riaj0224/DriverlessRoboticNurse_MrWas/Ejemplos/InputCapture/README.md

# InputCapture
Esta carpeta contiene programas para la lectura de sensores y transductores
