riaj0224/DriverlessRoboticNurse_MrWas/Ejemplos/PWM/README.md

# PWM
Esta carpeta contiene programas para el control de componentes por PWM
