riaj0224/DriverlessRoboticNurse_MrWas/Ejemplos/UART RX/README.md

# UART RX
Esta carpeta contiene programas para recibir datos por UART
