riaj0224/DriverlessRoboticNurse_MrWas/Ejemplos/UART TX/README.md

# UART TX
En esta carpeta se incluyen programas para la transmisión de datos por UART
