riaj0224/DriverlessRoboticNurse_MrWas/Ejemplos/ADC/README.md

# ADC
Esta carpeta contiene varios programas del funcionamiento de un ADC por uno y varios canales
