riaj0224/DriverlessRoboticNurse_MrWas/Ejemplos/README.md

# EJEMPLOS
Esta carpeta contiene los ejemplos de todos los programas hechos hasta el momento para diferentes funciones
