riaj0224/DriverlessRoboticNurse_MrWas/Ejemplos/LPTMR/README.md

# LPTMR
En esta carpeta se incluyen programas para el accionar de un LPTMR, así como su combinación con programas previos
