riaj0224/DriverlessRoboticNurse_MrWas/Ejemplos/GPIO/README.md

# GPIO
Esta carpeta contiene programas de ejemplo para la implementación de la función GPIO del micro
