riaj0224/DriverlessRoboticNurse_MrWas/Doc/manufacturing_drawings.pdf

# Entrega final mecánica reto

# Equipo 3: Violeta

# Laura M Zambrano Gamiño A01630766

# Renatto Tommasi Hernández A01632098

# Jesús Jair Reyes Gutiérrez A01630762

# Susana Monserrat Reyes Márquez A01636161

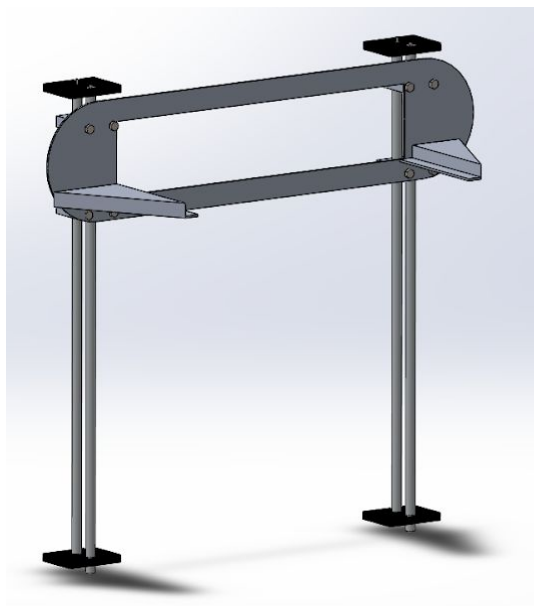
[picture p32: figure]

# Entrega final mecánica reto

# I. Material original

### Materiales Presentes

### Aluminio aleación 1060

### Acero Inoxidable

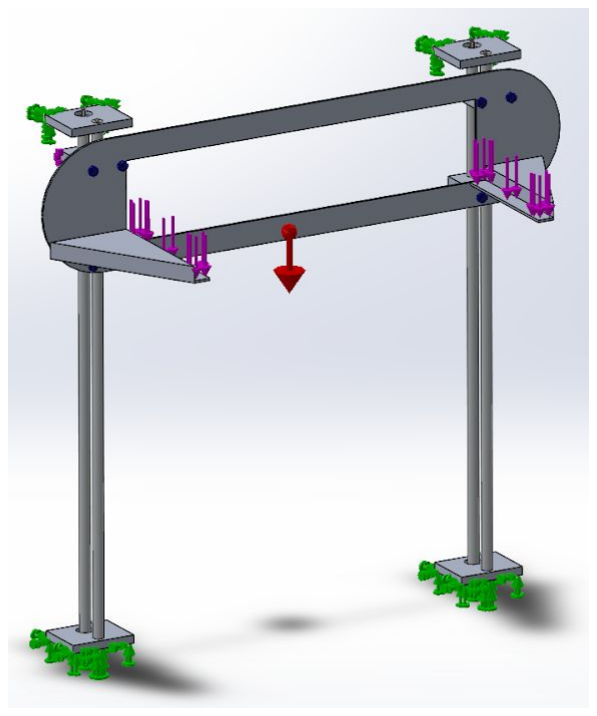
[picture p33: figure]

### Cargas

Nombre/Color | Valor | Ubicación
Gravedad / Rojo | Predeterminado | Estructura
Charola con comida / Morado | 9.81 N | Tenazas

### Resultados

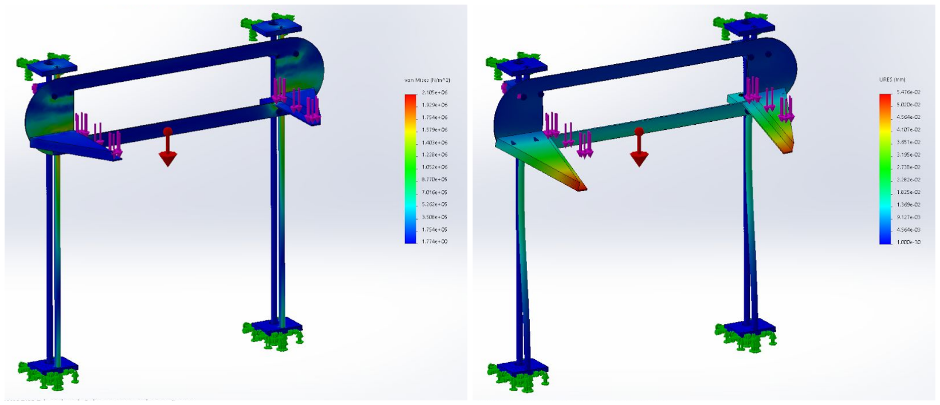
[picture p34: figure]
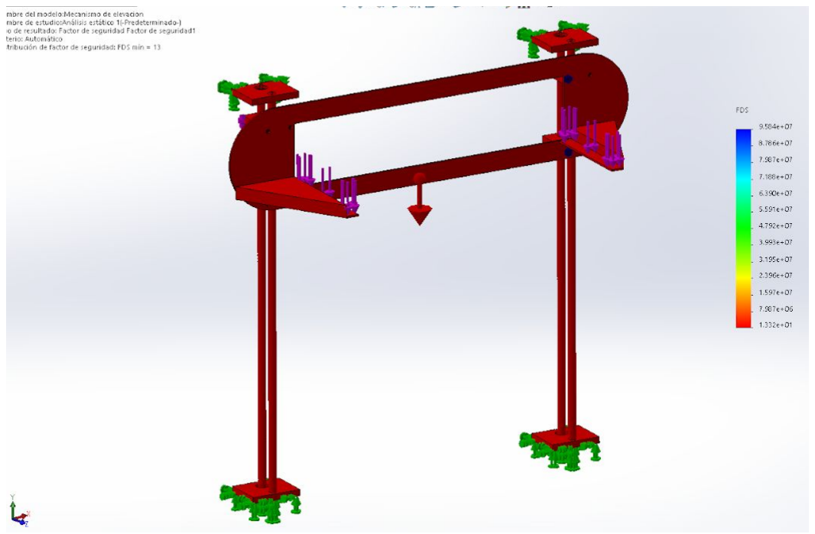
[picture p35: figure]

| Cantidad | Lugar
Esfuerzo mayor | 2.105 MPa | Frente y detrás de los ejes frontales
Esfuerzo menor | 0.001 MPa | Travesaño de la boca, ejes traseros
Desplazamiento mayor | 0.0547 mm | Punta de las tenazas
Desplazamiento menor | 0.000 mm | Ejes traseros, parte superior de boca y bases
Factor de seguridad mínimo | 13

II. | Criterios de selección:
| Para la selección del material, se utilizó el software GRANTA Edupack 2020, con el
| se realizó un extenso filtrado de todos los materiales en el nivel 3 para obtener únicamente
| los que mejor se adaptaran a las necesidades del mecanismo. El primer criterio de filtrado
| consistió en que el nuevo material tuviera tan solo una porción del módulo de Young del
| material original en proporción al factor de seguridad obtenido y al deseado. Esto con el
| propósito de reducirlo lo más posible y acercarlo a uno razonable. Sin embargo, con este
| primer filtrado todavía había varias opciones.
| Ahora bien, el segundo criterio consiste un poco más en tomar en consideración el
| resto de los mecanismos y subensamblajes, pues un cambio importante en el peso se
| traduciría en una reducción del factor de seguridad y por ende un riesgo a toda a la
| estructura. Por lo que el segundo parámetro fue la densidad y esta no podía ser mayor a la
| del material original pues directamente se traduciría en más peso, fuerzas, momentos y
| torsiones. Después de aplicar el segundo filtro, las opciones se redujeron a tan solo 8: 3
| fibras de epoxy con algún otro compuesto, 4 fibras de e - vidrio con otro compuesto y
| carbono impregnado de metal (“metal impregnated carbon”). Este último fue el elegido
| después de consultarlo con otros expertos, dado el extenso desconocimiento sobre el tema.
| Un dato importante es que también se quiso hacer un tercer filtrado de acuerdo con
| el precio, buscando que el material alternativo fuese más barato, pero esto resultó imposible,
| dado que no hubo resultados.

# III. Resultados con material nuevo

### Materiales Presentes

### Aluminio aleación 1060

### Carbón impregnado con metal (Metal Impregnated Carbon)

### Acero Inoxidable

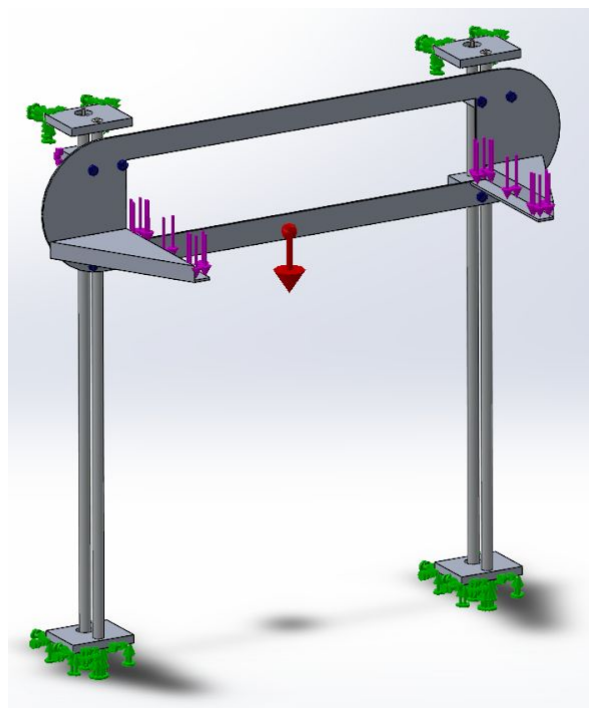
[picture p36: figure]

### Cargas

Nombre/Color | Valor | Ubicación
Gravedad / Rojo | Predeterminado | Estructura
Charola con comida / Morado | 9.81 N | Tenazas

### Resultados

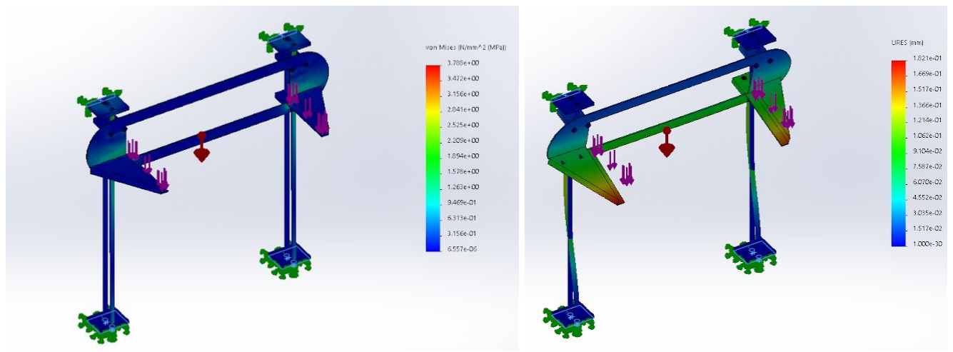
[picture p37: figure]
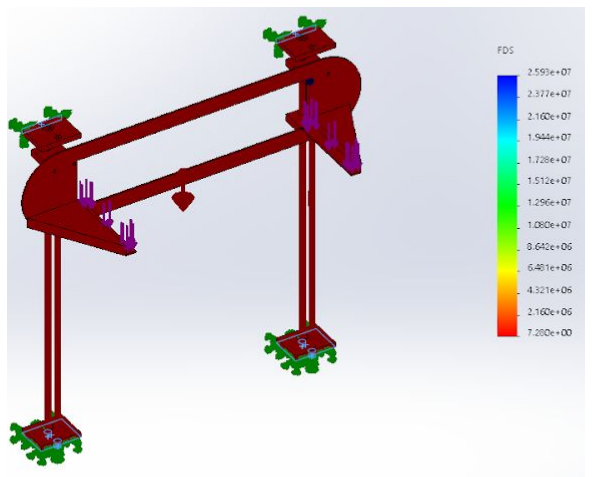
[picture p38: figure]

| Cantidad | Lugar
Esfuerzo mayor | 3.788 Mpa | Frente y detrás de los ejes frontales
Esfuerzo menor | 0.001 MPa | Travesaño de la boca, ejes traseros
Desplazamiento mayor | 0.1821 mm | Punta de las tenazas
Desplazamiento menor | 0.000 mm | Ejes traseros, parte superior de boca y bases
Factor de seguridad mínimo | 7.3

IV. | Comparación y análisis
| Tras el análisis de elemento finito realizado en el mecanismo con los dos materiales

diferentes, podemos concluir varias cosas. Lo primero que cabe resaltar es que únicamente fueron

reemplazadas 2 piezas: el material de los ejes lineales que originalmente eran de acero inoxidable.

El diseño original brindaba gran rigidez al mecanismo, evitando que se deformara por cualquier

exceso de peso. Esto creó un mecanismo muy robusto de un factor de seguridad muy alto. A causa

de esto, el peso de los ejes de acero inoxidable era bastante significante y podría llegar a presentar

mucho gasto de batería en el tren motriz del robot. Podemos observar que gracias a que el nuevo

material tiene una menor densidad y menor resistencia, el mecanismo llega a deformarse antes que

el diseño original, pero sigue estando dentro del espectro donde se consideraría que el diseño es

suficientemente robusto para un sistema de constante movimiento. Además, gracias a la menor

densidad del material, el peso del mecanismo en general se vió ampliamente reducido. Ambos

materiales le ofrecen al mecanismo gran rigidez y tenacidad, A pesar de que el acero inoxidable es

# más rígido que el carbón, el nuevo material le permite al mecanismo aprovechar mejor las

propiedades mecánicas del mismo.

# V. Conclusión

| Se redujo considerablemente el factor de seguridad, lo que se puede traducir a que el

material más sobrado e innecesario es la primera opción, el acero inoxidable. La seguridad es uno

de los puntos más importantes al diseñar cualquier cosa, pero tener un factor de seguridad tan

sobrado significa que el material elegido no está siendo aprovechado al máximo y que se debería

# buscar algún otro. La tecnología actual permite la creación de materiales con propiedades

mecánicas diferentes, que se pueden adaptar mejor a las necesidades del usuario, el carbón

impregnado con metal es uno de estos materiales. El acero inoxidable es más común en el mercado y como es demostrado en el estudio presentado es un material resistente, pero quizá demasiado

resistente para el uso que se le da en este mecanismo. El carbón impregnado con metal es un

material muy nuevo, de ahí que no tenga muchos distribuidores y el precio esté más elevado, pero

se acomoda mejor a nuestro diseño demostrando tener un factor de seguridad menor. En caso de

que el presente robot se fabricara de forma rápida, la mejor opción sería quedarse con el acero

inoxidable por su facilidad de compra.

# VI. Bibliografía

# Metal impregnated carbon. (n.d.). GRANTA EduPack

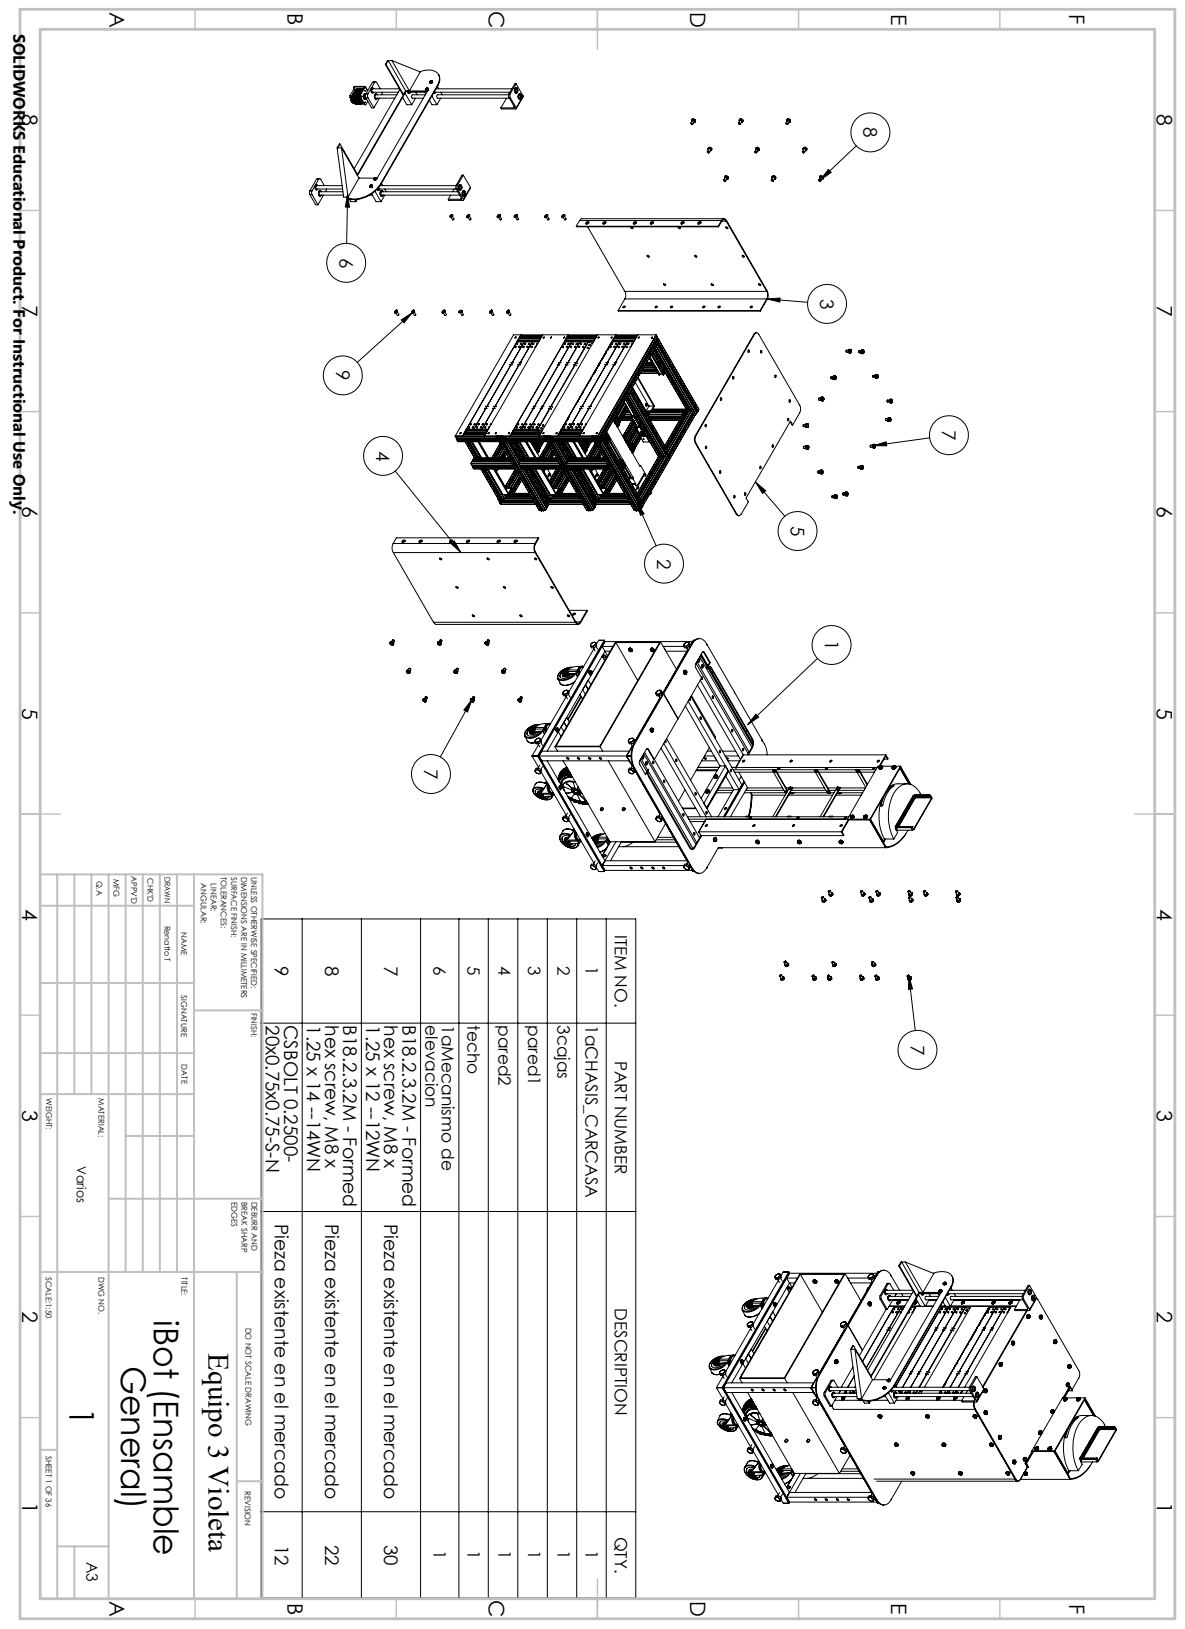
[picture p39: page 9]
1 1aCHASIS_CARCASA 1; 2 3cajas 1; 3 pared1 1; 4 pared2 1; 5 techo 1; 6 elevacion; 1aMecanismo de 1; hex screw, M8 x B18.2.3.2M - Formed; MFG; APPV'D; CHK'D; DRAWN; ANGULAR:; LINEAR:; TOLERANCES:; SURFACE FINISH:; EDGES BREAK SHARP; DEBURR AND; MATERIAL:; SCALE:1:50; DWG NO.; TITLE:; SHEET 1 OF 36; A3 Varios; WEIGHT:; Renatto T; Equipo 3 Violeta

SOLIDWORKS Educational Product. For Instructional Use Only.

DIMENSIONS ARE IN MILLIMETERS

UNLESS OTHERWISE SPECIFIED: FINISH:

NAME SIGNATURE DATE

ITEM NO. PART NUMBER DESCRIPTION QTY.

CSBOLT 0.2500- Pieza existente en el mercado 12

Pieza existente en el mercado 22

Pieza existente en el mercado 30

iBot (Ensamble General)

DO NOT SCALE DRAWING REVISION

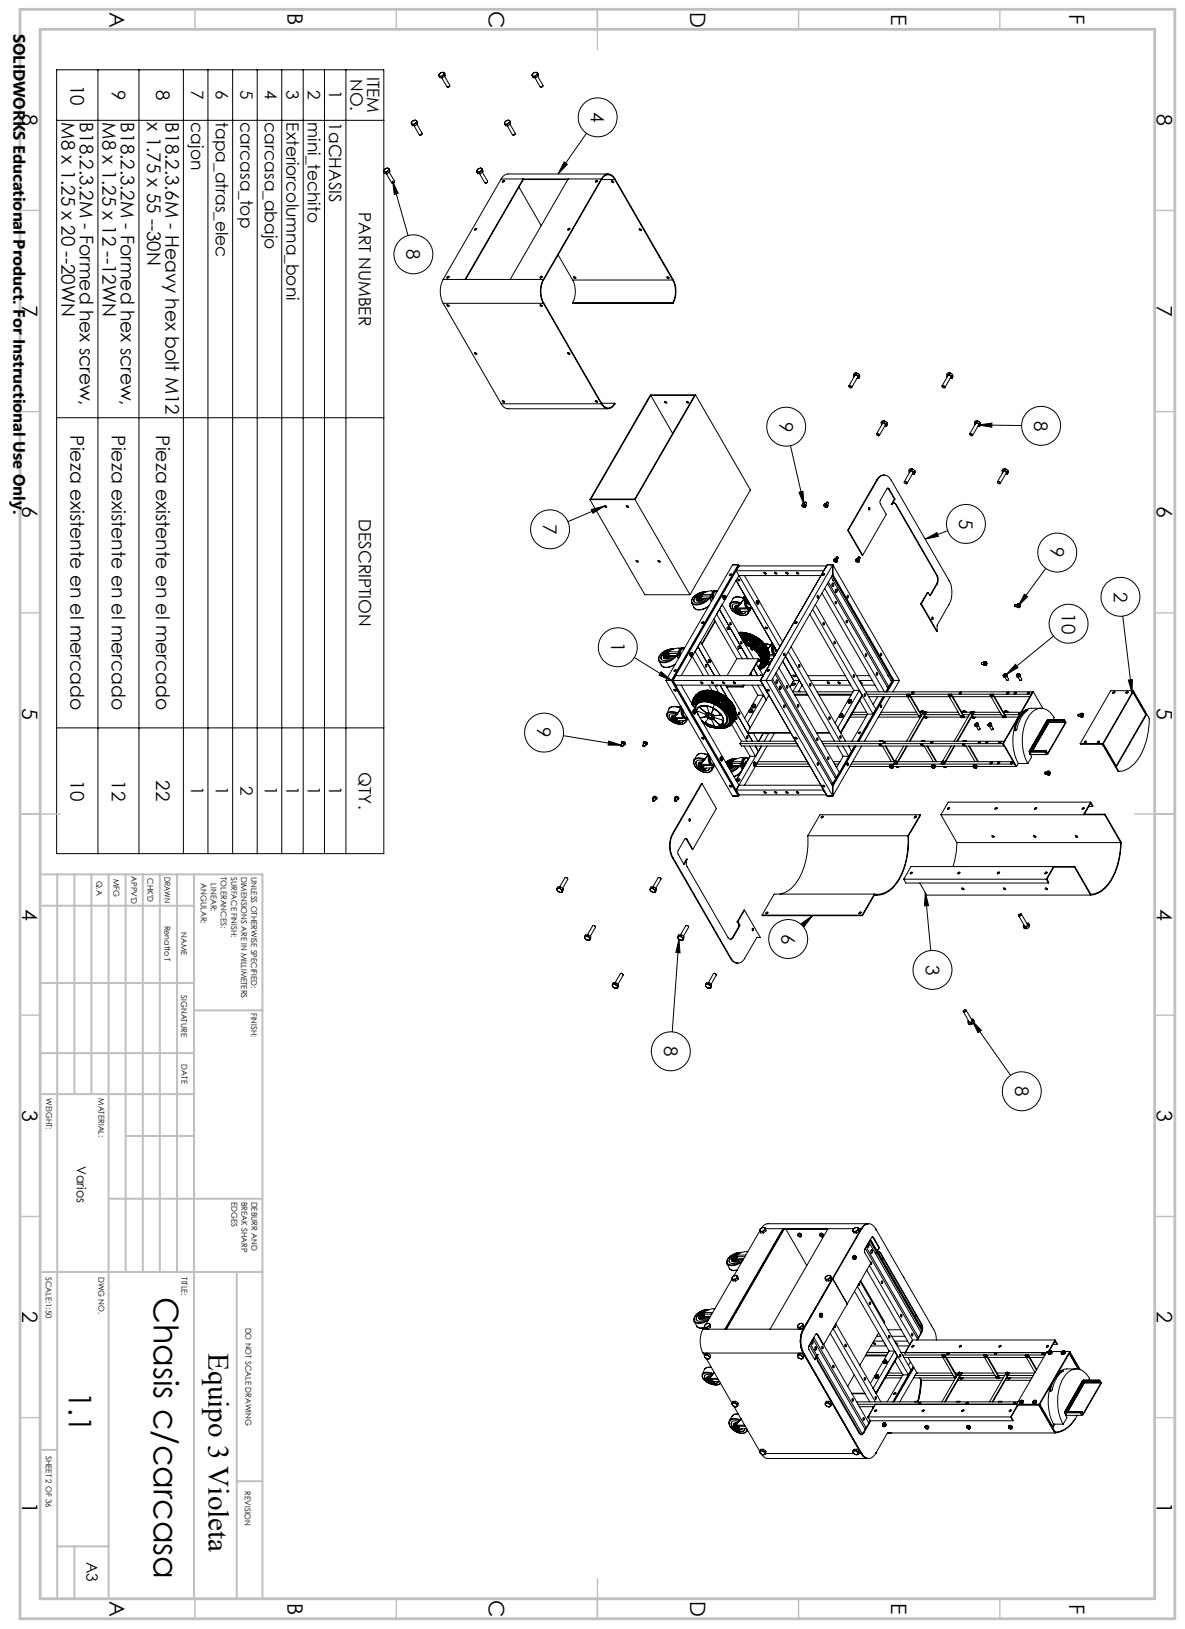
[picture p40: page 10]
NO. 1 1aCHASIS 1 2 mini_techito 1 3 Exteriorcolumna_boni 1 4 carcasa_abajo 1; 5 carcasa_top 2; 6 tapa_atras_elec 1; 7 cajon 1; MFG; APPV'D; CHK'D; DRAWN; ANGULAR:; LINEAR:; TOLERANCES:; SURFACE FINISH:; EDGES BREAK SHARP; DEBURR AND; MATERIAL:; SCALE:1:50; DWG NO.; TITLE:; SHEET 2 OF 36; A3 Varios; WEIGHT:; Renatto T; Equipo 3 Violeta; Chasis c/carcasa

SOLIDWORKS Educational Product. For Instructional Use Only.

ITEM PART NUMBER DESCRIPTION QTY.

B18.2.3.2M - Formed hex screw, Pieza existente en el mercado 10

B18.2.3.2M - Formed hex screw, Pieza existente en el mercado 12

B18.2.3.6M - Heavy hex bolt M12 Pieza existente en el mercado 22

DIMENSIONS ARE IN MILLIMETERS

UNLESS OTHERWISE SPECIFIED: FINISH:

NAME SIGNATURE DATE

DO NOT SCALE DRAWING REVISION

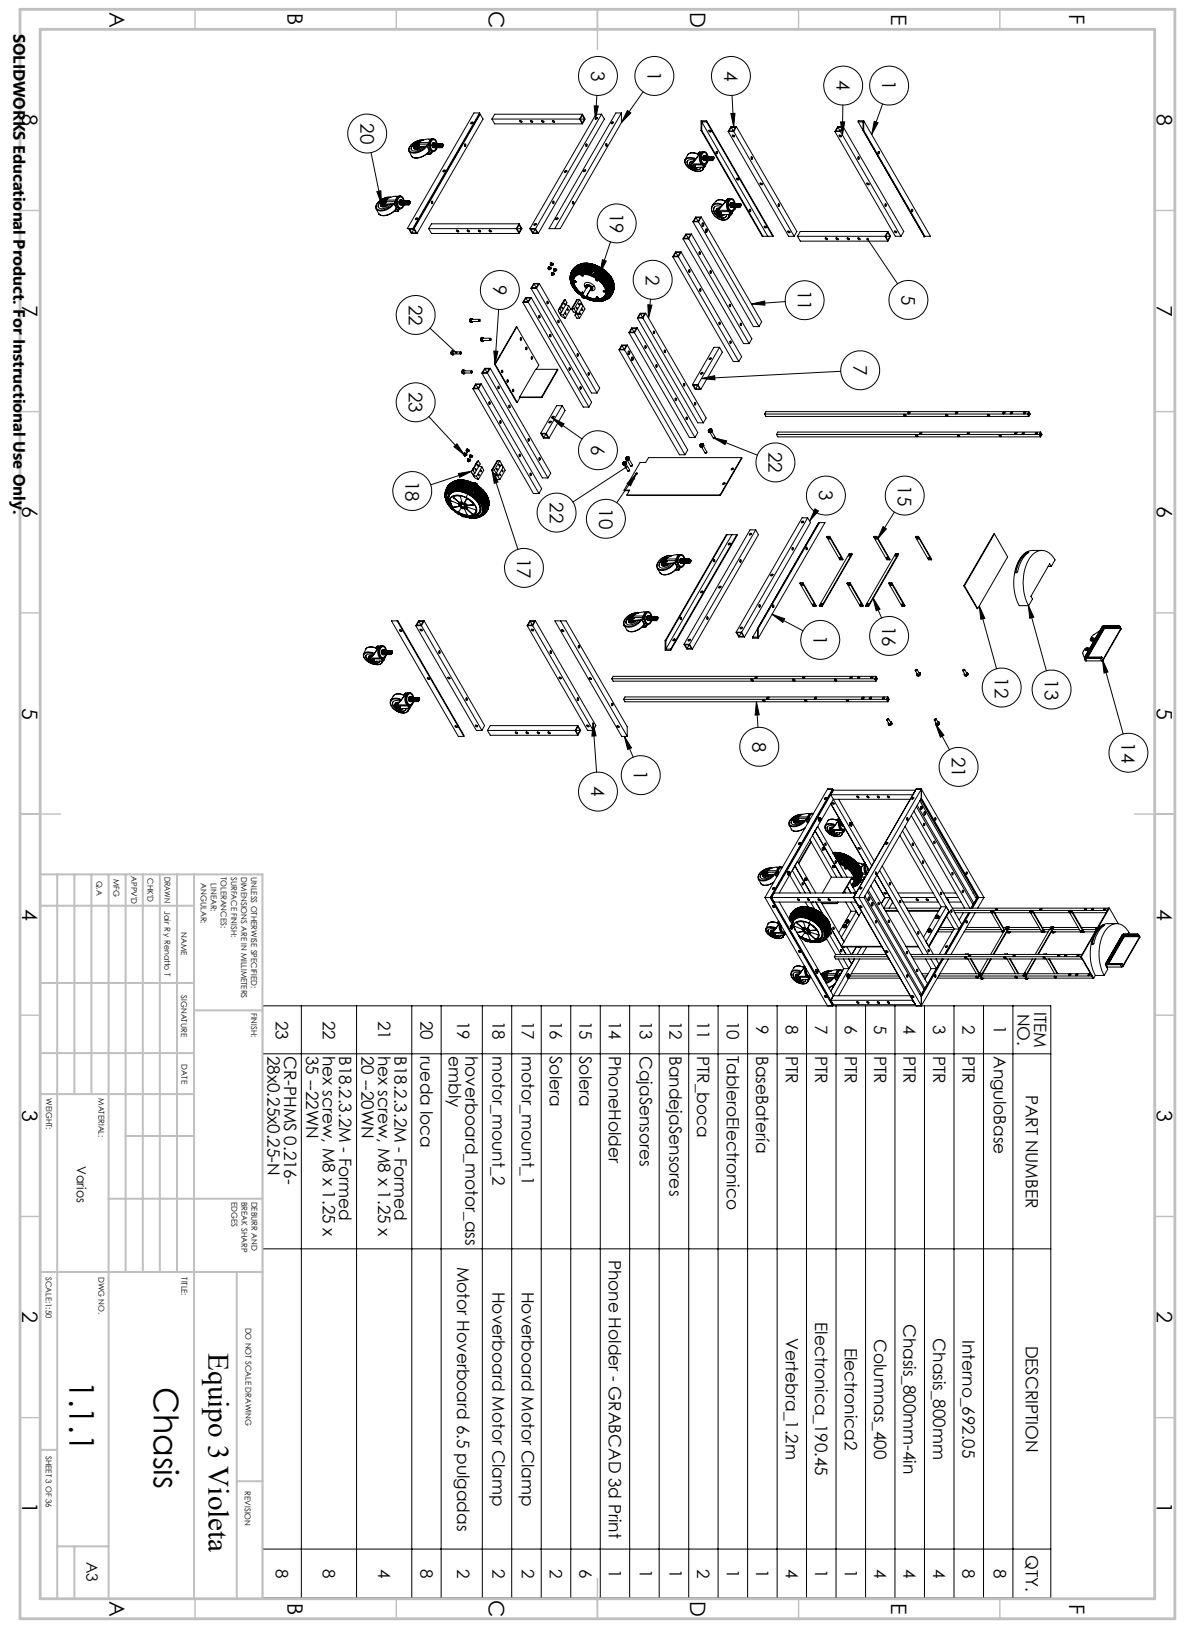
[picture p41: page 11]
1 AnguloBase 8; 2 PTR Interno_692.05 8; 3 PTR Chasis_800mm 4; 4 PTR Chasis_800mm-4in 4; 5 PTR Columnas_400 4; 6 PTR Electronica2 1; 7 PTR Electronica_190.45 1; 8 PTR Vertebra_1.2m 4; 9 BaseBatería 1; 10 TableroElectronico 1; 11 PTR_boca 2; 12 BandejaSensores 1; 13 CajaSensores 1; 15 Solera 6; 16 Solera 2; 19 embly; 20 rueda loca 8; 20 --20WN hex screw, M8 x 1.25 x; B18.2.3.2M - Formed; 35 --22WN hex screw, M8 x 1.25 x; 23 28x0.25x0.25-N CR-PHMS 0.216- 8; MFG; APPV'D; CHK'D; DRAWN; ANGULAR: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

SOLIDWORKS Educational Product. For Instructional Use Only.

DIMENSIONS ARE IN MILLIMETERS

UNLESS OTHERWISE SPECIFIED: FINISH:

NAME SIGNATURE DATE

18 motor_mount_2 Hoverboard Motor Clamp 2

17 motor_mount_1 Hoverboard Motor Clamp 2

14 PhoneHolder Phone Holder - GRABCAD 3d Print 1

ITEM PART NUMBER DESCRIPTION QTY.

hoverboard_motor_ass Motor Hoverboard 6.5 pulgadas 2

DO NOT SCALE DRAWING REVISION

22.23
22.23

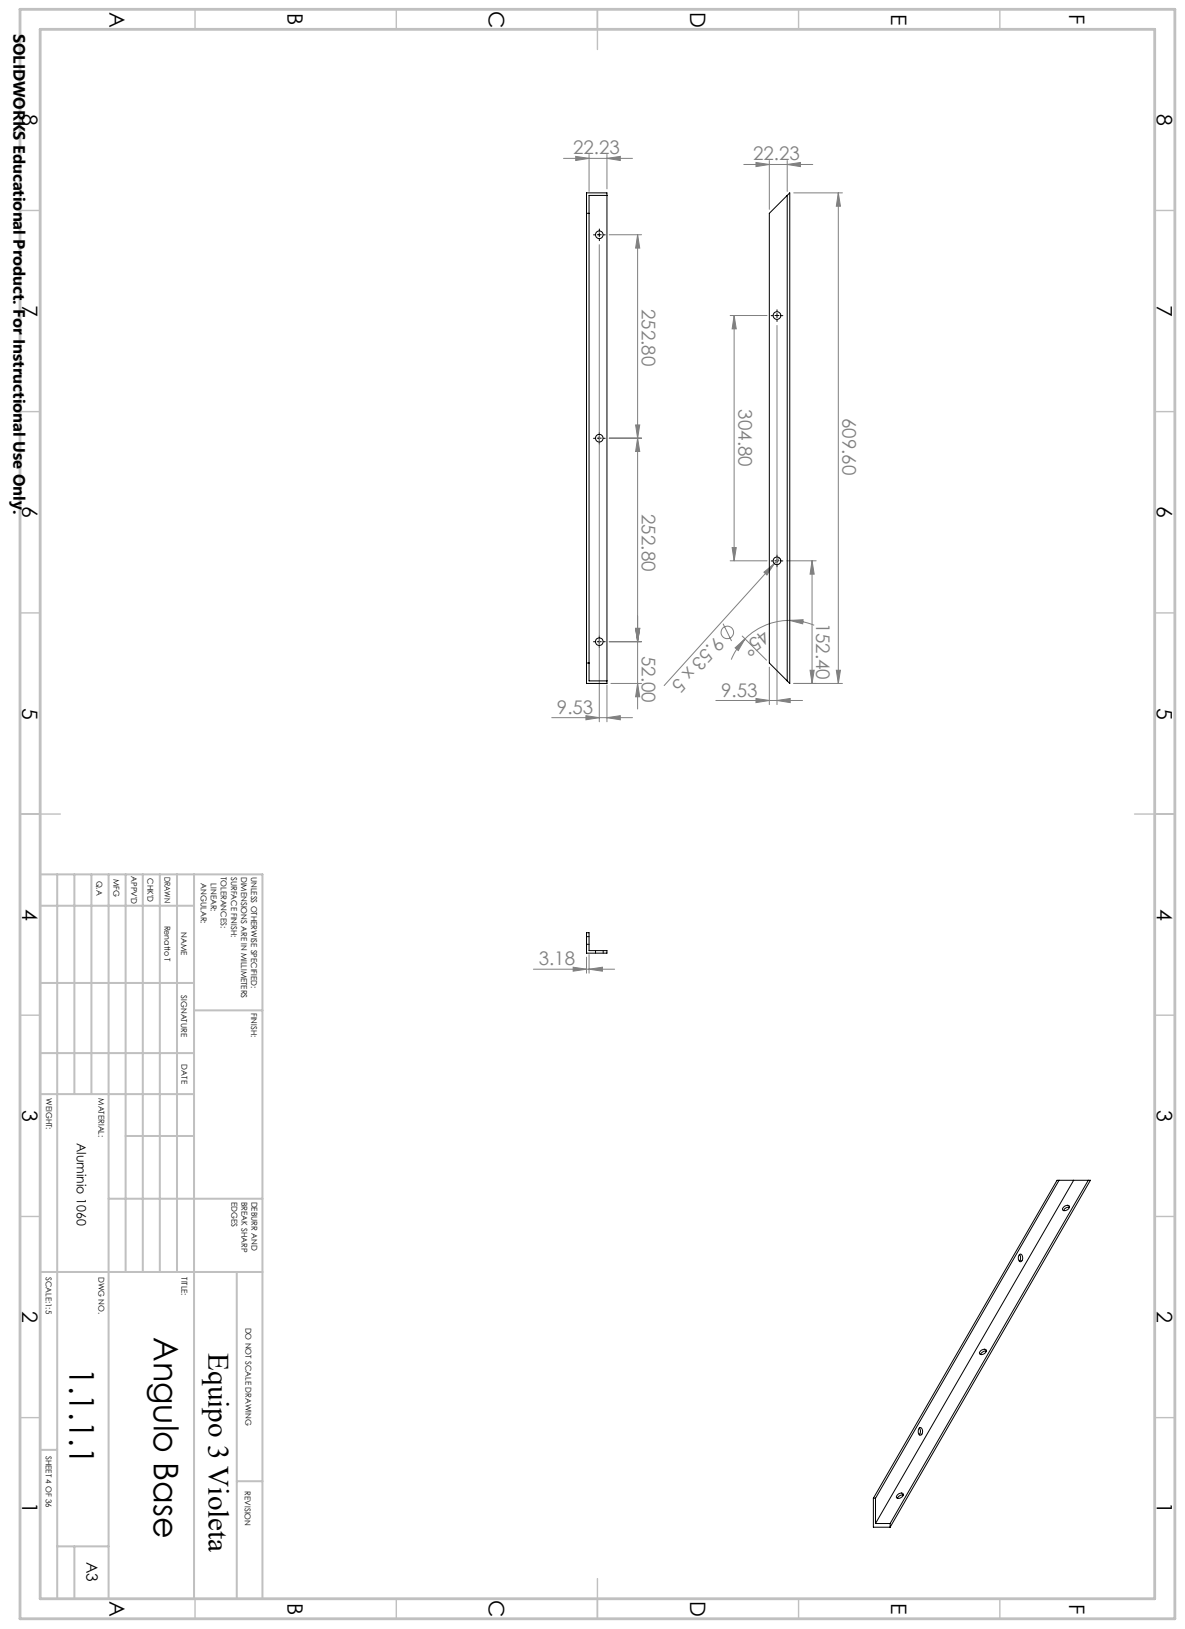
[picture p42: page 12]
MFG; APPV'D; CHK'D; DRAWN; ANGULAR:; LINEAR:; TOLERANCES:; SURFACE FINISH:; EDGES BREAK SHARP; DEBURR AND; MATERIAL:; SCALE:1:5; DWG NO.; TITLE:; SHEET 4 OF 36; A3 Aluminio 1060; WEIGHT:; Renatto T; Equipo 3 Violeta; Angulo Base

SOLIDWORKS Educational Product. For Instructional Use Only.

DIMENSIONS ARE IN MILLIMETERS

UNLESS OTHERWISE SPECIFIED: FINISH:

NAME SIGNATURE DATE

DO NOT SCALE DRAWING REVISION

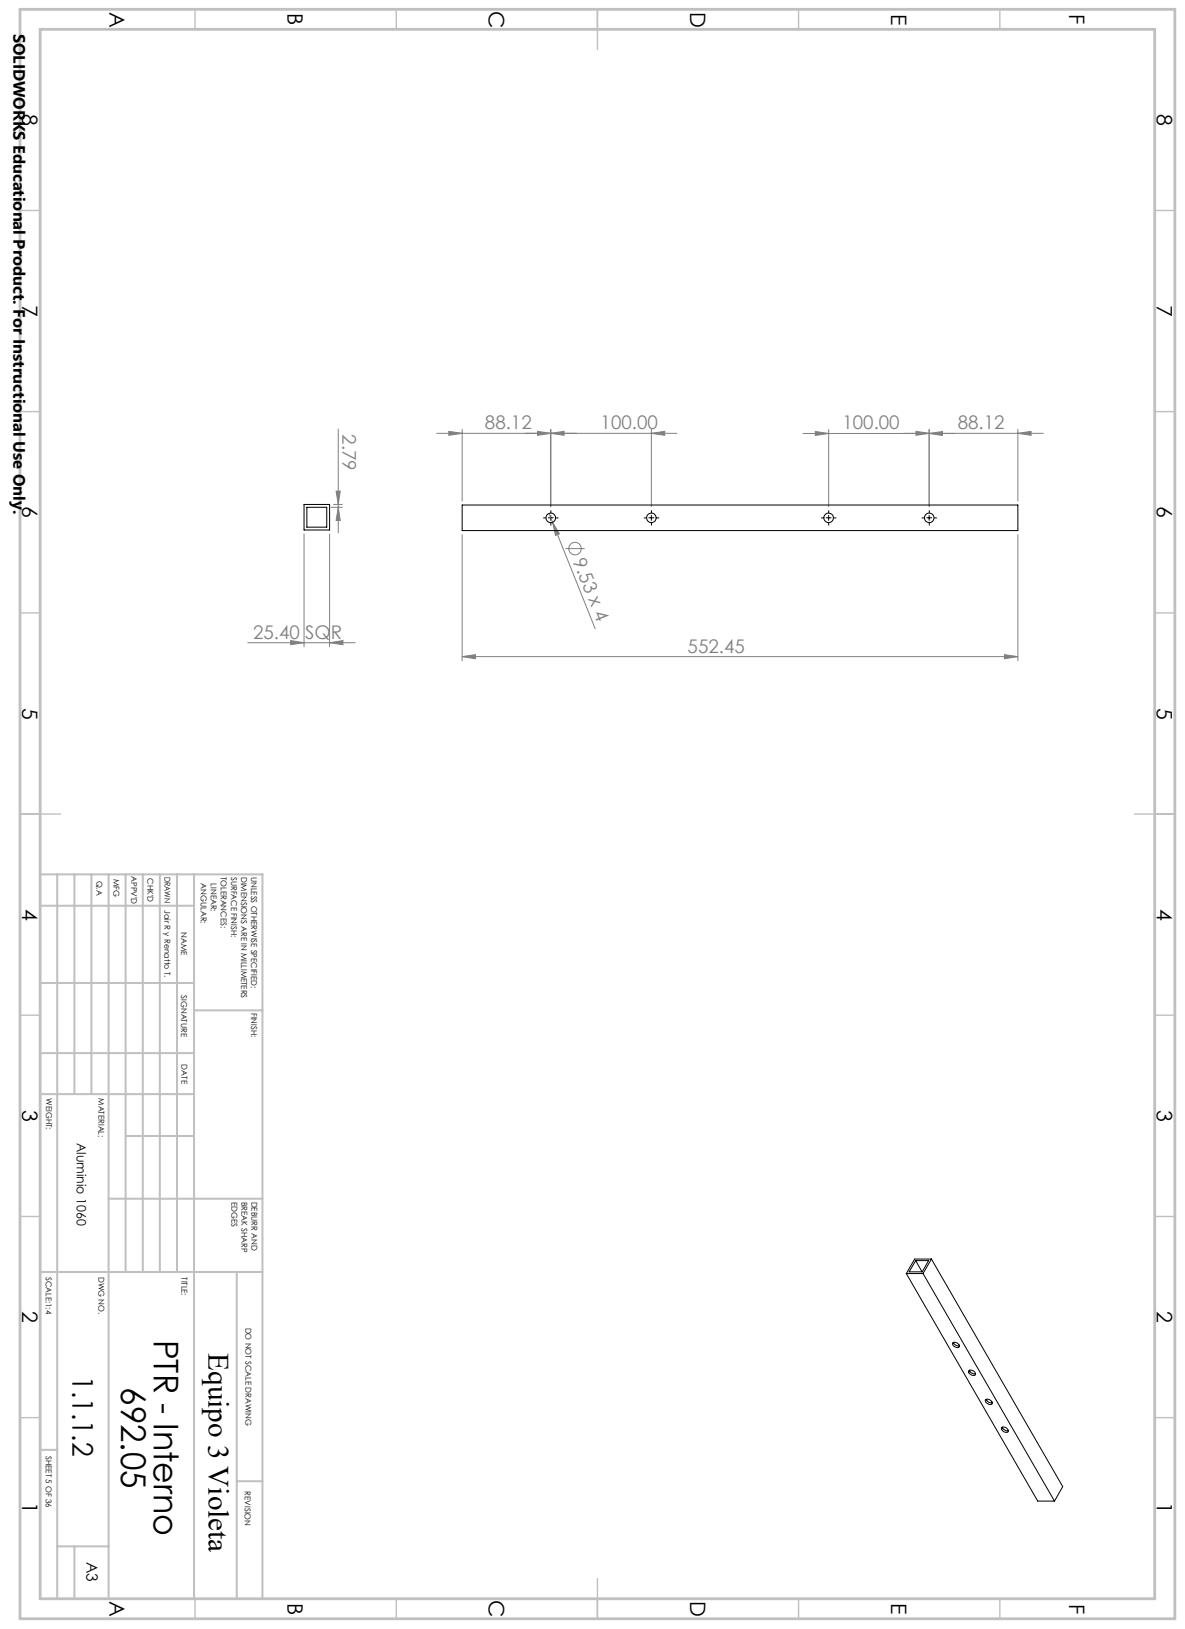
[picture p43: page 13]
25.40 SQR; MFG; APPV'D; CHK'D; DRAWN; ANGULAR:; LINEAR:; TOLERANCES:; SURFACE FINISH:; EDGES BREAK SHARP; DEBURR AND; MATERIAL:; SCALE:1:4; DWG NO.; TITLE:; SHEET 5 OF 36; A3 Aluminio 1060; WEIGHT:; Jair R y Renatto T.; Equipo 3 Violeta; PTR - Interno 692.05

SOLIDWORKS Educational Product. For Instructional Use Only.

DIMENSIONS ARE IN MILLIMETERS

UNLESS OTHERWISE SPECIFIED: FINISH:

NAME SIGNATURE DATE

DO NOT SCALE DRAWING REVISION

150.81 | 150.81

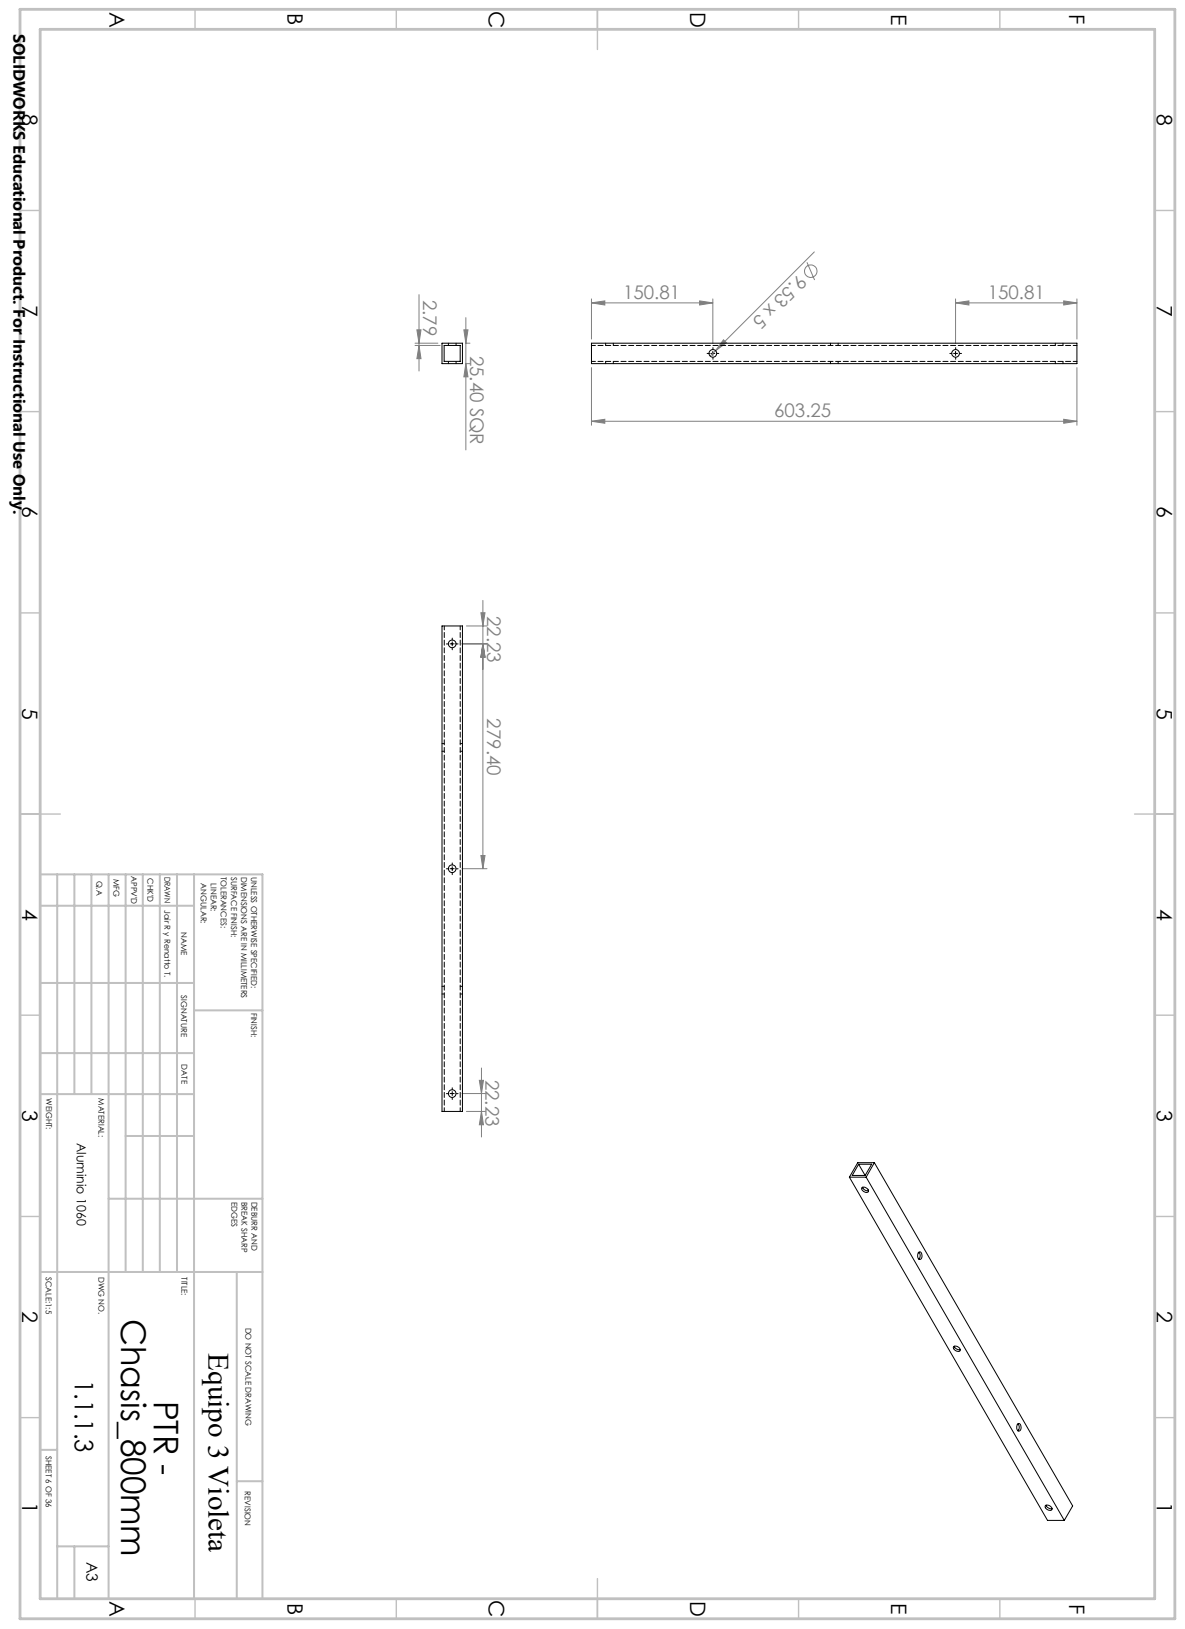
[picture p44: page 14]
25.40 SQR; MFG; APPV'D; CHK'D; DRAWN; ANGULAR:; LINEAR:; TOLERANCES:; SURFACE FINISH:; EDGES BREAK SHARP; DEBURR AND; MATERIAL:; SCALE:1:5; DWG NO.; TITLE:; SHEET 6 OF 36; A3 Aluminio 1060; WEIGHT:; Jair R y Renatto T.; Equipo 3 Violeta; PTR -; Chasis_800mm

SOLIDWORKS Educational Product. For Instructional Use Only.

DIMENSIONS ARE IN MILLIMETERS

UNLESS OTHERWISE SPECIFIED: FINISH:

NAME SIGNATURE DATE

DO NOT SCALE DRAWING REVISION

152.40 | 152.40

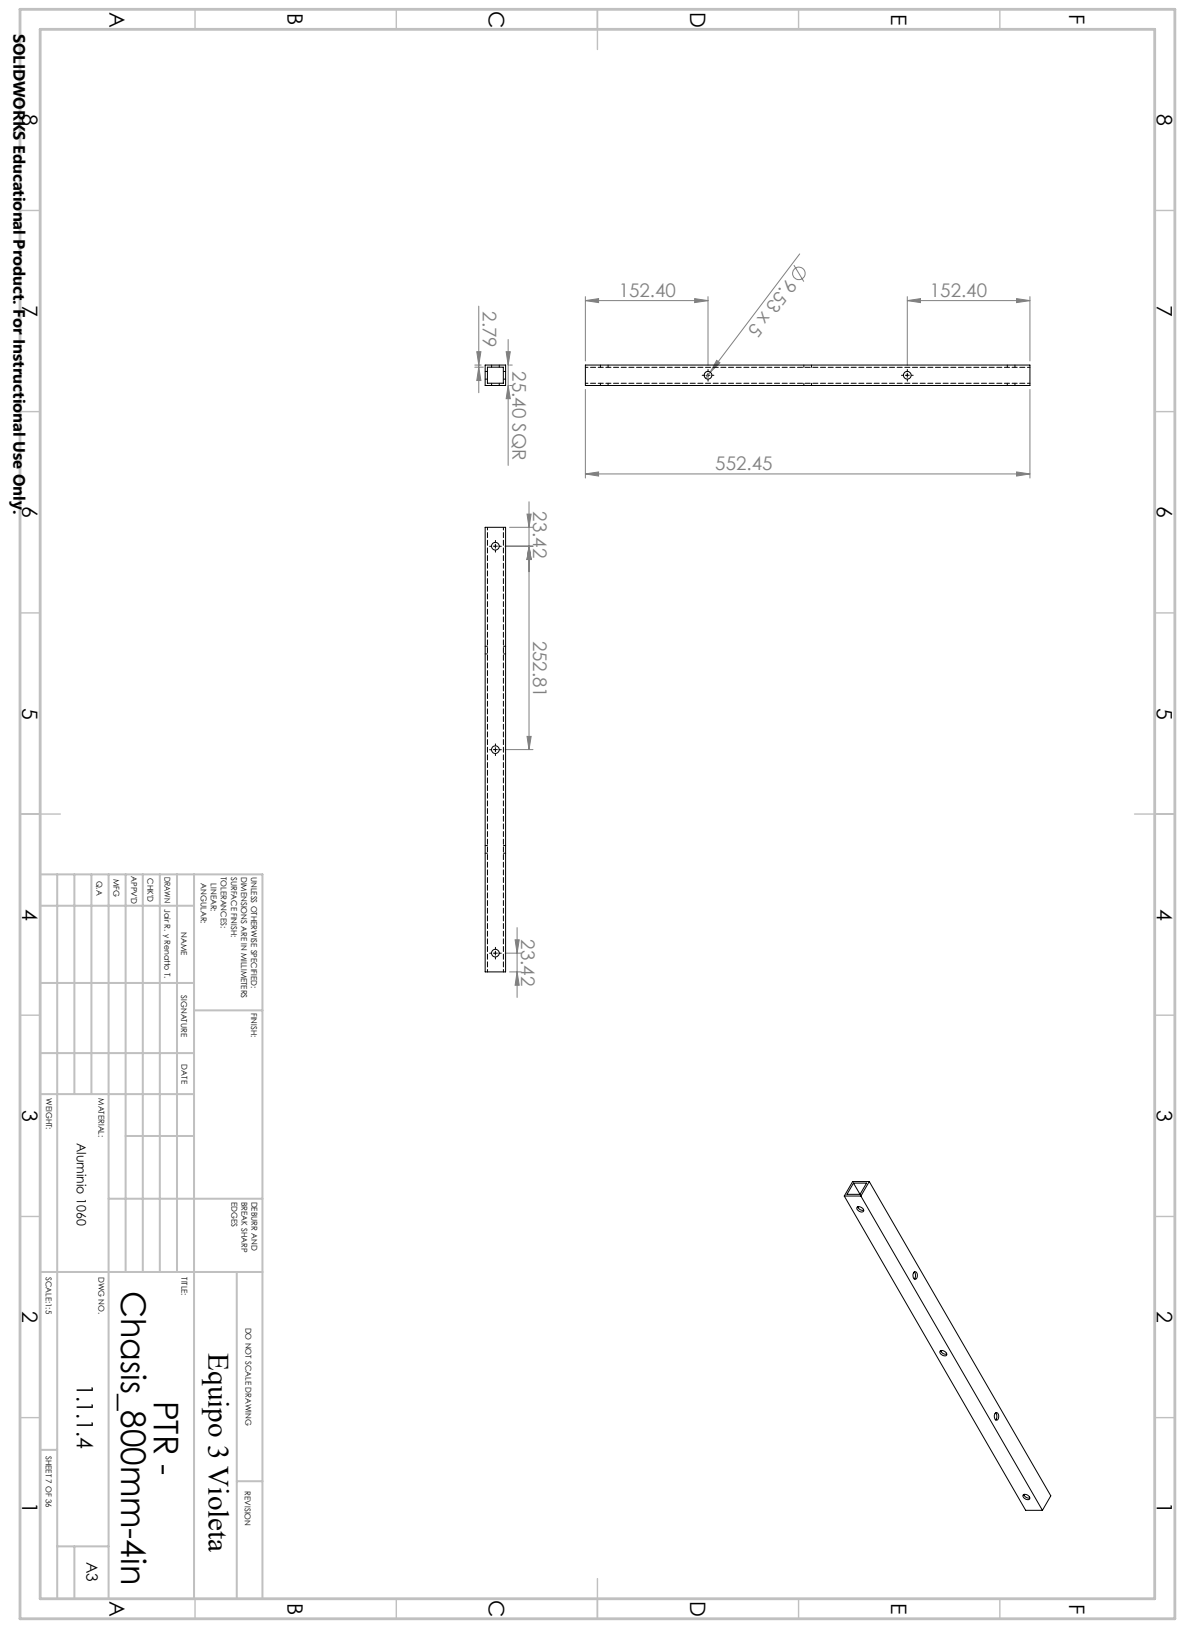
[picture p45: page 15]
25.40 SQR 552.45; MFG; APPV'D; CHK'D; DRAWN; ANGULAR:; LINEAR:; TOLERANCES:; SURFACE FINISH:; EDGES BREAK SHARP; DEBURR AND; MATERIAL:; SCALE:1:5; DWG NO.; TITLE:; SHEET 7 OF 36; A3 Aluminio 1060; WEIGHT:; Jair R. y Renatto T.; Equipo 3 Violeta; PTR -; Chasis_800mm-4in

SOLIDWORKS Educational Product. For Instructional Use Only.

DIMENSIONS ARE IN MILLIMETERS

UNLESS OTHERWISE SPECIFIED: FINISH:

NAME SIGNATURE DATE

DO NOT SCALE DRAWING REVISION

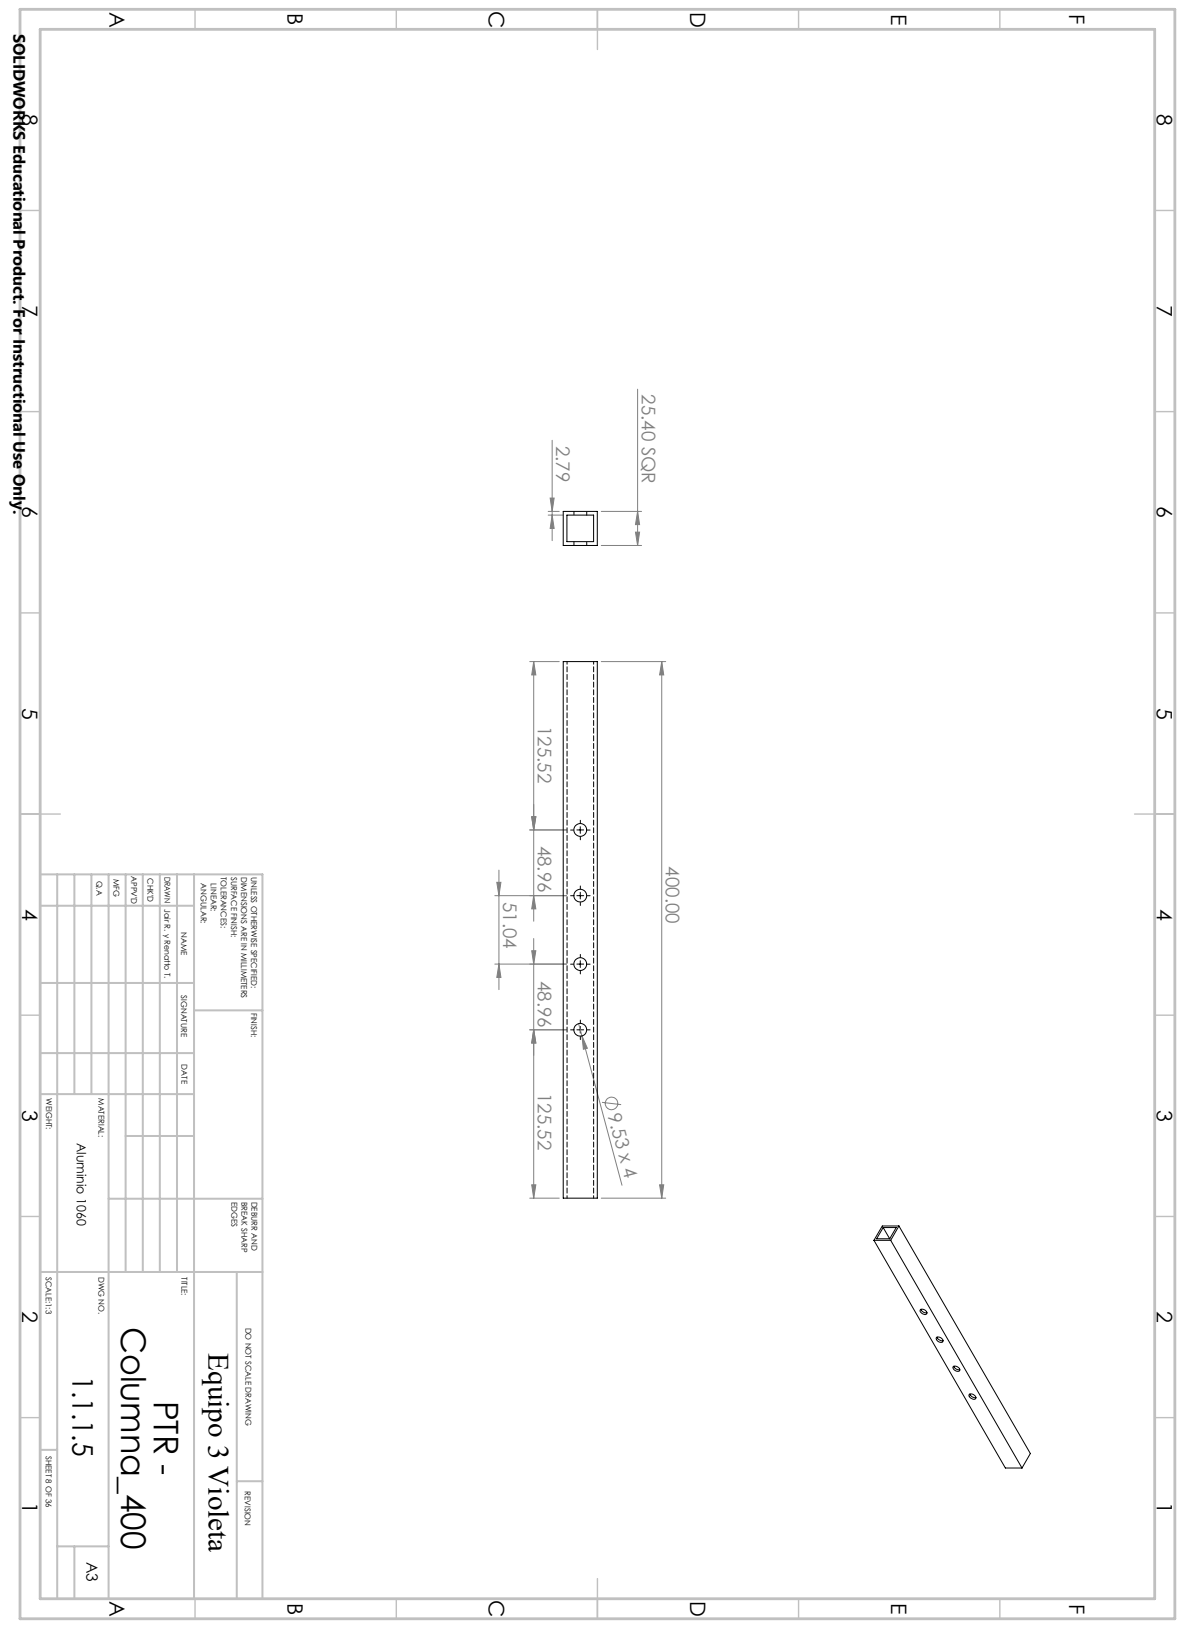
[picture p46: page 16]
25.40 SQR; MFG; APPV'D; CHK'D; DRAWN; ANGULAR:; LINEAR:; TOLERANCES:; SURFACE FINISH:; EDGES BREAK SHARP; DEBURR AND; MATERIAL:; SCALE:1:3; DWG NO.; TITLE:; SHEET 8 OF 36; A3 Aluminio 1060; WEIGHT:; Jair R. y Renatto T.; Equipo 3 Violeta; PTR -; Columna_400

SOLIDWORKS Educational Product. For Instructional Use Only.

DIMENSIONS ARE IN MILLIMETERS

UNLESS OTHERWISE SPECIFIED: FINISH:

NAME SIGNATURE DATE

DO NOT SCALE DRAWING REVISION

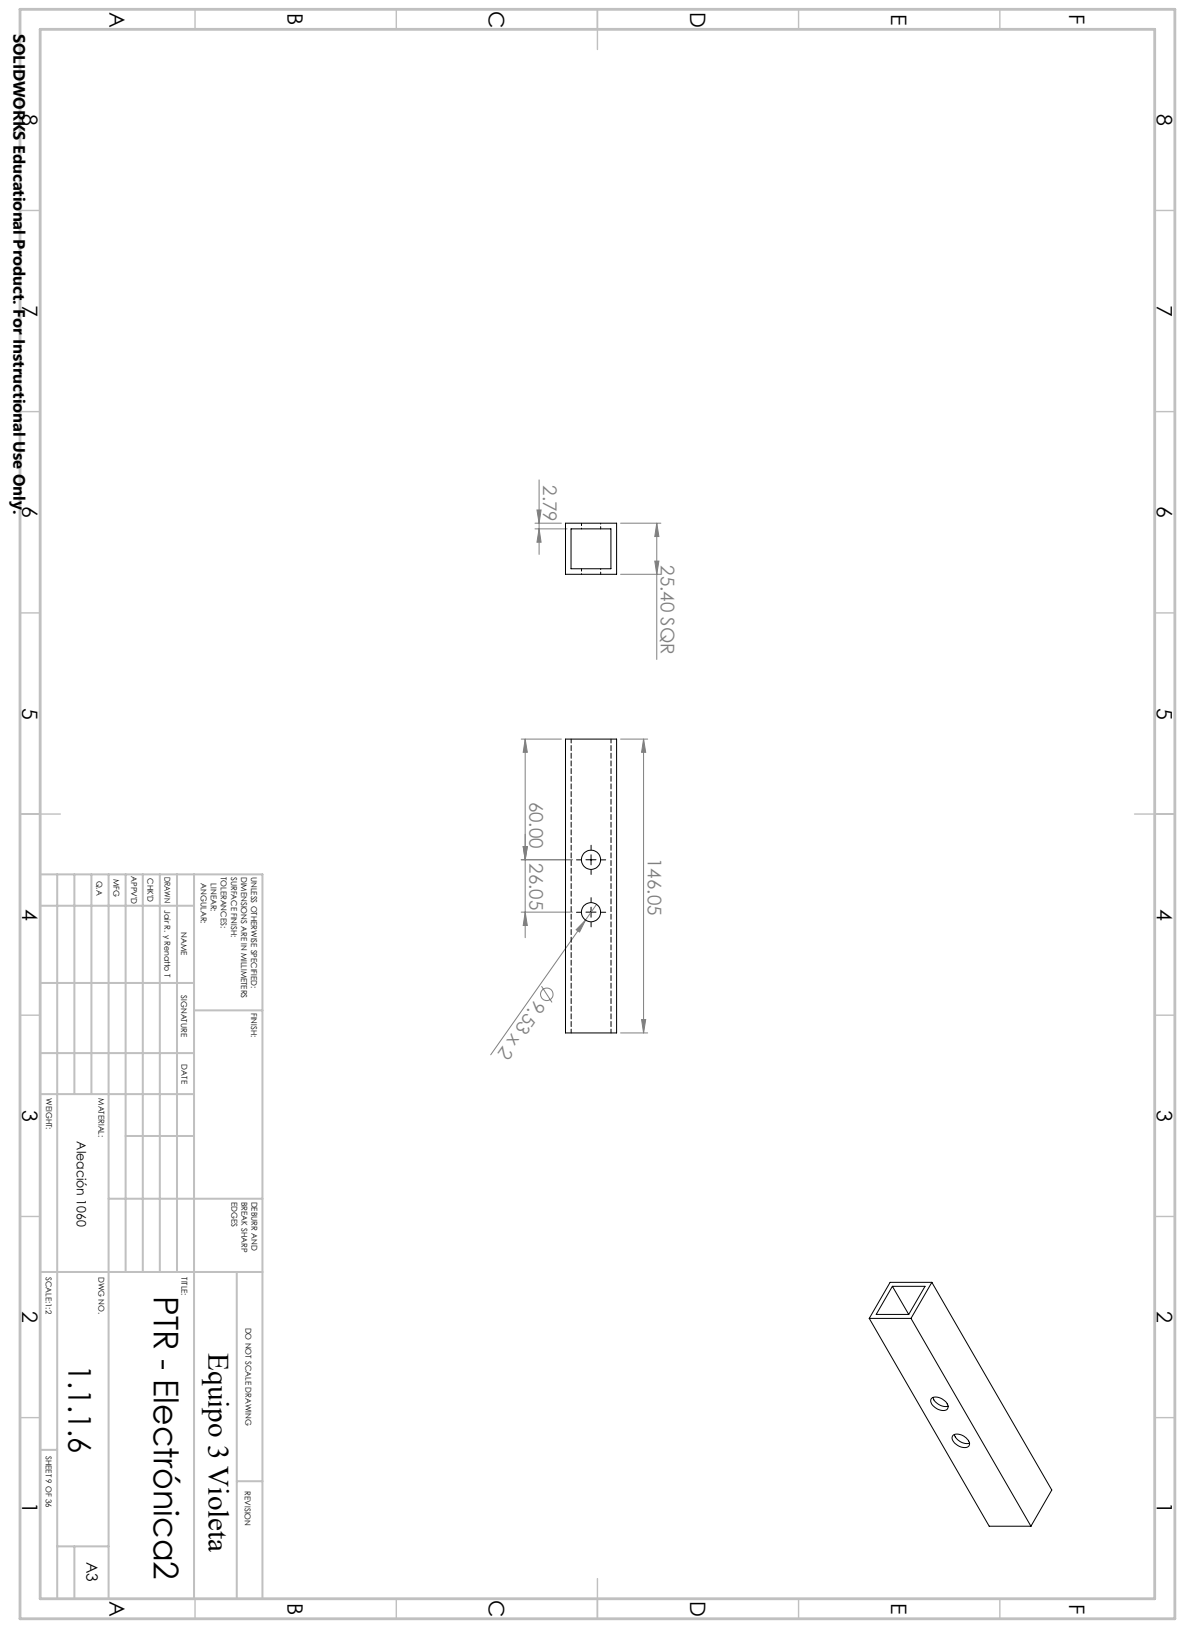
[picture p47: page 17]
25.40 SQR 146.05; MFG; APPV'D; CHK'D; DRAWN; ANGULAR:; LINEAR:; TOLERANCES:; SURFACE FINISH:; EDGES BREAK SHARP; DEBURR AND; MATERIAL:; SCALE:1:2; DWG NO.; TITLE:; SHEET 9 OF 36; A3 Aleación 1060; WEIGHT:; Jair R. y Renatto T; Equipo 3 Violeta; PTR - Electrónica2

SOLIDWORKS Educational Product. For Instructional Use Only.

DIMENSIONS ARE IN MILLIMETERS

UNLESS OTHERWISE SPECIFIED: FINISH:

NAME SIGNATURE DATE

DO NOT SCALE DRAWING REVISION

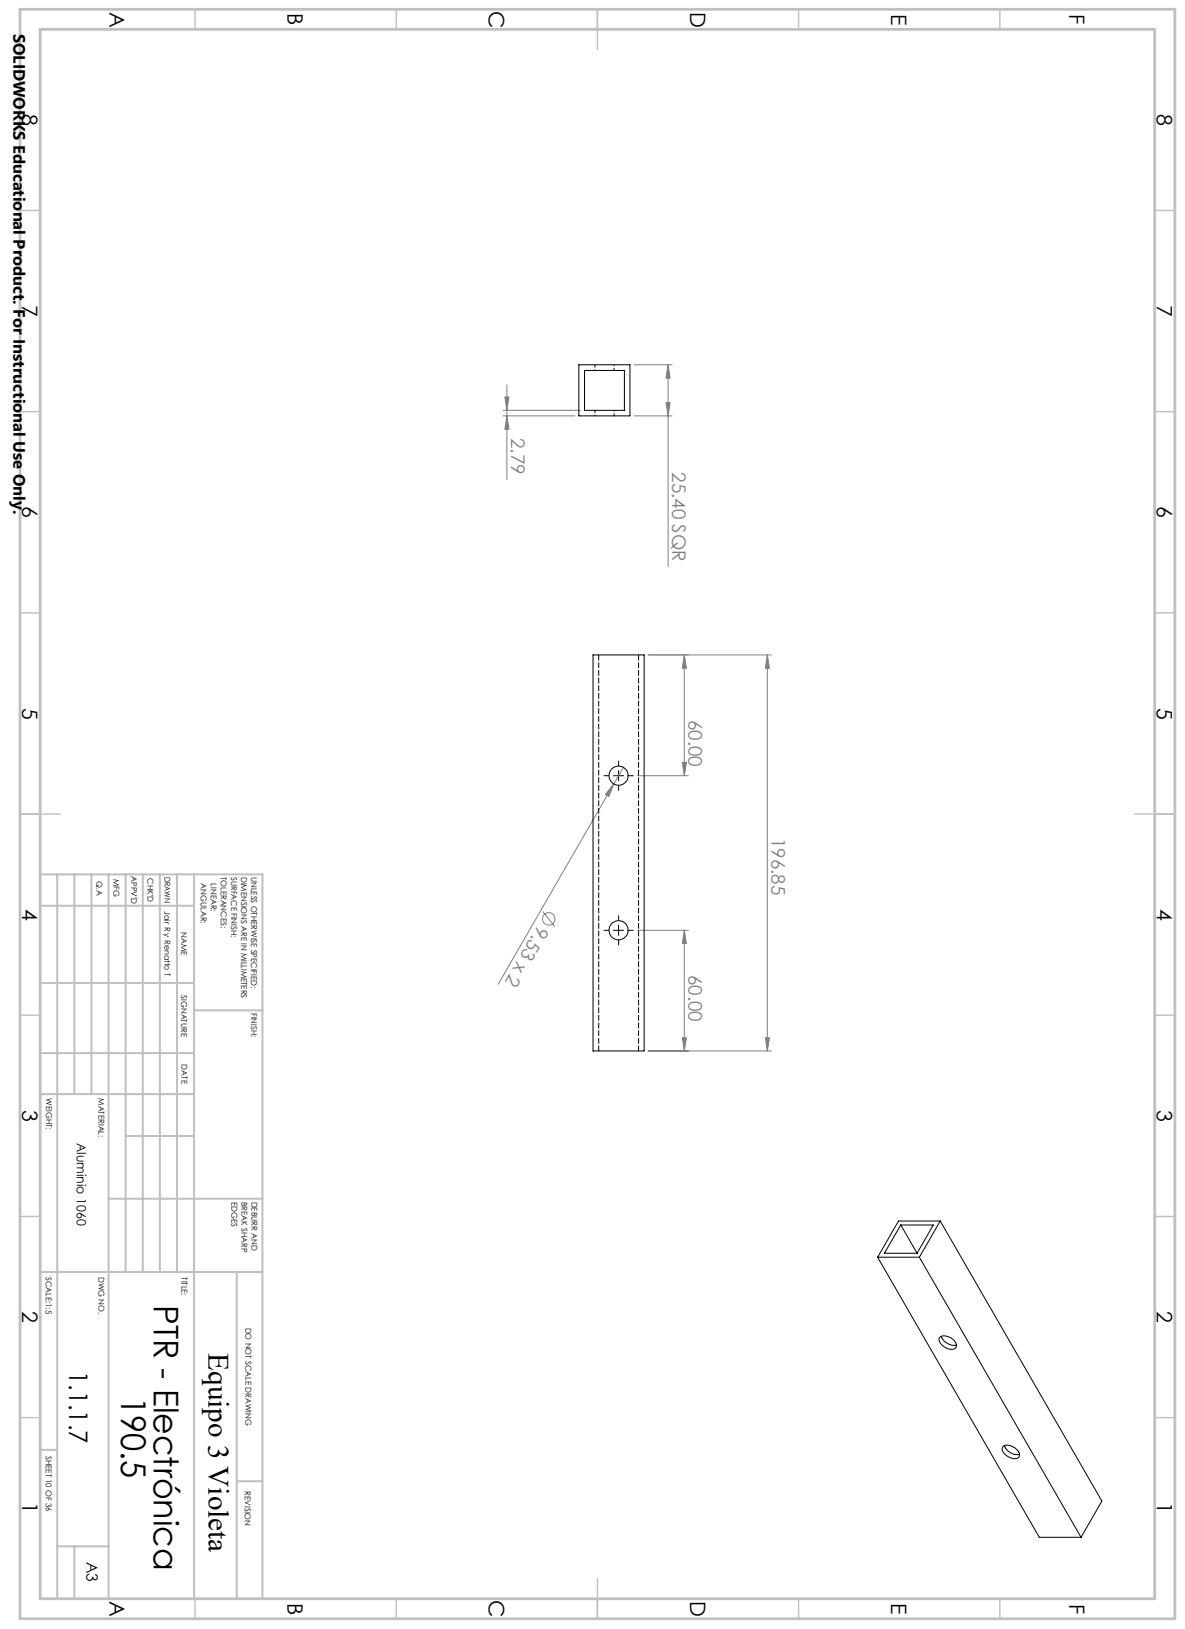
[picture p48: page 18]
25.40 SQR; MFG; APPV'D; CHK'D; DRAWN; ANGULAR:; LINEAR:; TOLERANCES:; SURFACE FINISH:; EDGES BREAK SHARP; DEBURR AND; MATERIAL:; SCALE:1:5; DWG NO.; TITLE:; SHEET 10 OF 36; A3 Aluminio 1060; WEIGHT:; Jair R y Renatto T; Equipo 3 Violeta; PTR - Electrónica

SOLIDWORKS Educational Product. For Instructional Use Only.

DIMENSIONS ARE IN MILLIMETERS

UNLESS OTHERWISE SPECIFIED: FINISH:

NAME SIGNATURE DATE

DO NOT SCALE DRAWING REVISION

1200.00

16.02

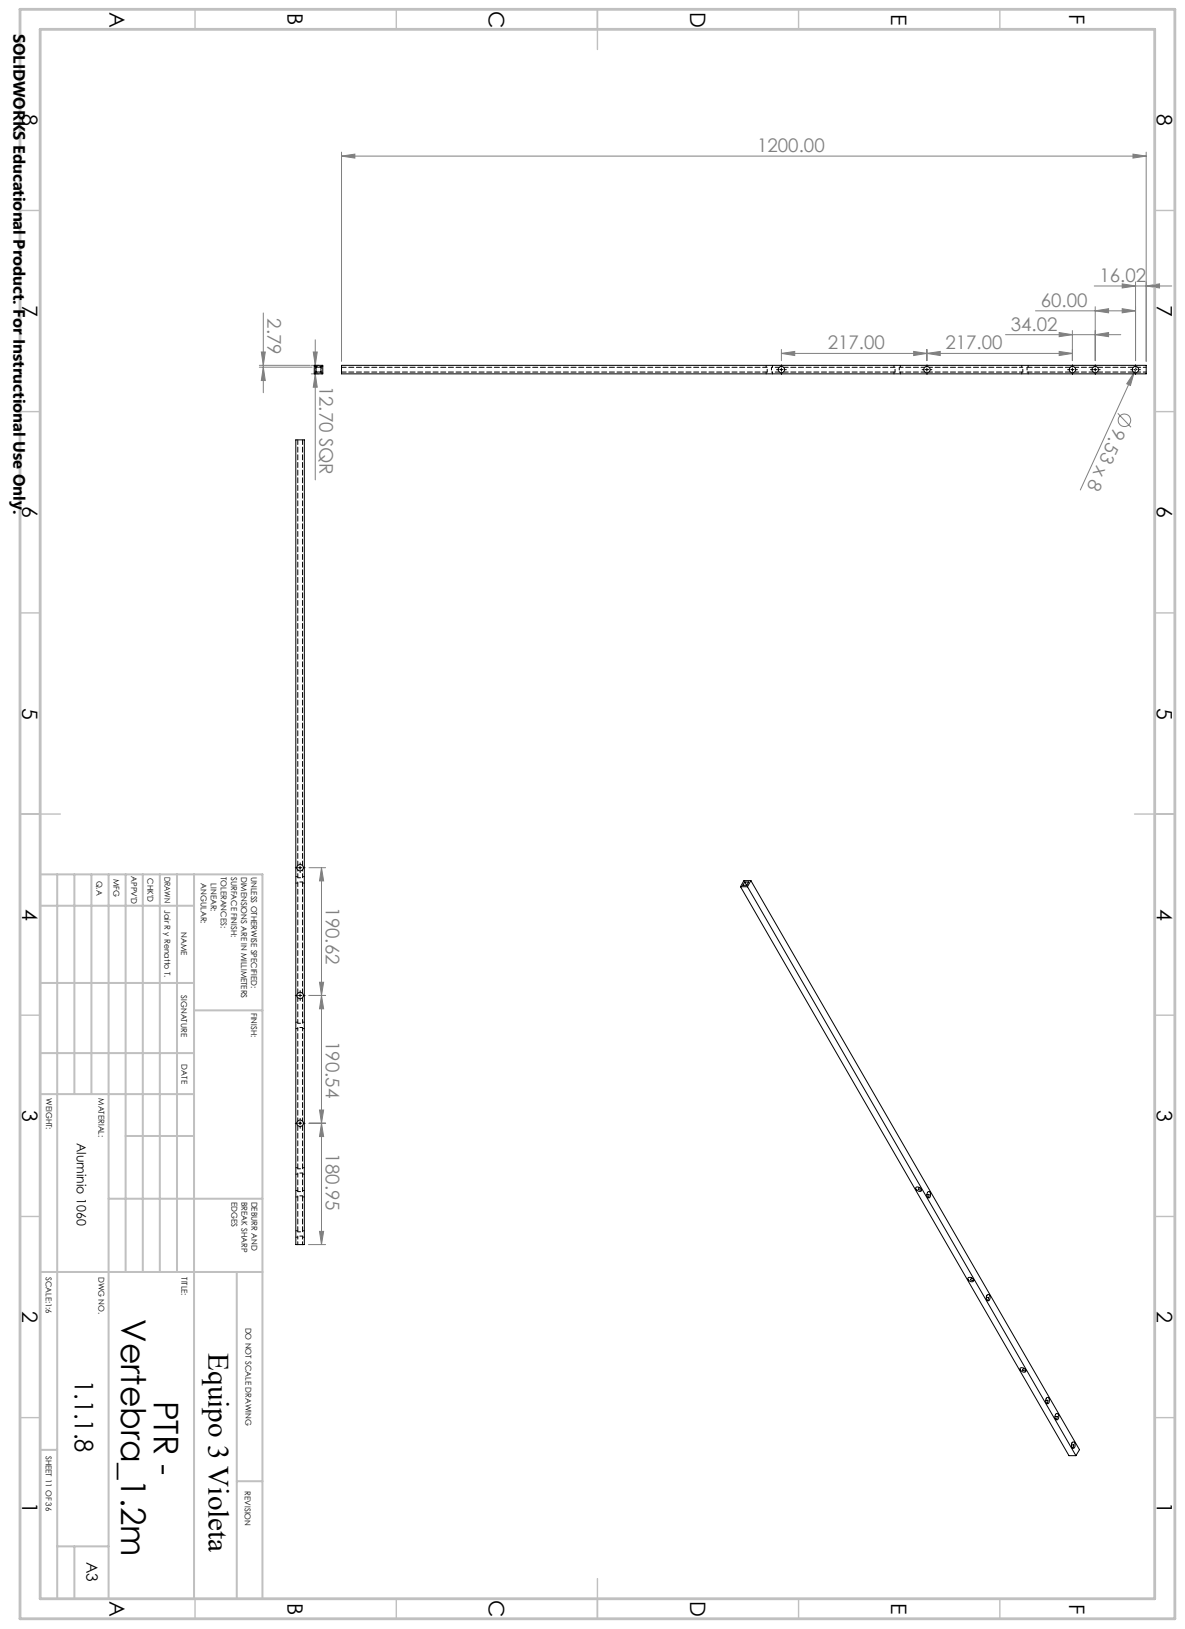
[picture p49: page 19]
12.70 SQR 190.62 190.54 180.95; MFG; APPV'D; CHK'D; DRAWN; ANGULAR:; LINEAR:; TOLERANCES:; SURFACE FINISH:; EDGES BREAK SHARP; DEBURR AND; MATERIAL:; SCALE:1:6; DWG NO.; TITLE:; SHEET 11 OF 36; A3 Aluminio 1060; WEIGHT:; Jair R y Renatto T.; Equipo 3 Violeta; PTR -; Vertebra_1.2m

SOLIDWORKS Educational Product. For Instructional Use Only.

DIMENSIONS ARE IN MILLIMETERS

UNLESS OTHERWISE SPECIFIED: FINISH:

NAME SIGNATURE DATE

DO NOT SCALE DRAWING REVISION

3.00

200.00

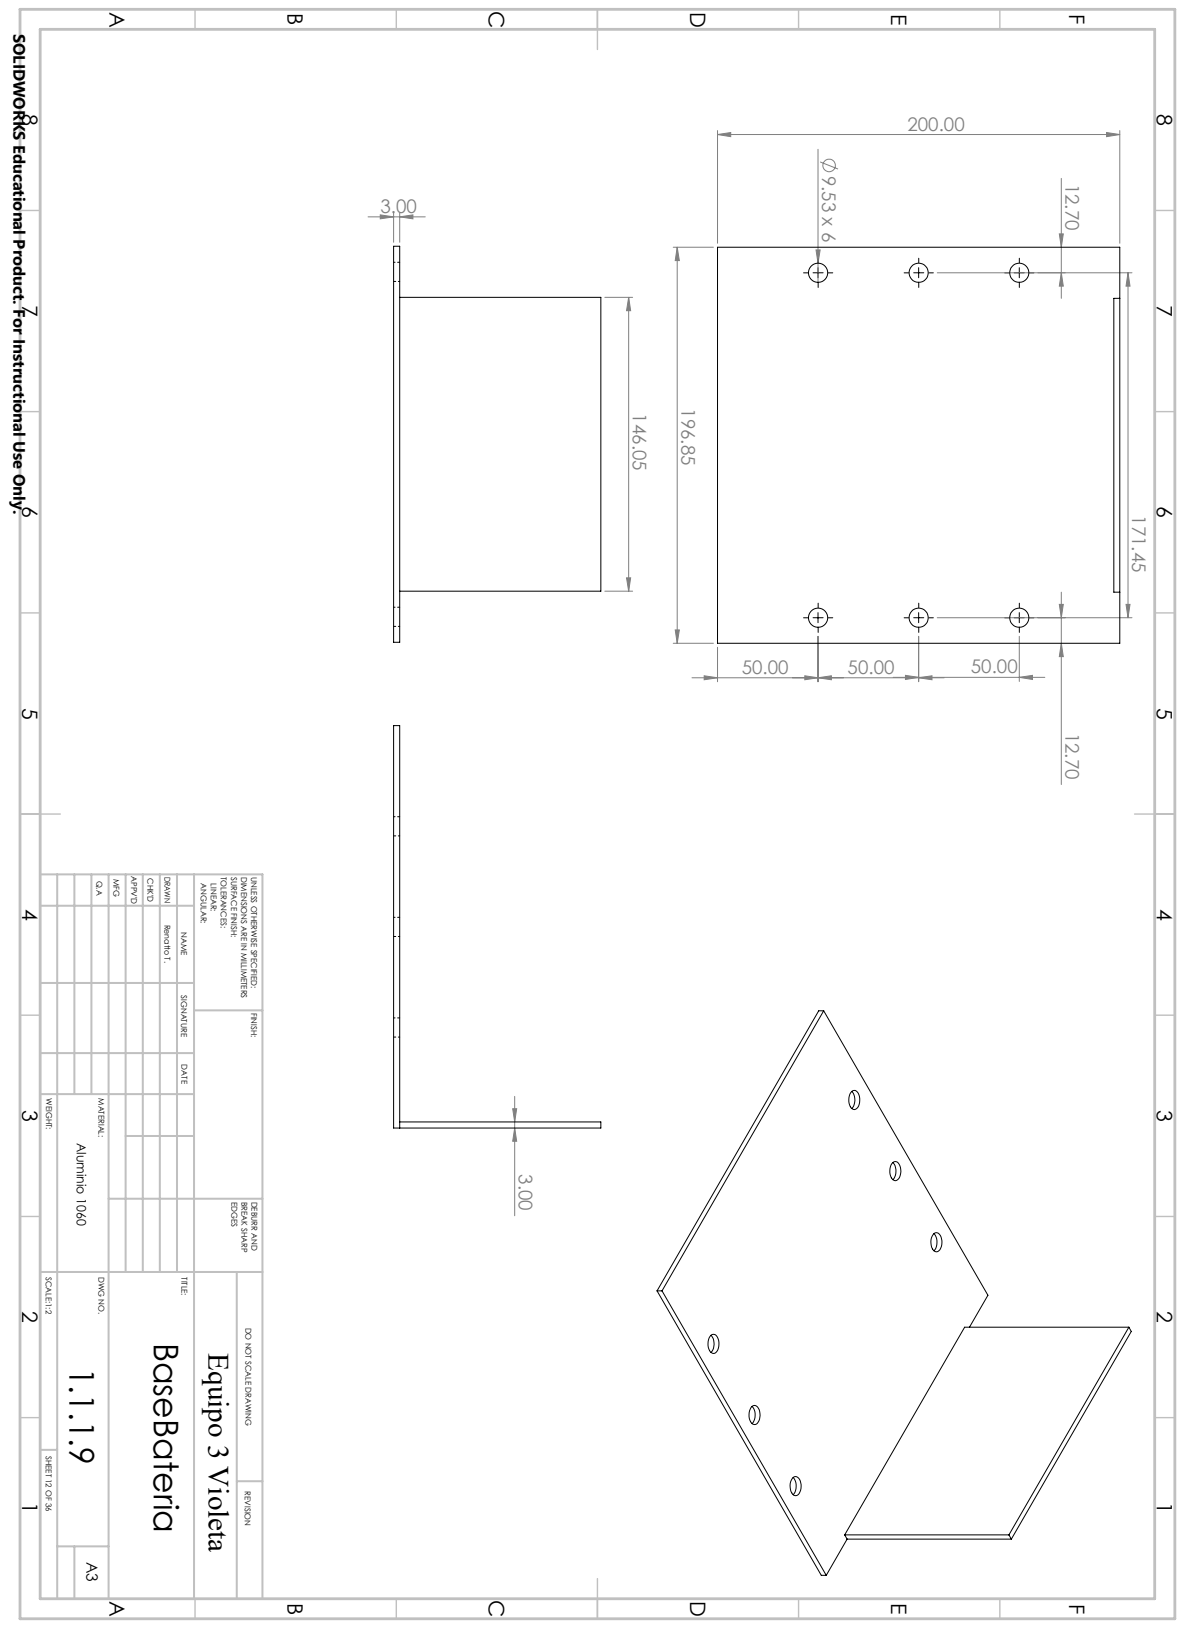
[picture p50: page 20]
MFG; APPV'D; CHK'D; DRAWN; ANGULAR:; LINEAR:; TOLERANCES:; SURFACE FINISH:; EDGES BREAK SHARP; DEBURR AND; MATERIAL:; SCALE:1:2; DWG NO.; TITLE:; SHEET 12 OF 36; A3 Aluminio 1060; WEIGHT:; Renatto T.; Equipo 3 Violeta; BaseBateria

SOLIDWORKS Educational Product. For Instructional Use Only.

DIMENSIONS ARE IN MILLIMETERS

UNLESS OTHERWISE SPECIFIED: FINISH:

NAME SIGNATURE DATE

DO NOT SCALE DRAWING REVISION

425.40

12.70 | 3.00

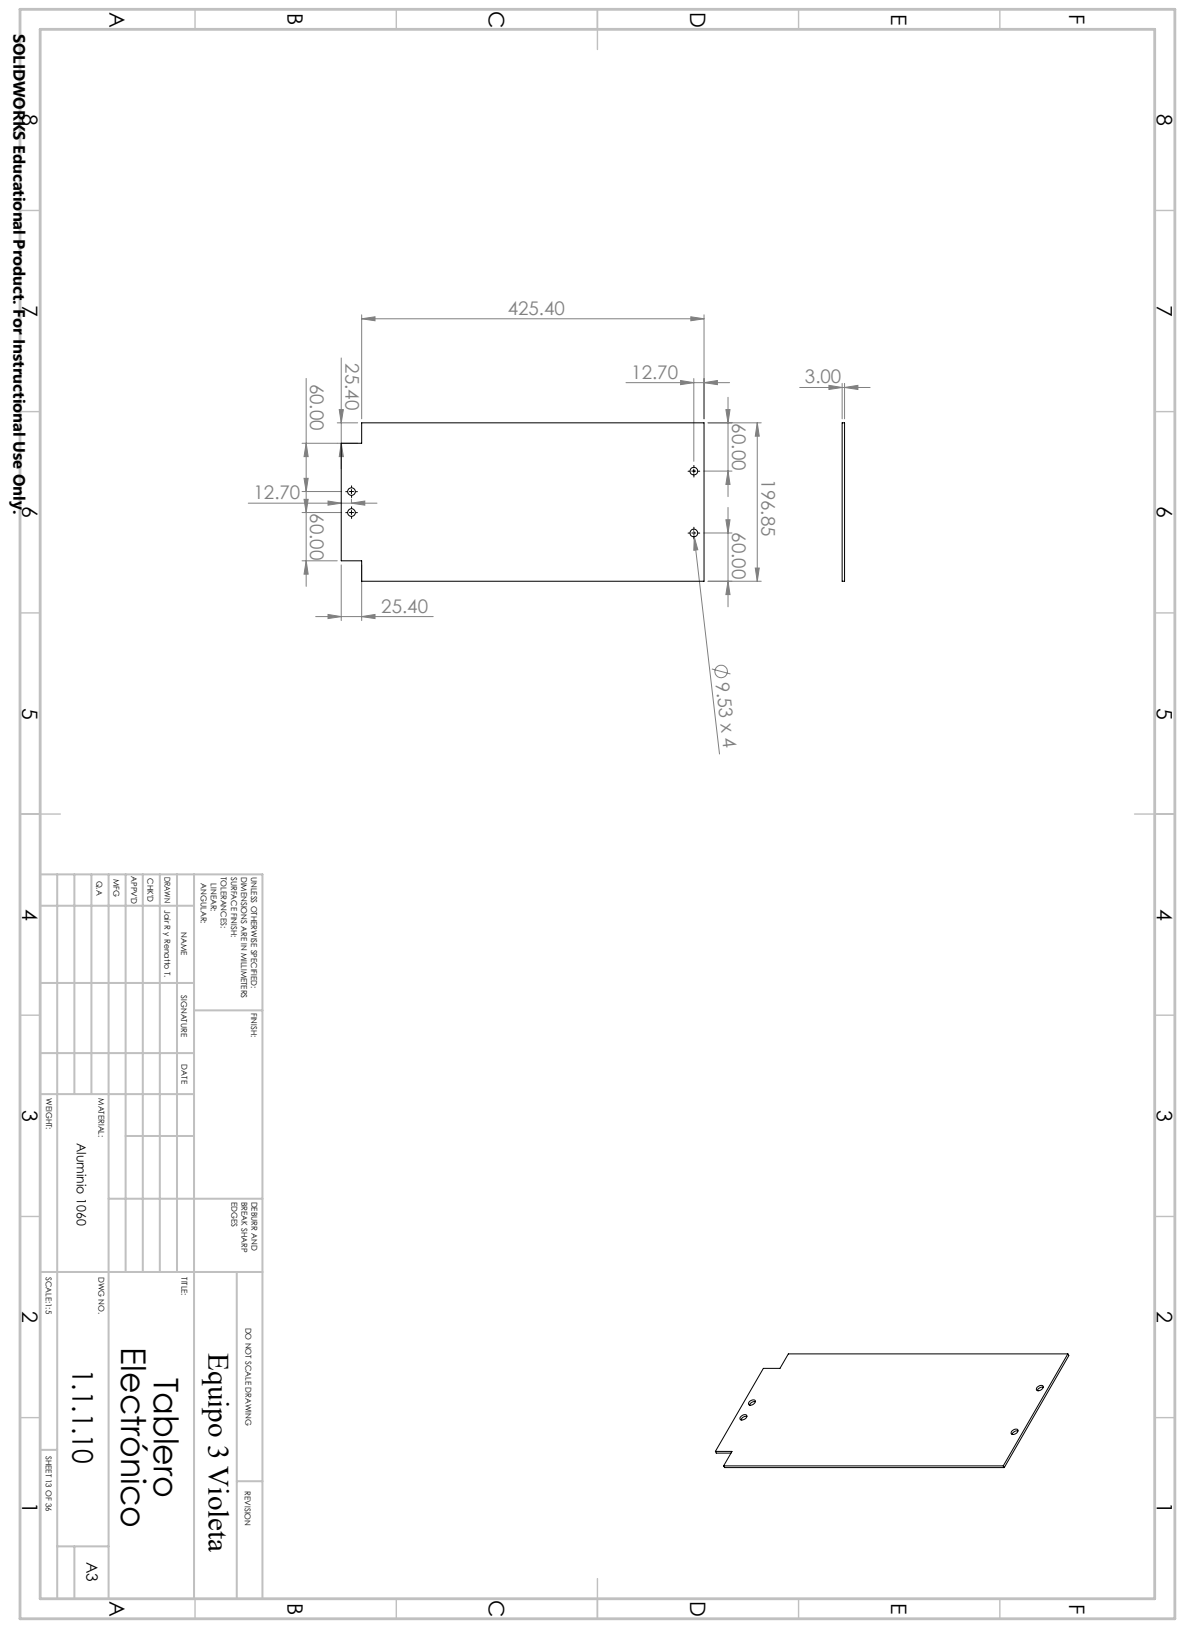
[picture p51: page 21]
MFG; APPV'D; CHK'D; DRAWN; ANGULAR:; LINEAR:; TOLERANCES:; SURFACE FINISH:; EDGES BREAK SHARP; DEBURR AND; MATERIAL:; SCALE:1:5; DWG NO.; TITLE:; SHEET 13 OF 36; A3 Aluminio 1060; WEIGHT:; Jair R y Renatto T.; Equipo 3 Violeta; Tablero; Electrónico

SOLIDWORKS Educational Product. For Instructional Use Only.

DIMENSIONS ARE IN MILLIMETERS

UNLESS OTHERWISE SPECIFIED: FINISH:

NAME SIGNATURE DATE

DO NOT SCALE DRAWING REVISION

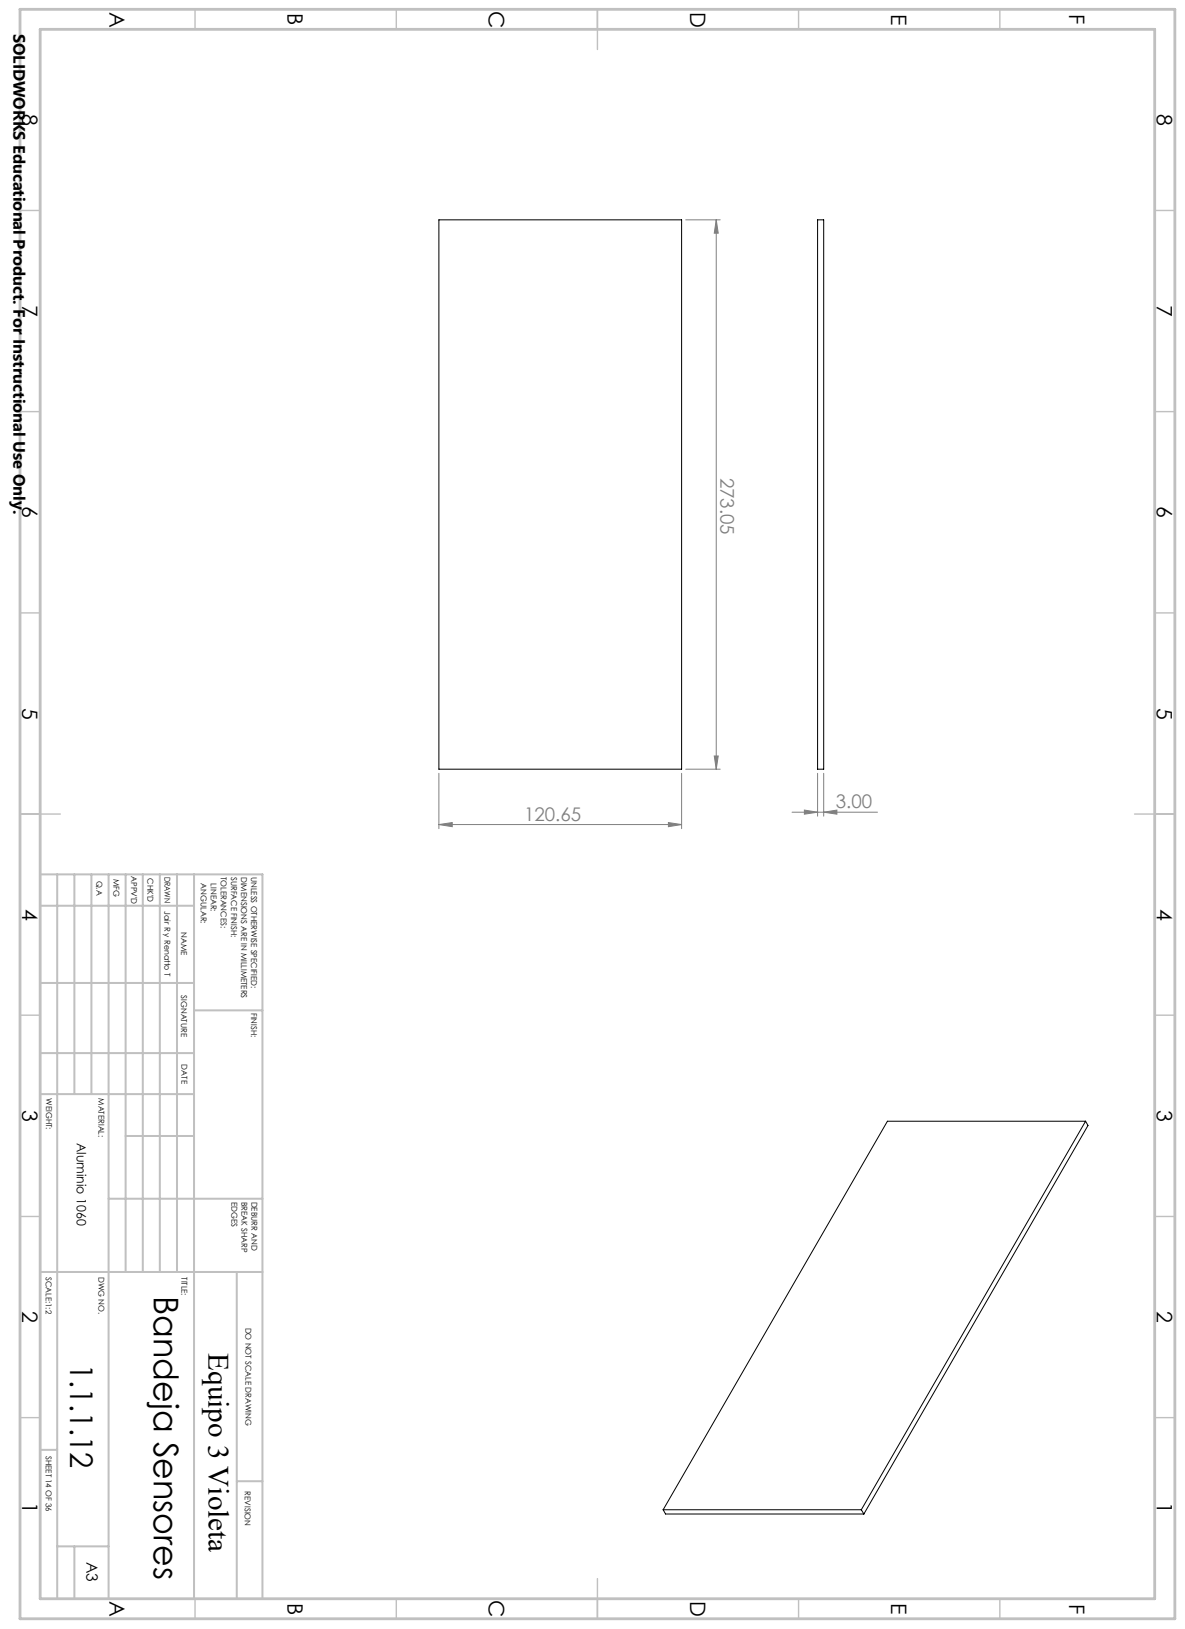
[picture p52: page 22]
MFG; APPV'D; CHK'D; DRAWN; ANGULAR:; LINEAR:; TOLERANCES:; SURFACE FINISH:; EDGES BREAK SHARP; DEBURR AND; MATERIAL:; SCALE:1:2; DWG NO.; TITLE:; SHEET 14 OF 36; A3 Aluminio 1060; WEIGHT:; Jair R y Renatto T; Equipo 3 Violeta; Bandeja Sensores

SOLIDWORKS Educational Product. For Instructional Use Only.

DIMENSIONS ARE IN MILLIMETERS

UNLESS OTHERWISE SPECIFIED: FINISH:

NAME SIGNATURE DATE

DO NOT SCALE DRAWING REVISION

43.00

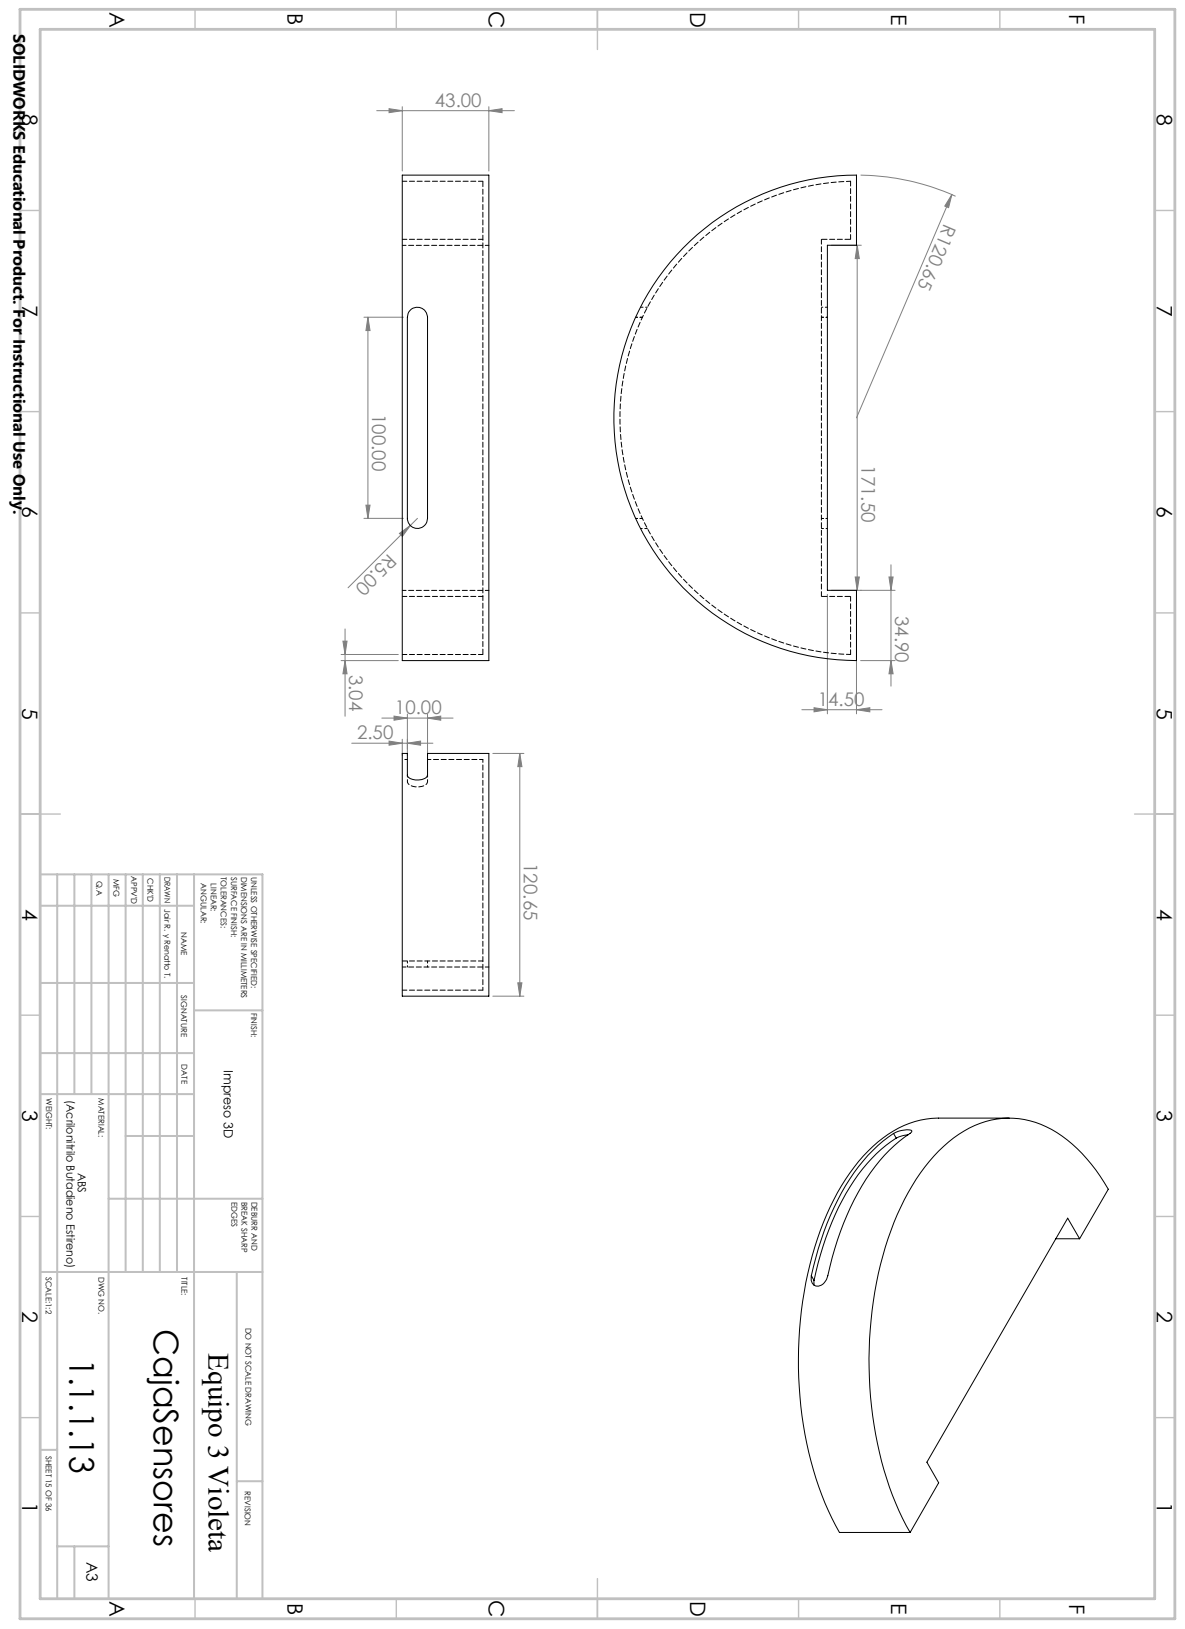
[picture p53: page 23]
MFG; APPV'D; CHK'D; DRAWN; ANGULAR:; LINEAR:; TOLERANCES:; SURFACE FINISH:; EDGES BREAK SHARP; DEBURR AND; MATERIAL:; SCALE:1:2; DWG NO.; TITLE:; SHEET 15 OF 36; A3 ABS; Impreso 3D; WEIGHT:; Jair R. y Renatto T.; Equipo 3 Violeta; CajaSensores

SOLIDWORKS Educational Product. For Instructional Use Only.

DIMENSIONS ARE IN MILLIMETERS

UNLESS OTHERWISE SPECIFIED: FINISH:

NAME SIGNATURE DATE

(Acrilonitrilo Butadieno Estireno)

DO NOT SCALE DRAWING REVISION

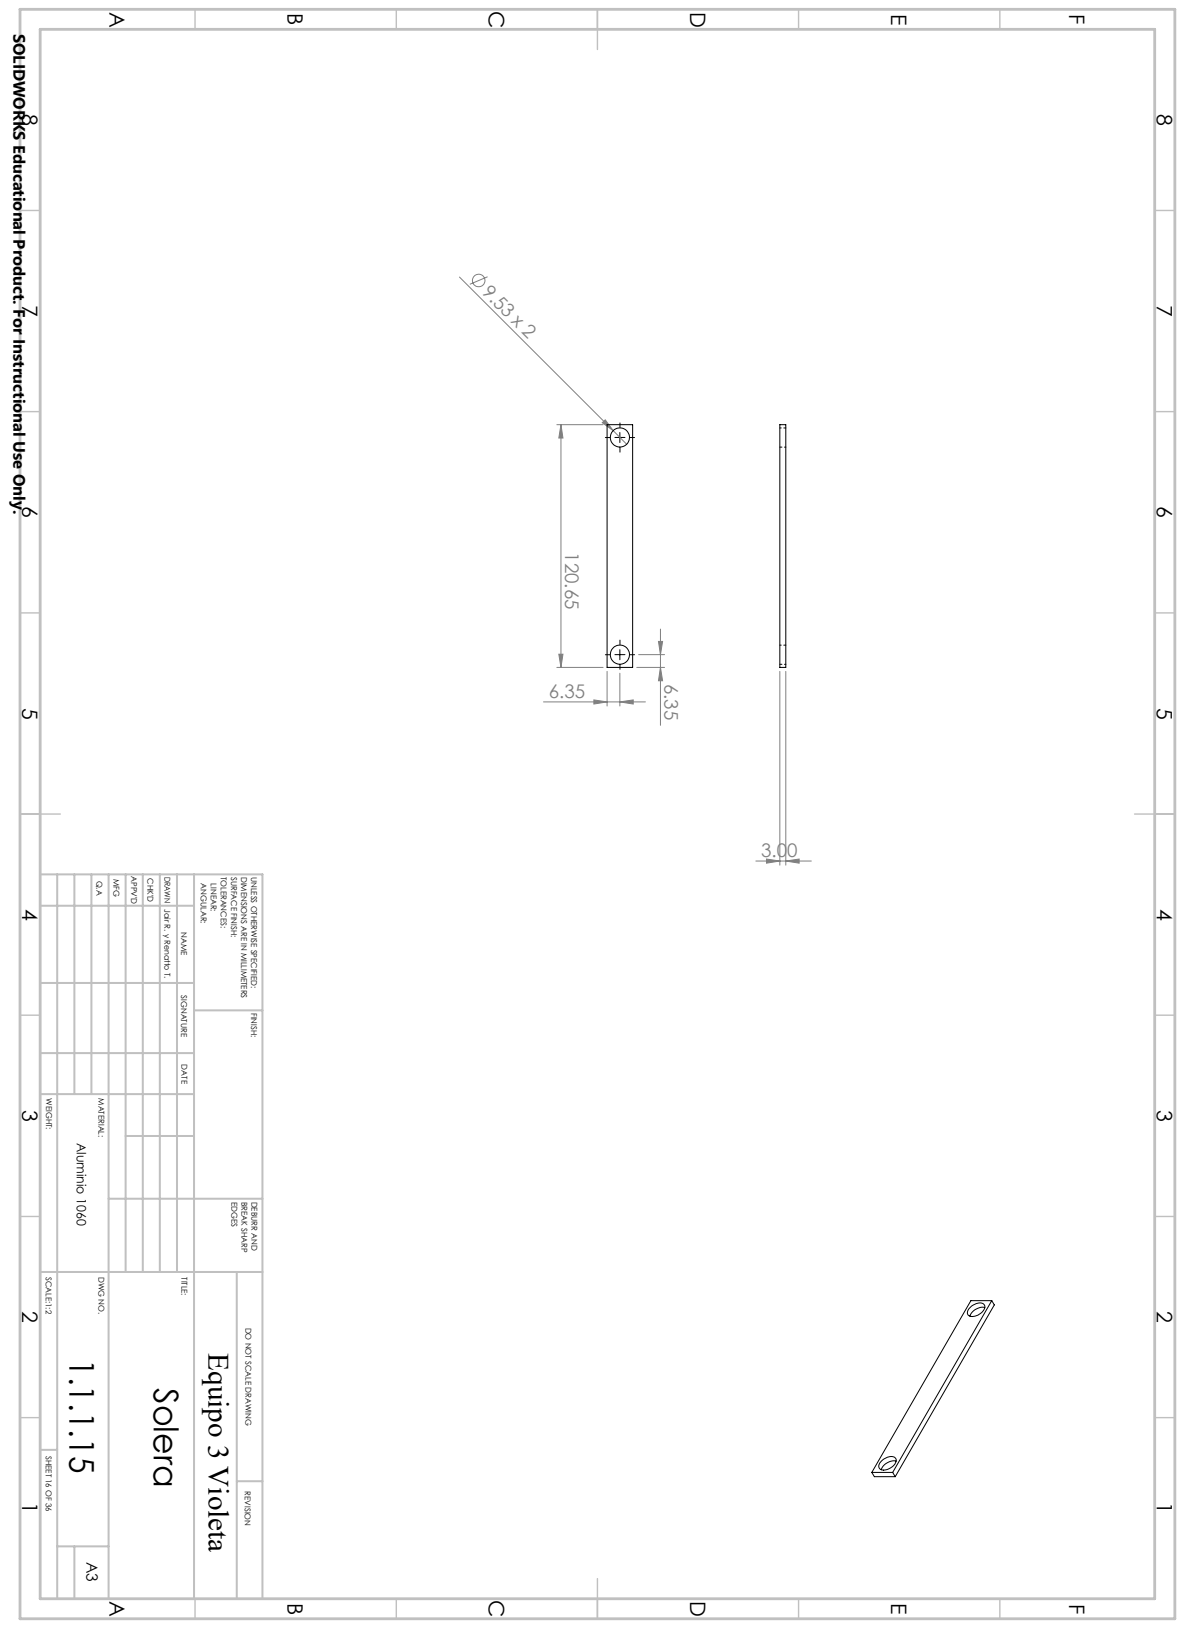
[picture p54: page 24]
MFG; APPV'D; CHK'D; DRAWN; ANGULAR:; LINEAR:; TOLERANCES:; SURFACE FINISH:; EDGES BREAK SHARP; DEBURR AND; MATERIAL:; SCALE:1:2; DWG NO.; TITLE:; SHEET 16 OF 36; A3 Aluminio 1060; WEIGHT:; Jair R. y Renatto T.; Equipo 3 Violeta; Solera

SOLIDWORKS Educational Product. For Instructional Use Only.

DIMENSIONS ARE IN MILLIMETERS

UNLESS OTHERWISE SPECIFIED: FINISH:

NAME SIGNATURE DATE

DO NOT SCALE DRAWING REVISION

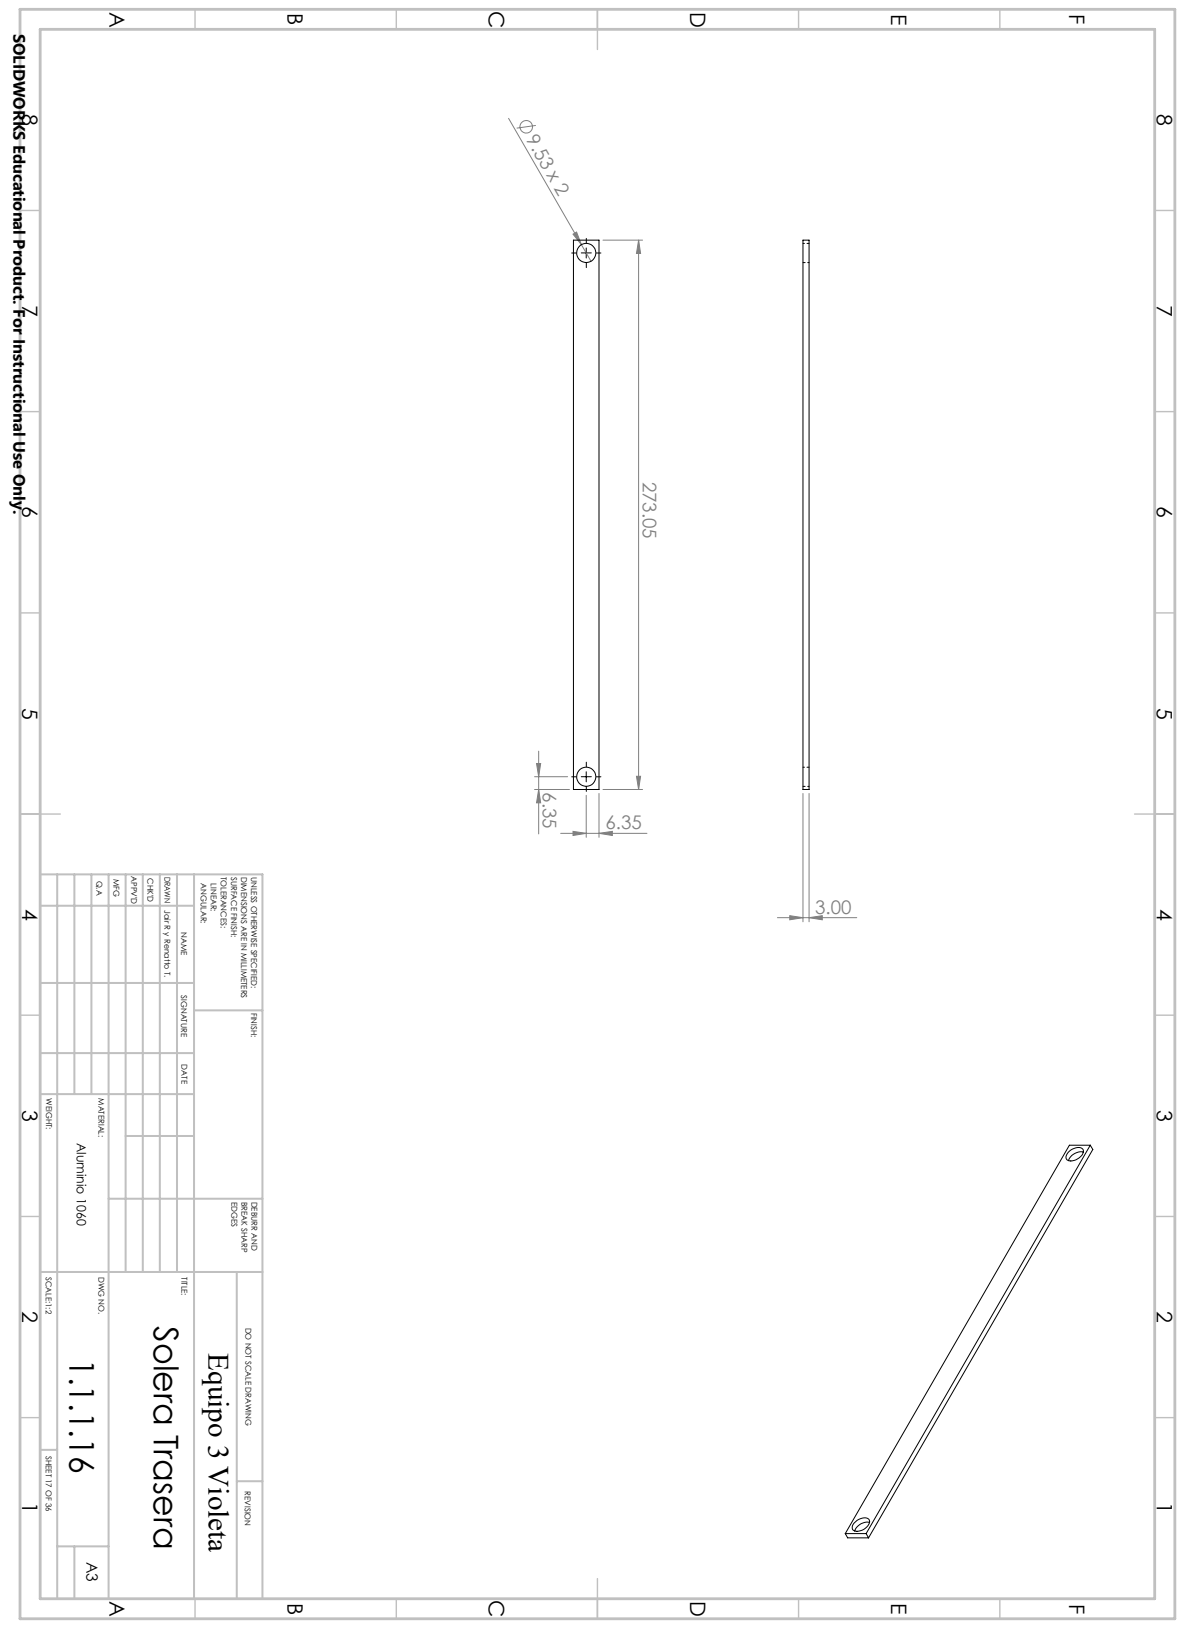
[picture p55: page 25]
MFG; APPV'D; CHK'D; DRAWN; ANGULAR:; LINEAR:; TOLERANCES:; SURFACE FINISH:; EDGES BREAK SHARP; DEBURR AND; MATERIAL:; SCALE:1:2; DWG NO.; TITLE:; SHEET 17 OF 36; A3 Aluminio 1060; WEIGHT:; Jair R y Renatto T.; Equipo 3 Violeta; Solera Trasera

SOLIDWORKS Educational Product. For Instructional Use Only.

DIMENSIONS ARE IN MILLIMETERS

UNLESS OTHERWISE SPECIFIED: FINISH:

NAME SIGNATURE DATE

DO NOT SCALE DRAWING REVISION

3.00
120.65

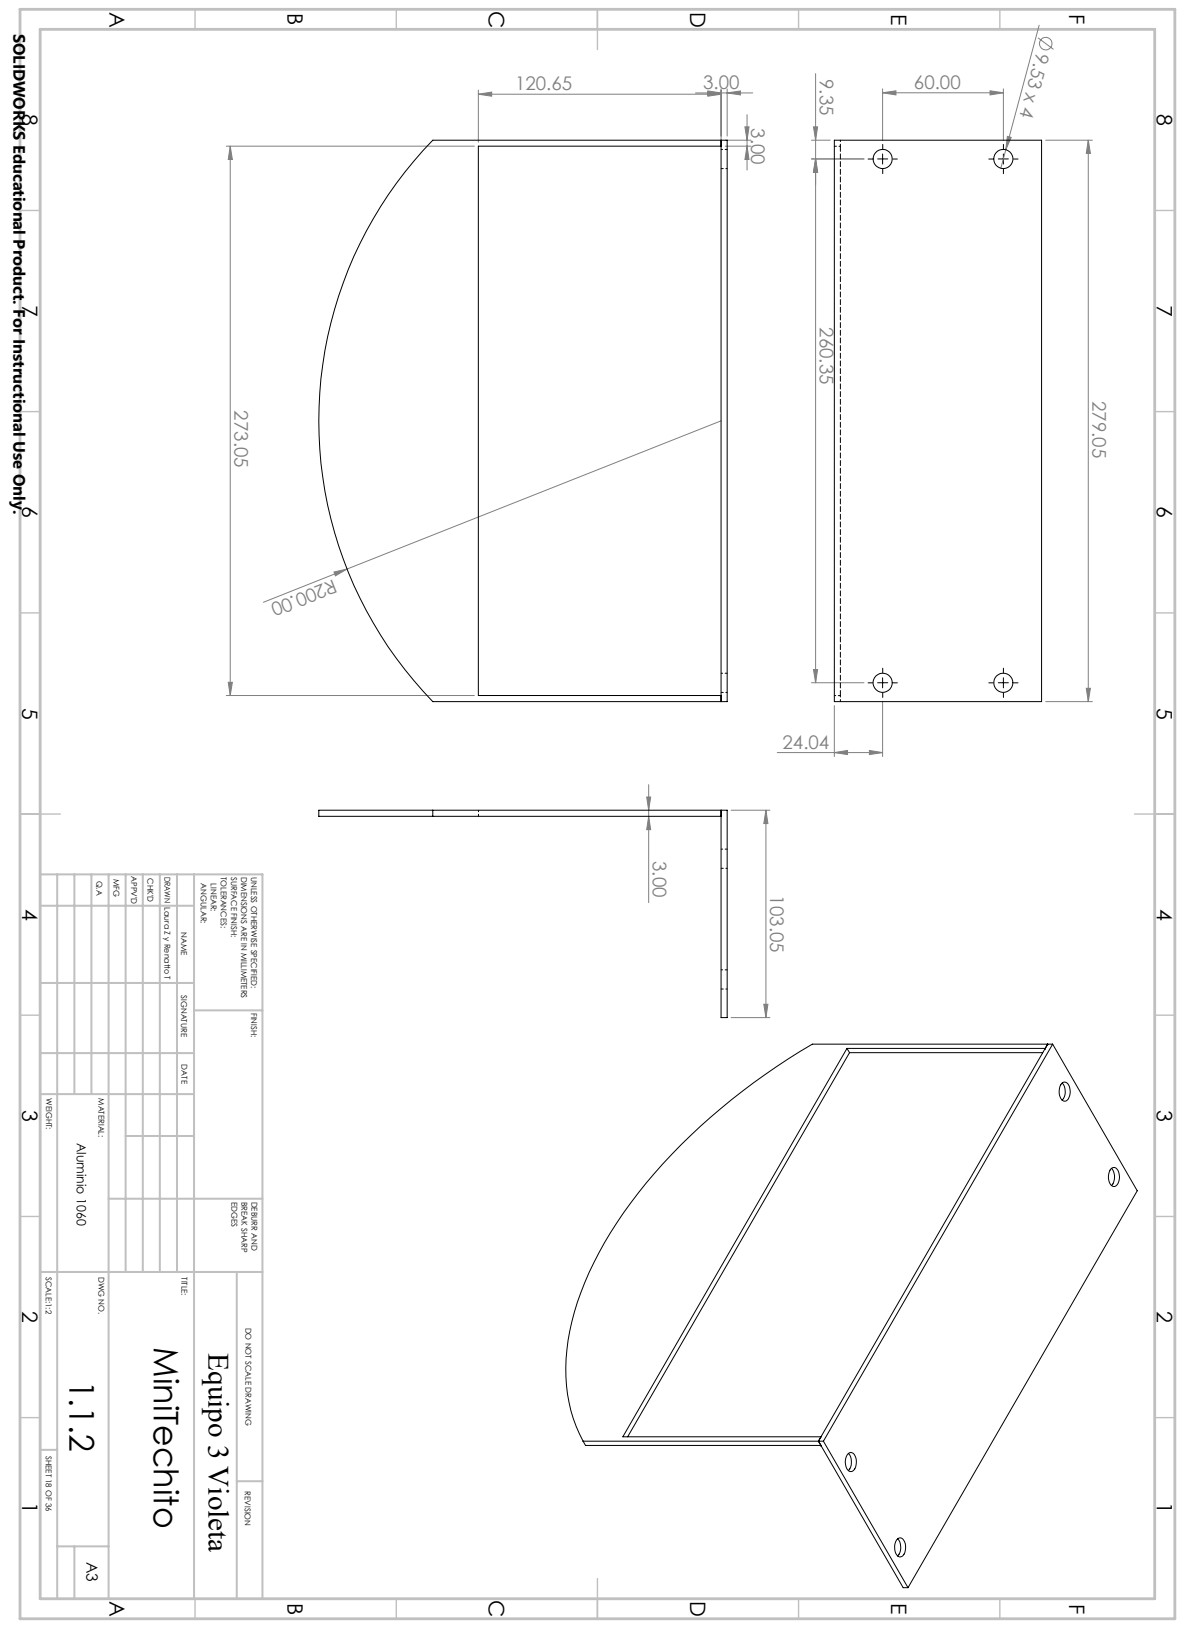
[picture p56: page 26]
MFG; APPV'D; CHK'D; DRAWN; ANGULAR:; LINEAR:; TOLERANCES:; SURFACE FINISH:; EDGES BREAK SHARP; DEBURR AND; MATERIAL:; SCALE:1:2; DWG NO.; TITLE:; SHEET 18 OF 36; A3 Aluminio 1060; WEIGHT:; Laura Z y Renatto T; Equipo 3 Violeta; MiniTechito

SOLIDWORKS Educational Product. For Instructional Use Only.

DIMENSIONS ARE IN MILLIMETERS

UNLESS OTHERWISE SPECIFIED: FINISH:

NAME SIGNATURE DATE

DO NOT SCALE DRAWING REVISION

20.00
97.05

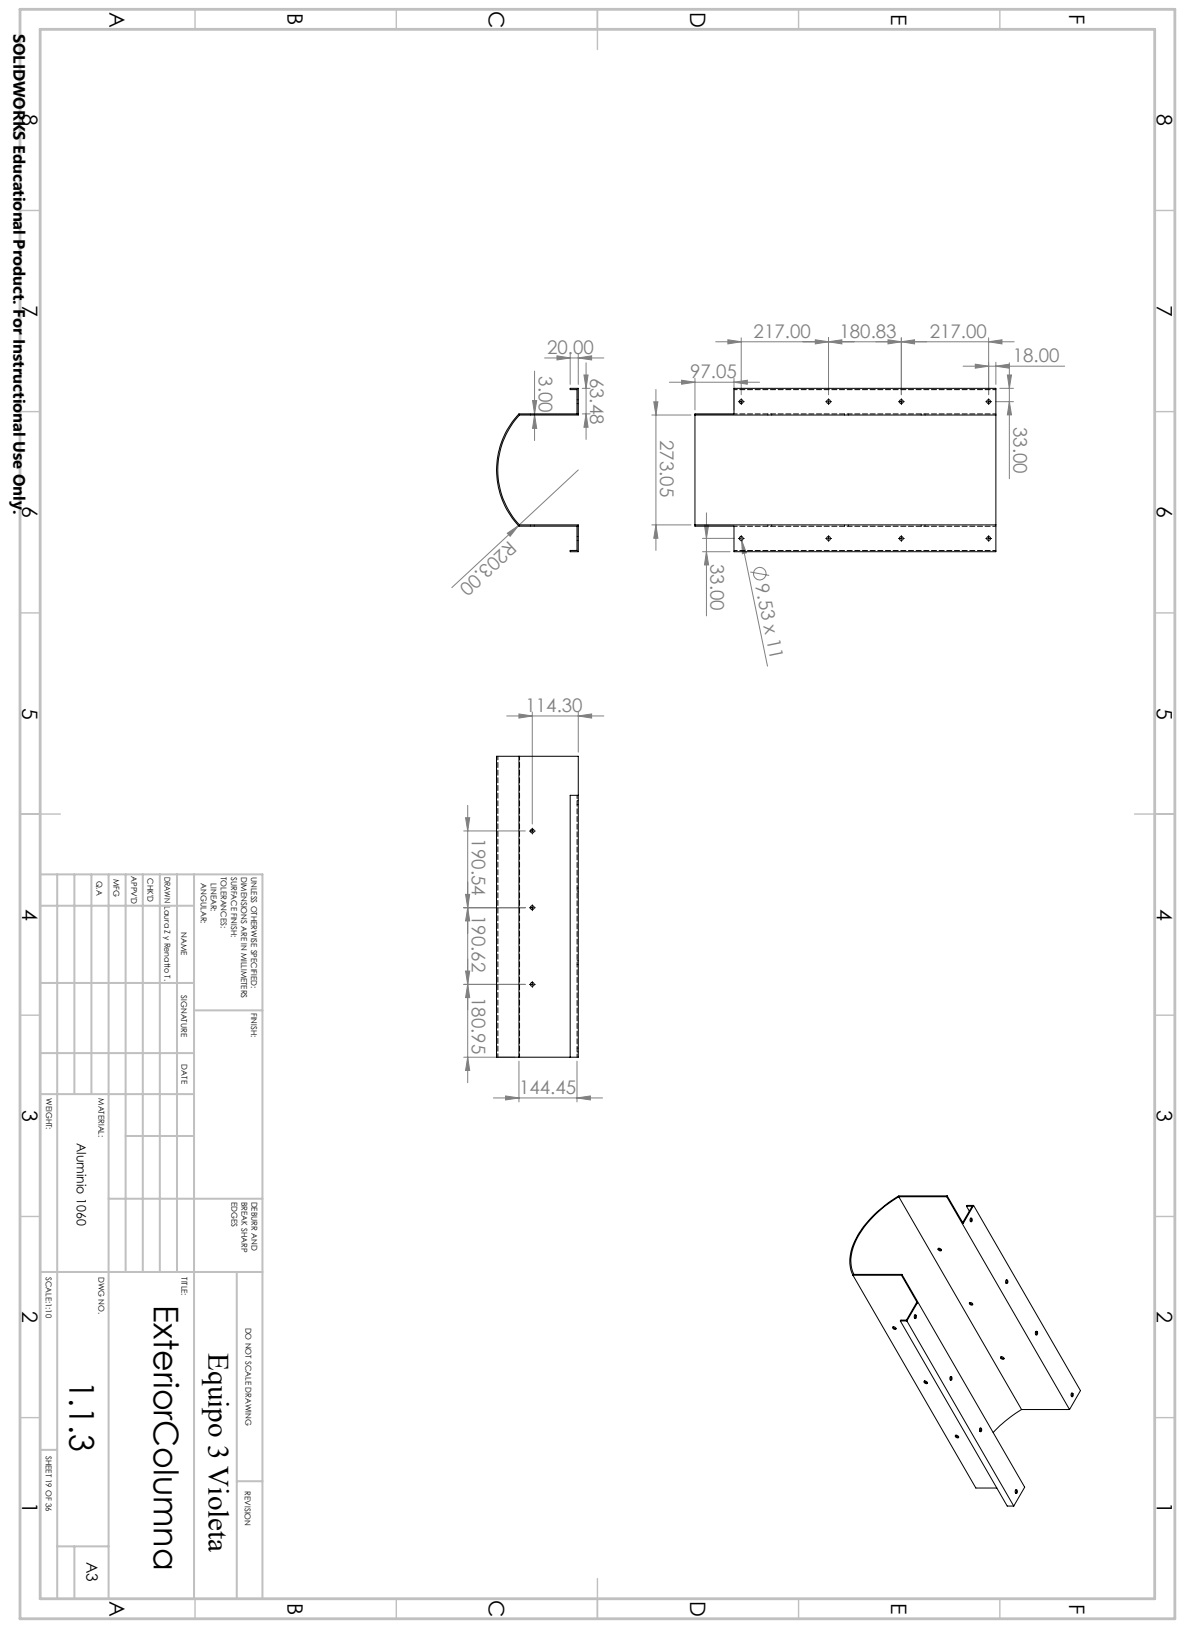
[picture p57: page 27]
MFG; APPV'D; CHK'D; DRAWN; ANGULAR:; LINEAR:; TOLERANCES:; SURFACE FINISH:; EDGES BREAK SHARP; DEBURR AND; MATERIAL:; SCALE:1:10; DWG NO.; TITLE:; SHEET 19 OF 36; A3 Aluminio 1060; WEIGHT:; Laura Z y Renatto T.; Equipo 3 Violeta; ExteriorColumna

SOLIDWORKS Educational Product. For Instructional Use Only.

DIMENSIONS ARE IN MILLIMETERS

UNLESS OTHERWISE SPECIFIED: FINISH:

NAME SIGNATURE DATE

DO NOT SCALE DRAWING REVISION

151.15 | 100.00
15.88 | 15.88

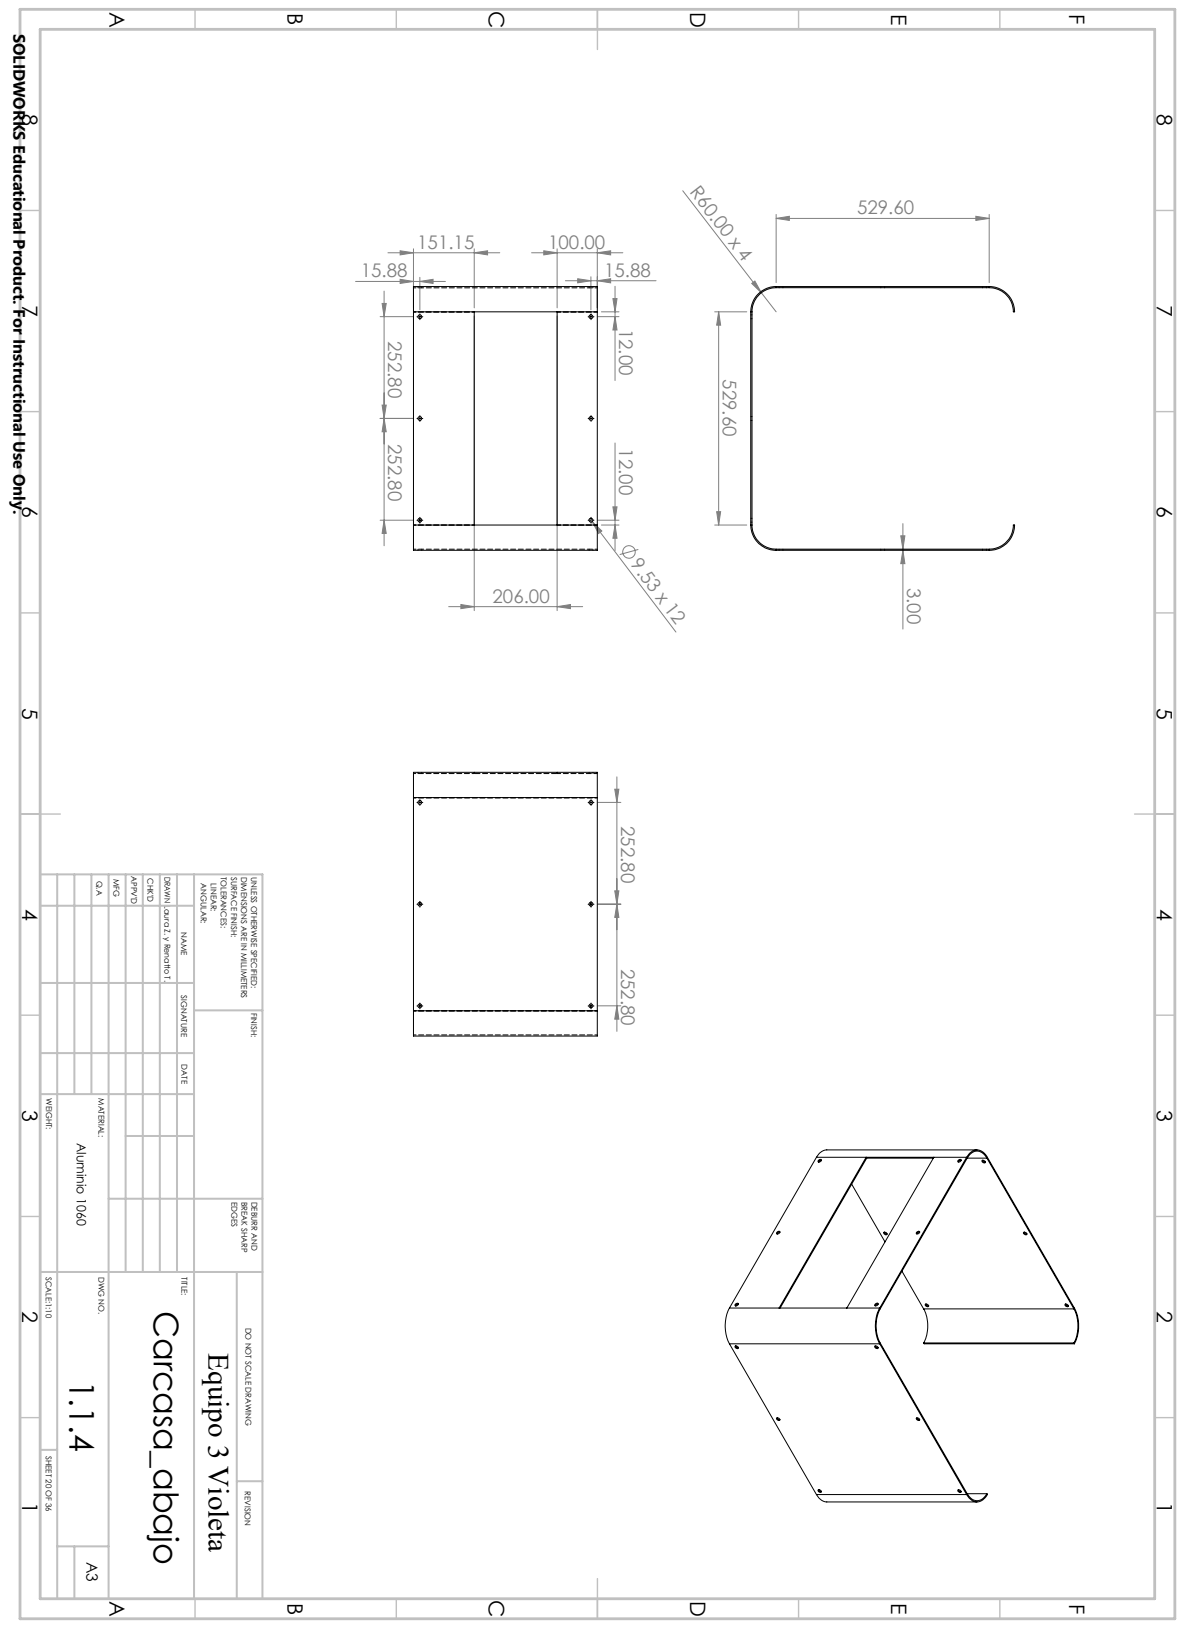
[picture p58: page 28]
MFG; APPV'D; CHK'D; DRAWN; ANGULAR:; LINEAR:; TOLERANCES:; SURFACE FINISH:; EDGES BREAK SHARP; DEBURR AND; MATERIAL:; SCALE:1:10; DWG NO.; TITLE:; SHEET 20 OF 36; A3 Aluminio 1060; WEIGHT:; Laura Z. y Renatto T.; Equipo 3 Violeta; Carcasa_abajo

SOLIDWORKS Educational Product. For Instructional Use Only.

DIMENSIONS ARE IN MILLIMETERS

UNLESS OTHERWISE SPECIFIED: FINISH:

NAME SIGNATURE DATE

DO NOT SCALE DRAWING REVISION

131.46
38.88

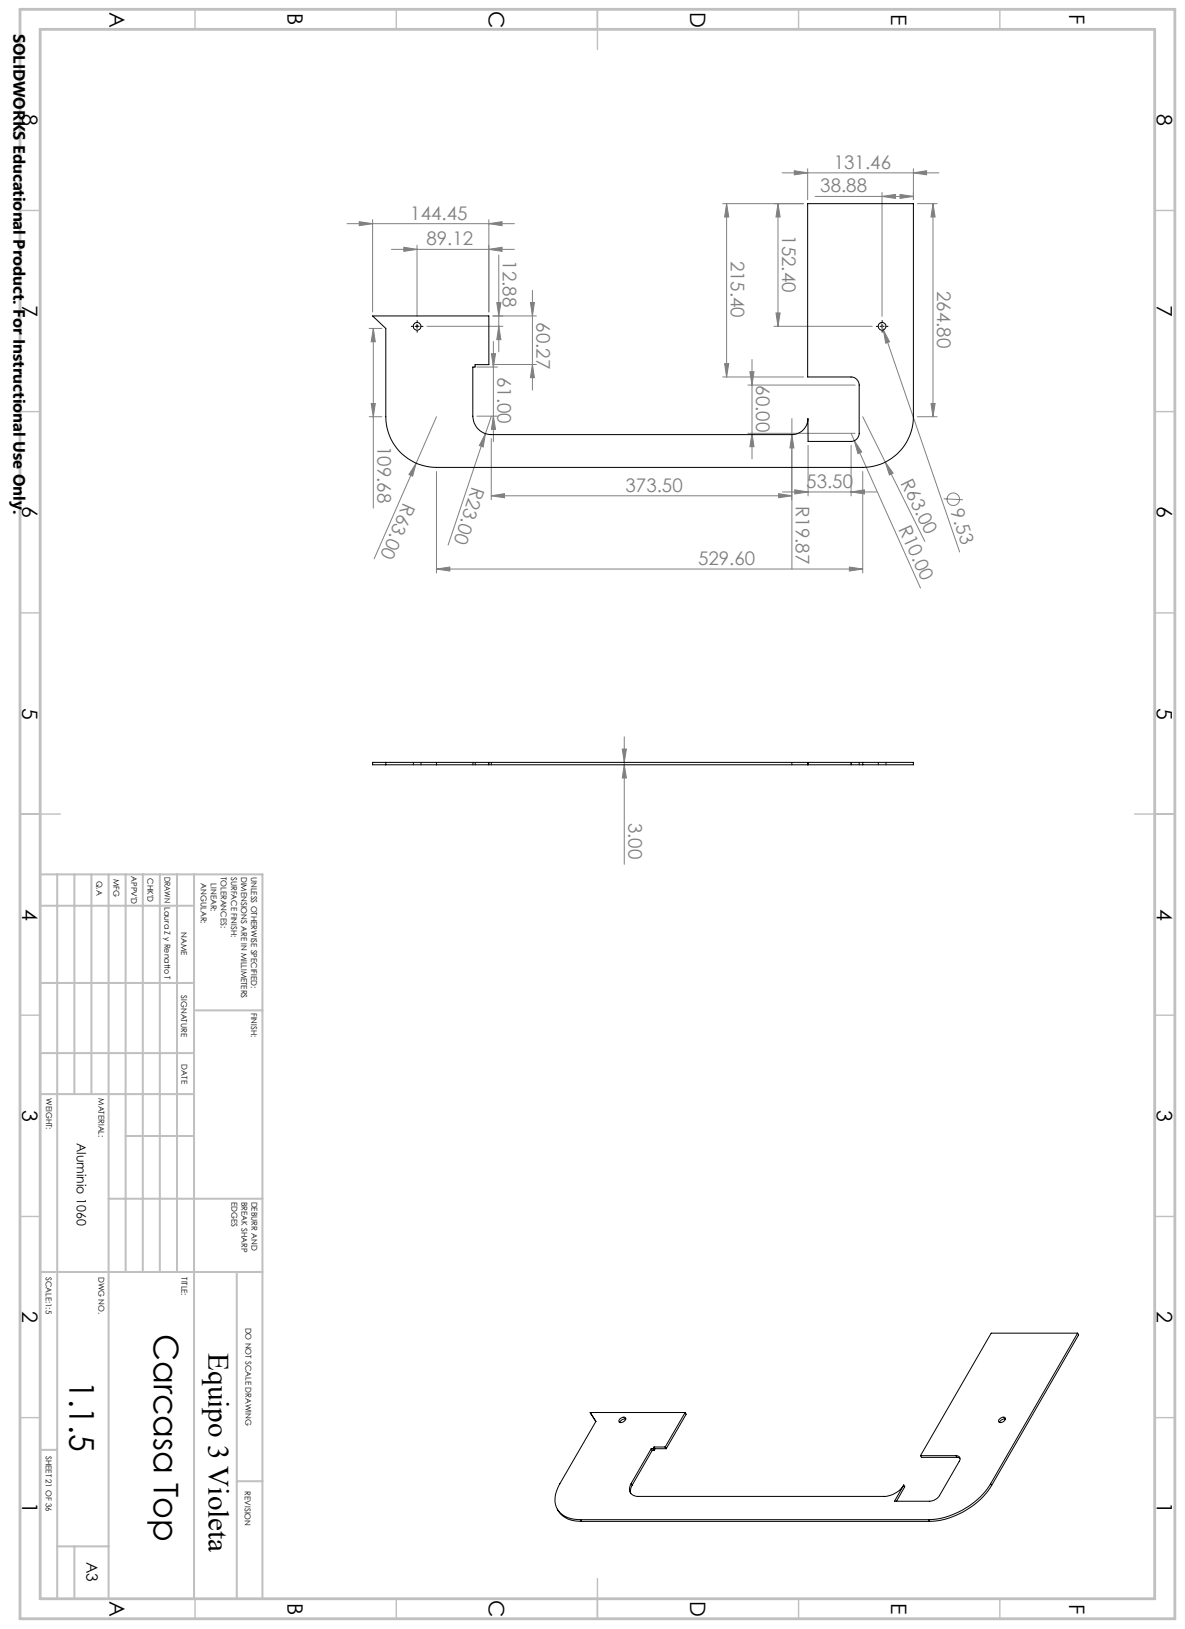
[picture p59: page 29]
MFG; APPV'D; CHK'D; DRAWN; ANGULAR:; LINEAR:; TOLERANCES:; SURFACE FINISH:; EDGES BREAK SHARP; DEBURR AND; MATERIAL:; SCALE:1:5; DWG NO.; TITLE:; SHEET 21 OF 36; A3 Aluminio 1060; WEIGHT:; Laura Z y Renatto T; Equipo 3 Violeta; Carcasa Top

SOLIDWORKS Educational Product. For Instructional Use Only.

DIMENSIONS ARE IN MILLIMETERS

UNLESS OTHERWISE SPECIFIED: FINISH:

NAME SIGNATURE DATE

DO NOT SCALE DRAWING REVISION

457.15

15.88

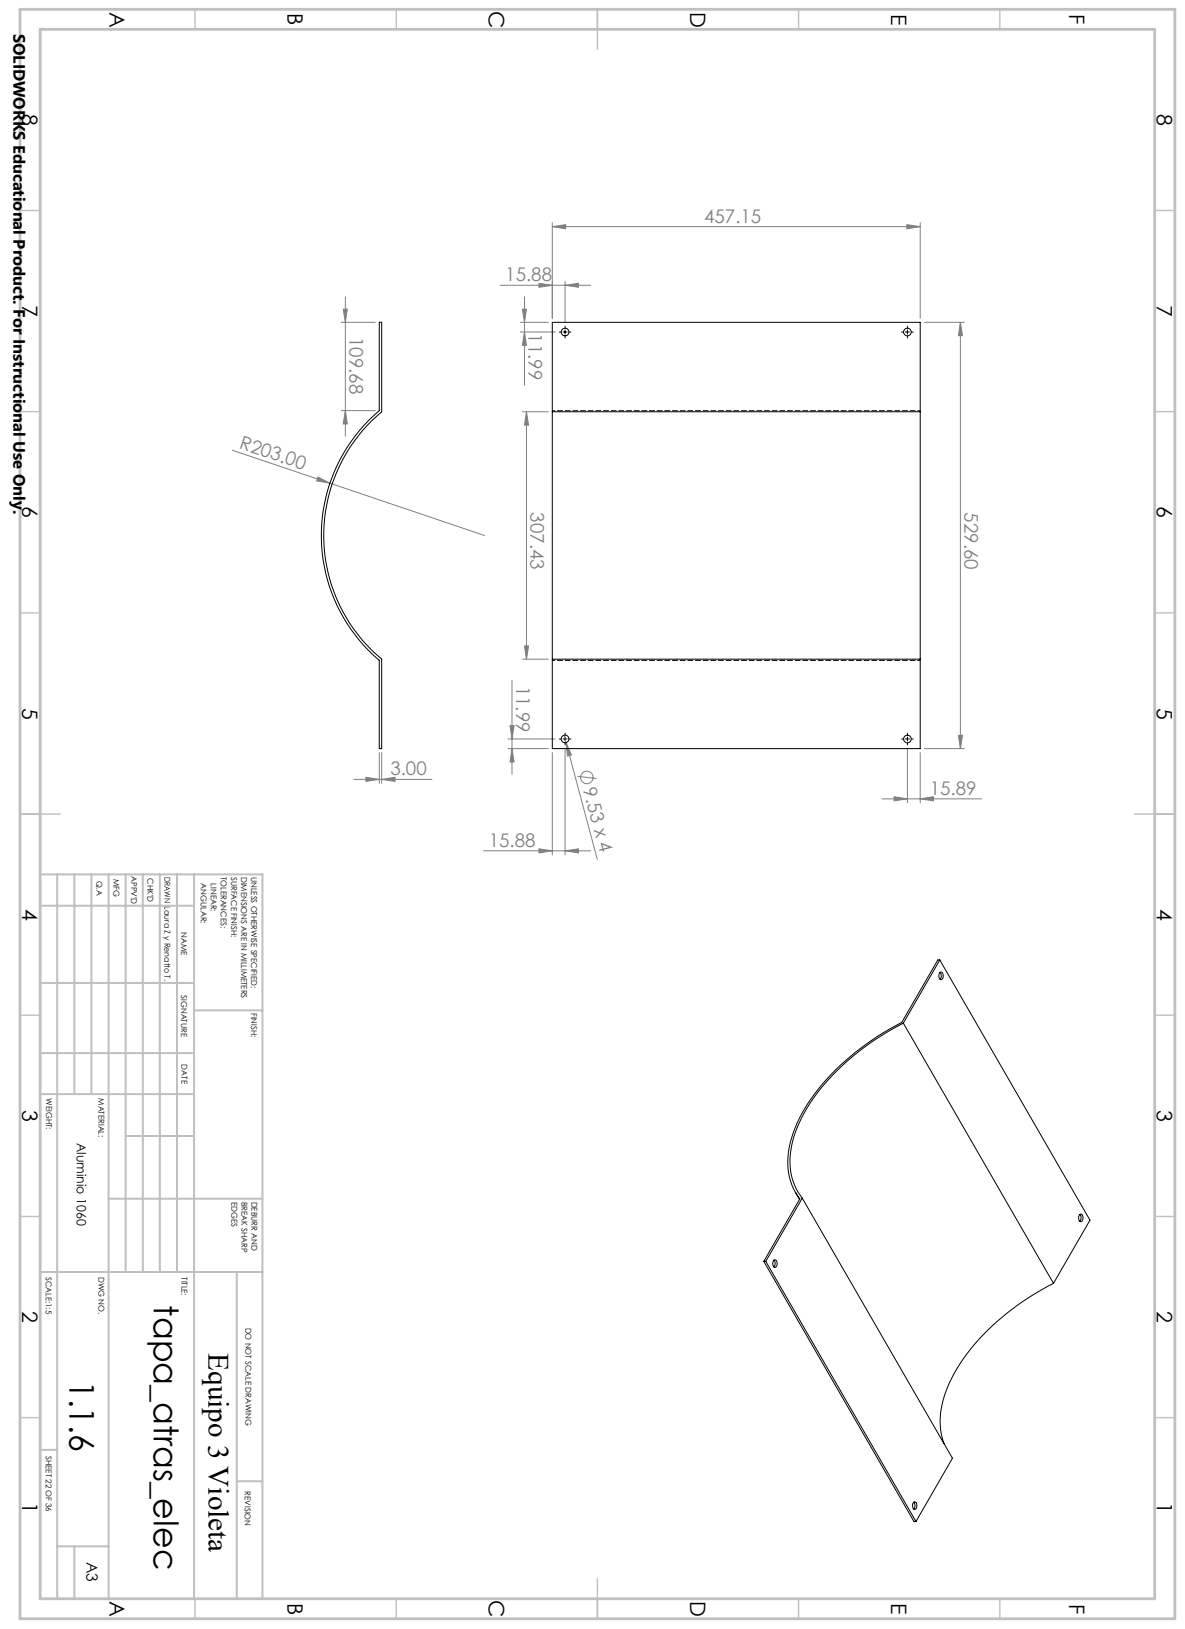
[picture p60: page 30]
MFG; APPV'D; CHK'D; DRAWN; ANGULAR:; LINEAR:; TOLERANCES:; SURFACE FINISH:; EDGES BREAK SHARP; DEBURR AND; MATERIAL:; SCALE:1:5; DWG NO.; TITLE:; SHEET 22 OF 36; A3 Aluminio 1060; WEIGHT:; Laura Z y Renatto T.; Equipo 3 Violeta; tapa_atras_elec

SOLIDWORKS Educational Product. For Instructional Use Only.

DIMENSIONS ARE IN MILLIMETERS

UNLESS OTHERWISE SPECIFIED: FINISH:

NAME SIGNATURE DATE

DO NOT SCALE DRAWING REVISION

206.00

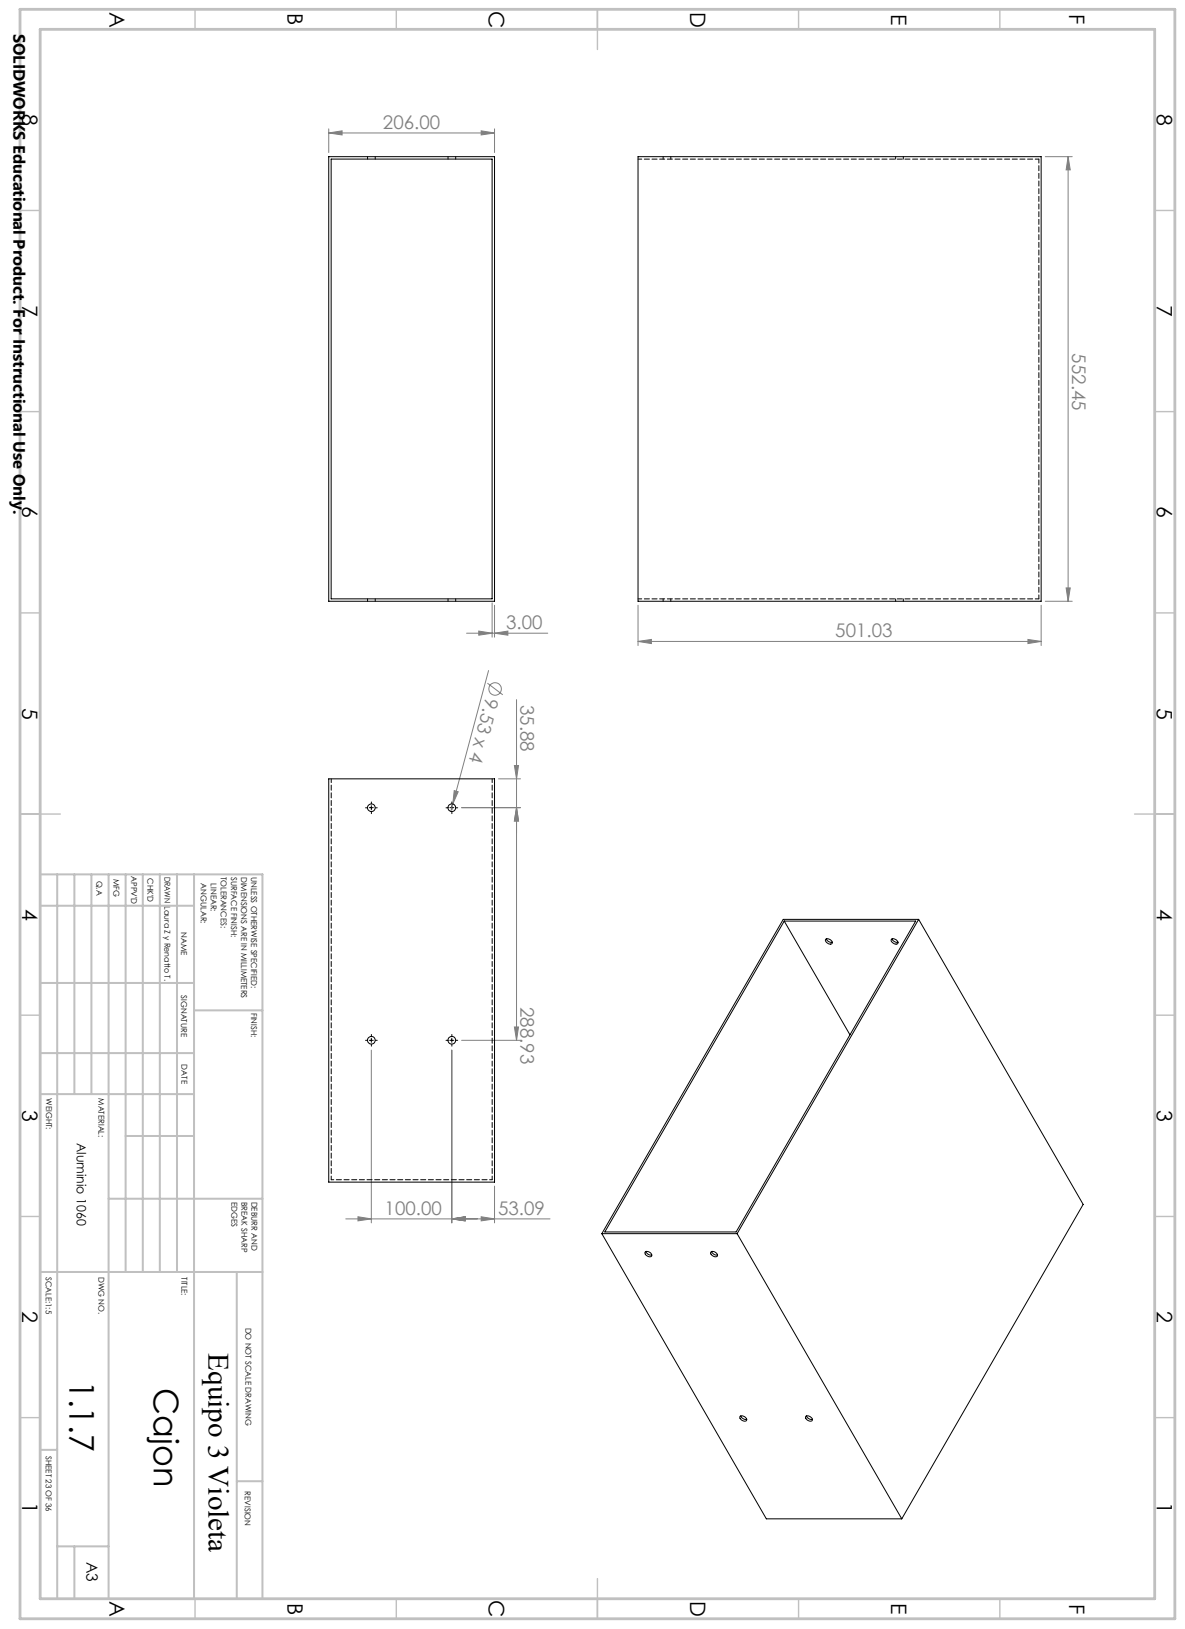
[picture p61: page 31]
MFG; APPV'D; CHK'D; DRAWN; ANGULAR:; LINEAR:; TOLERANCES:; SURFACE FINISH:; EDGES BREAK SHARP; DEBURR AND; MATERIAL:; SCALE:1:5; DWG NO.; TITLE:; SHEET 23 OF 36; A3 Aluminio 1060; WEIGHT:; Laura Z y Renatto T.; Equipo 3 Violeta; Cajon

SOLIDWORKS Educational Product. For Instructional Use Only.

DIMENSIONS ARE IN MILLIMETERS

UNLESS OTHERWISE SPECIFIED: FINISH:

NAME SIGNATURE DATE

DO NOT SCALE DRAWING REVISION

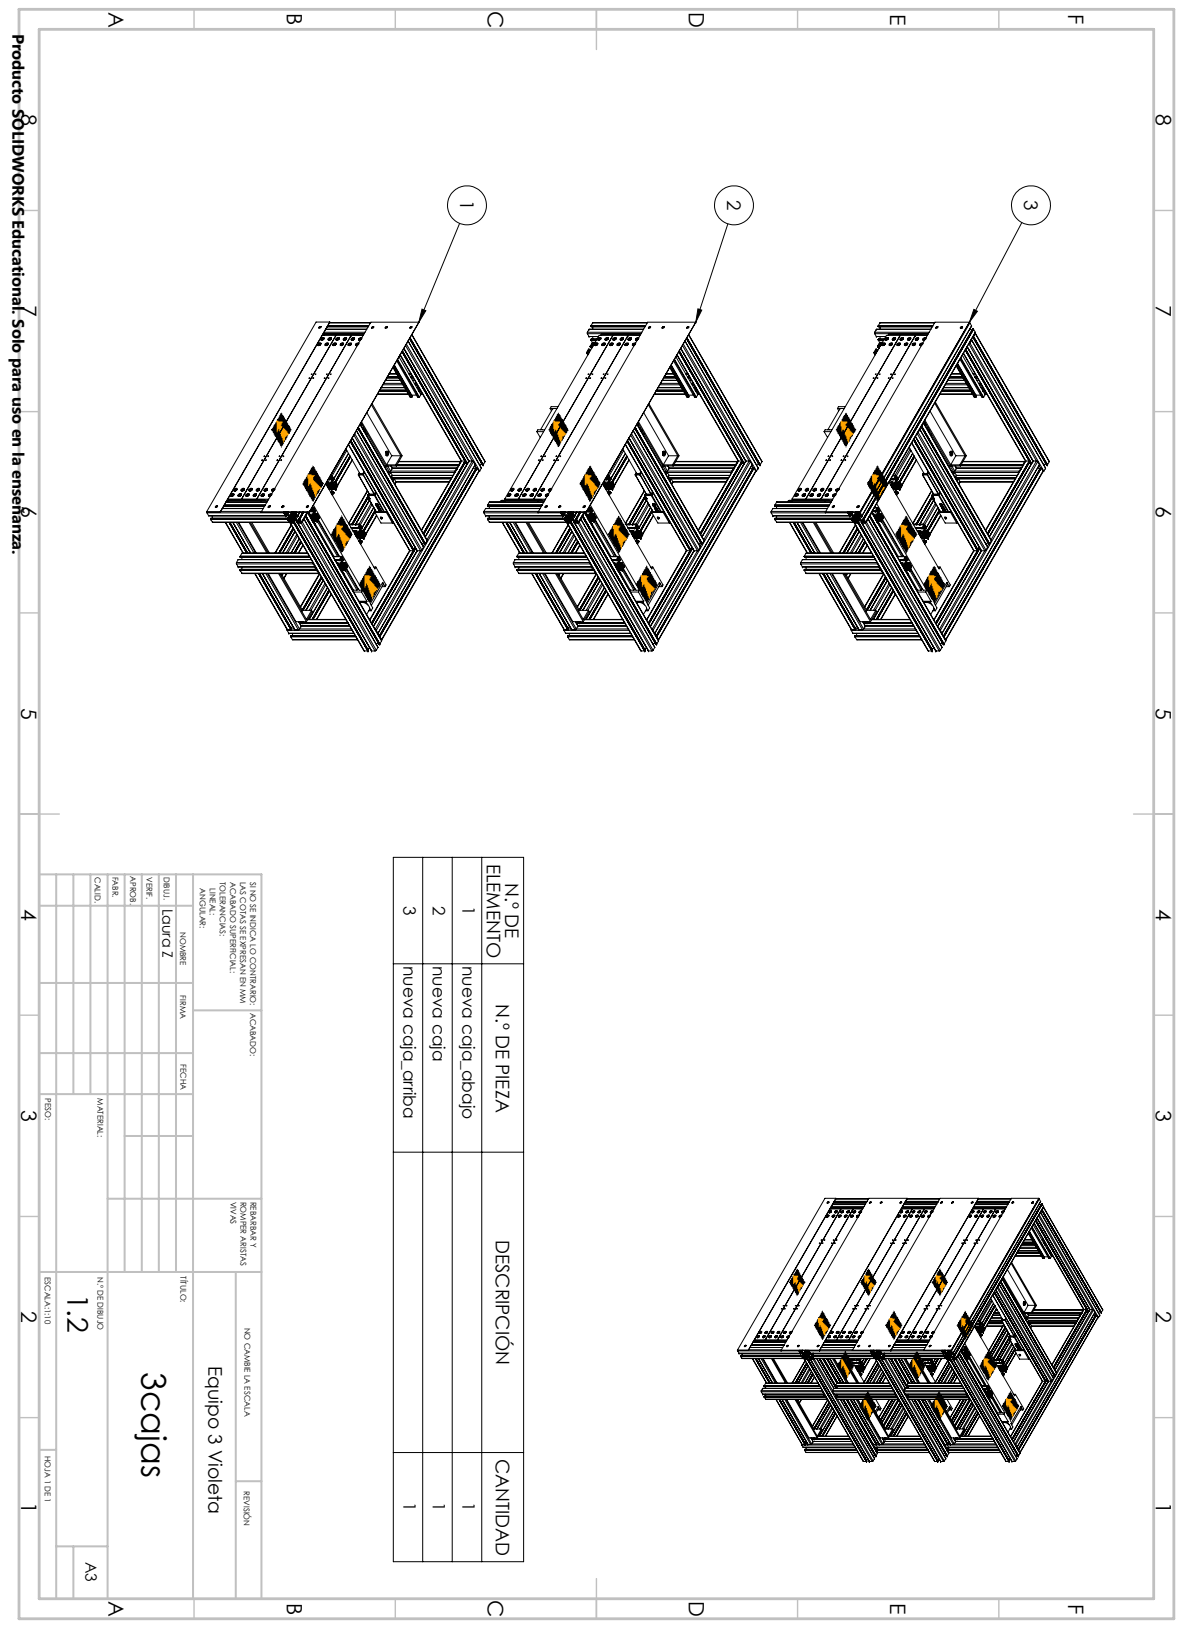
[picture p62: page 32]
Equipo 3 Violeta; Laura Z; 1 nueva caja_abajo 1; 2 nueva caja 1; 3 nueva caja_arriba 1; CALID.; FABR.; APROB.; VERIF.; DIBUJ.; ANGULAR:; LINEAL:; TOLERANCIAS:; ACABADO SUPERFICIAL:; VIVAS; ROMPER ARISTAS; REBARBAR Y; MATERIAL:; ESCALA:1:10; N.º DE DIBUJO; TÍTULO:; HOJA 1 DE 1; PESO:; 3cajas

Producto SOLIDWORKS Educational. Solo para uso en la enseñanza.

ELEMENTO N.º DE PIEZA DESCRIPCIÓN CANTIDAD

LAS COTAS SE EXPRESAN EN MM

SI NO SE INDICA LO CONTRARIO: ACABADO:

NOMBRE FIRMA FECHA

NO CAMBIE LA ESCALA REVISIÓN

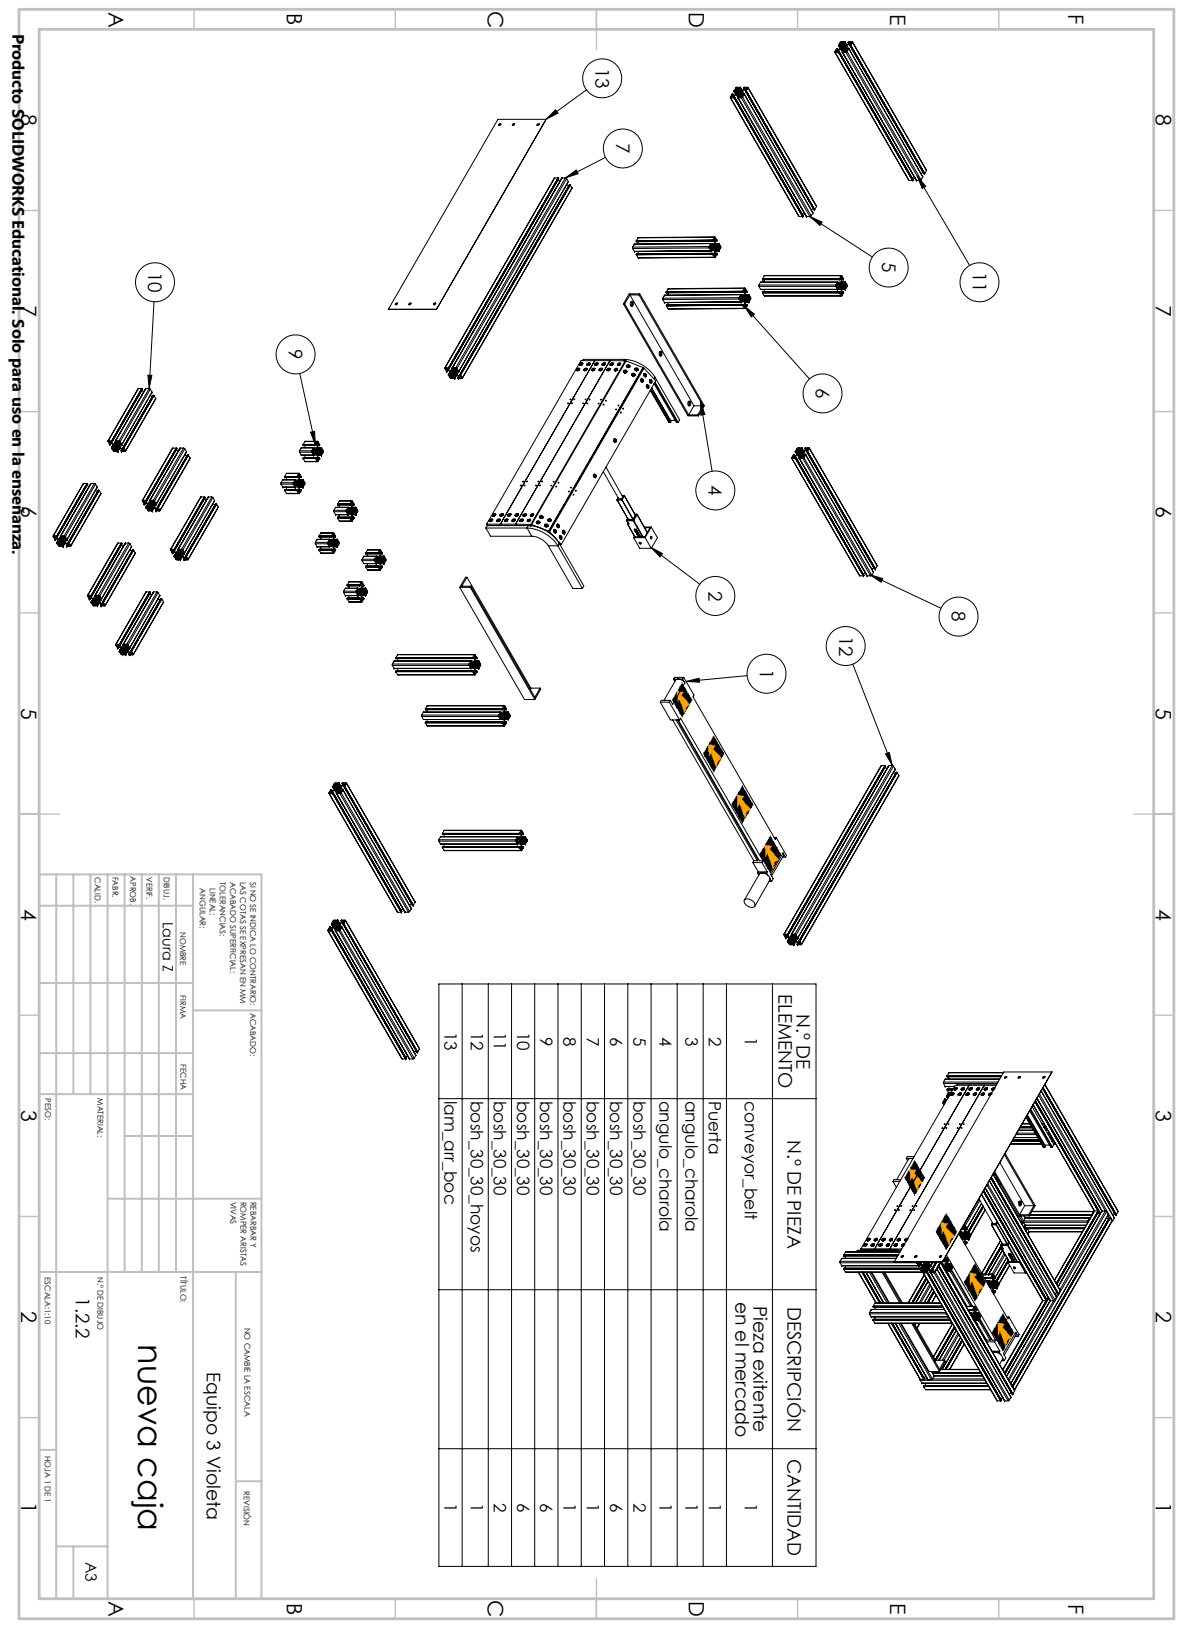
[picture p63: page 33]
Laura Z; Pieza exitente 1; 2 Puerta 1; 3 angulo_charola 1; 4 angulo_charola 1; 5 bosh_30_30 2; 6 bosh_30_30 6; 7 bosh_30_30 1; 8 bosh_30_30 1; 9 bosh_30_30 6; 10 bosh_30_30 6; 11 bosh_30_30 2; 12 bosh_30_30_hoyos 1; 13 lam_arr_boc 1; CALID.; FABR.; APROB.; VERIF.; DIBUJ.; ANGULAR:; LINEAL:; TOLERANCIAS:; ACABADO SUPERFICIAL:; VIVAS; ROMPER ARISTAS; REBARBAR Y; MATERIAL:; ESCALA:1:10; N.º DE DIBUJO; TÍTULO:; HOJA 1 DE 1; PESO:; nueva caja; Equipo 3 Violeta

Producto SOLIDWORKS Educational. Solo para uso en la enseñanza.

LAS COTAS SE EXPRESAN EN MM

SI NO SE INDICA LO CONTRARIO: ACABADO:

NOMBRE FIRMA FECHA

ELEMENTO N.º DE PIEZA DESCRIPCIÓN CANTIDAD

1 conveyor_belt en el mercado

NO CAMBIE LA ESCALA REVISIÓN

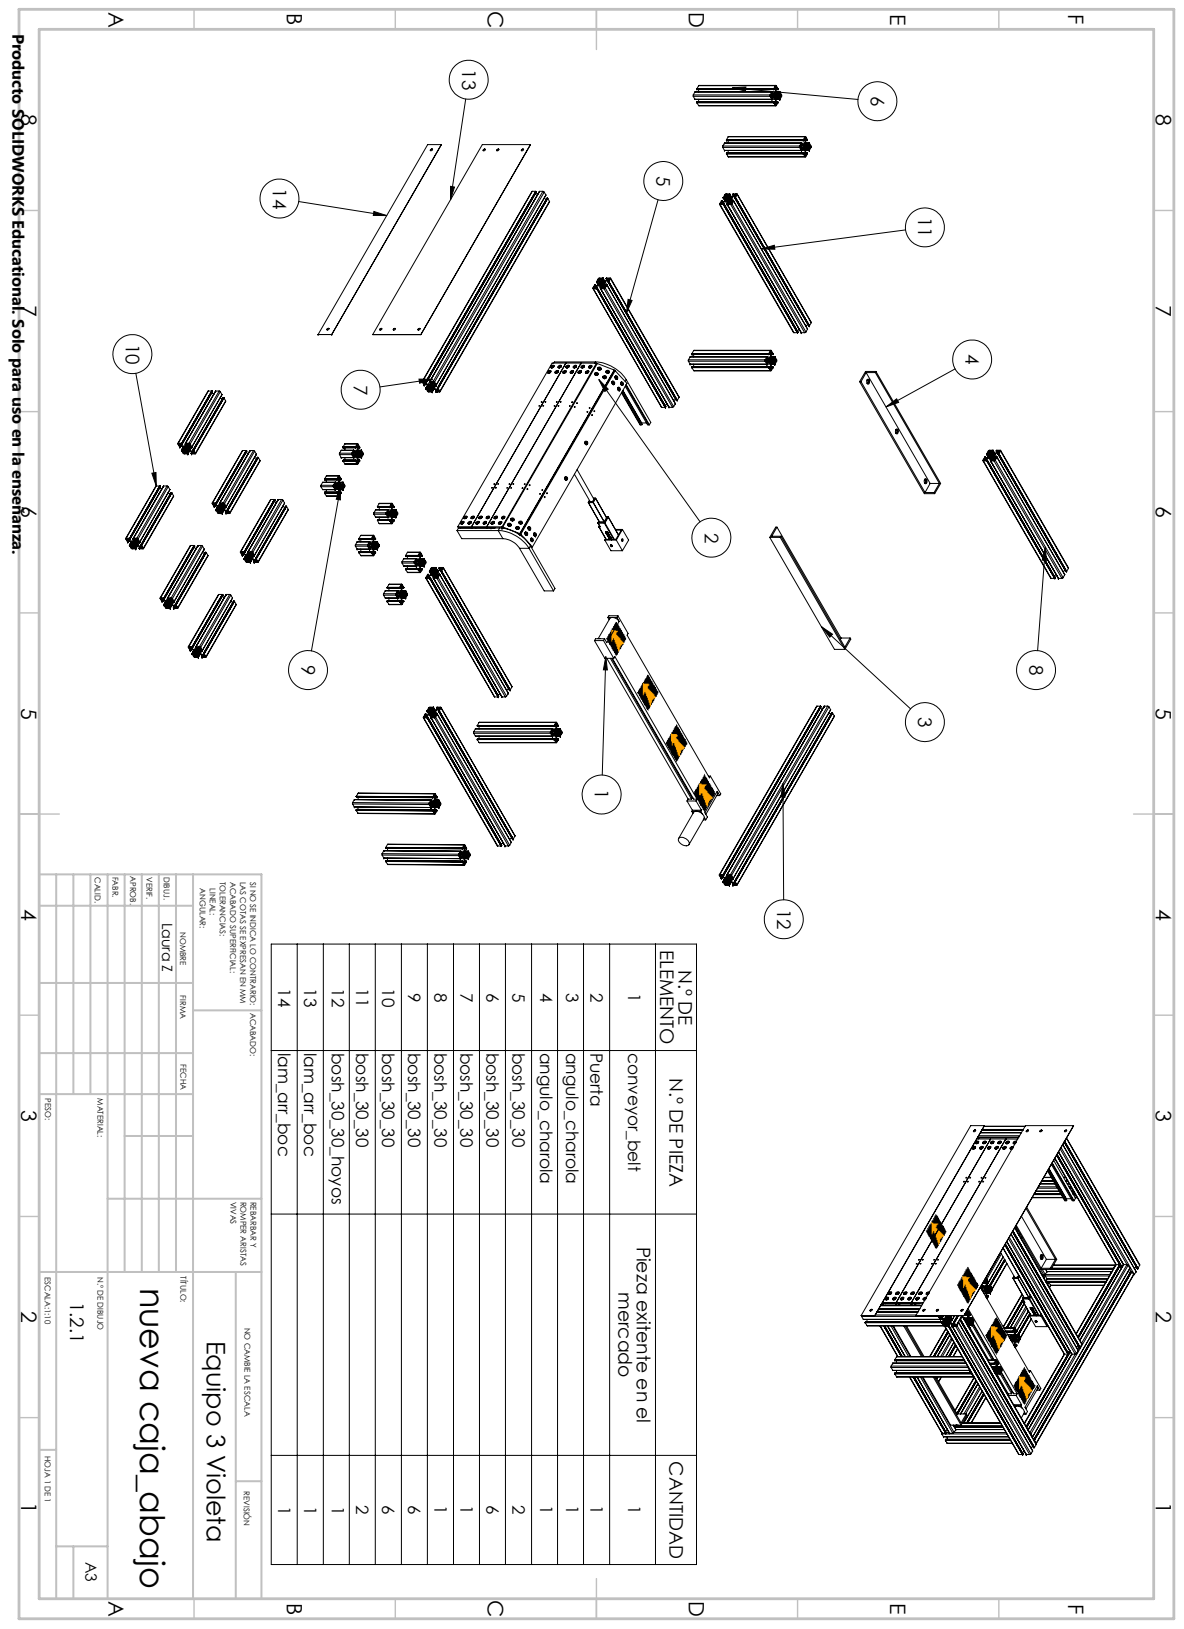
[picture p64: page 34]
Laura Z; mercado 1; 2 Puerta 1; 3 angulo_charola 1; 4 angulo_charola 1; 5 bosh_30_30 2; 6 bosh_30_30 6; 7 bosh_30_30 1; 8 bosh_30_30 1; 9 bosh_30_30 6; 10 bosh_30_30 6; 11 bosh_30_30 2; 12 bosh_30_30_hoyos 1; 13 lam_arr_boc 1; 14 lam_arr_boc 1; CALID.; FABR.; APROB.; VERIF.; DIBUJ.; ANGULAR:; LINEAL:; TOLERANCIAS:; ACABADO SUPERFICIAL:; VIVAS; ROMPER ARISTAS; REBARBAR Y; MATERIAL:; ESCALA:1:10; N.º DE DIBUJO; TÍTULO:; HOJA 1 DE 1; PESO:; nueva caja_abajo; Equipo 3 Violeta

Producto SOLIDWORKS Educational. Solo para uso en la enseñanza.

LAS COTAS SE EXPRESAN EN MM

SI NO SE INDICA LO CONTRARIO: ACABADO:

NOMBRE FIRMA FECHA

ELEMENTO N.º DE PIEZA CANTIDAD

1 conveyor_belt Pieza exitente en el

NO CAMBIE LA ESCALA REVISIÓN

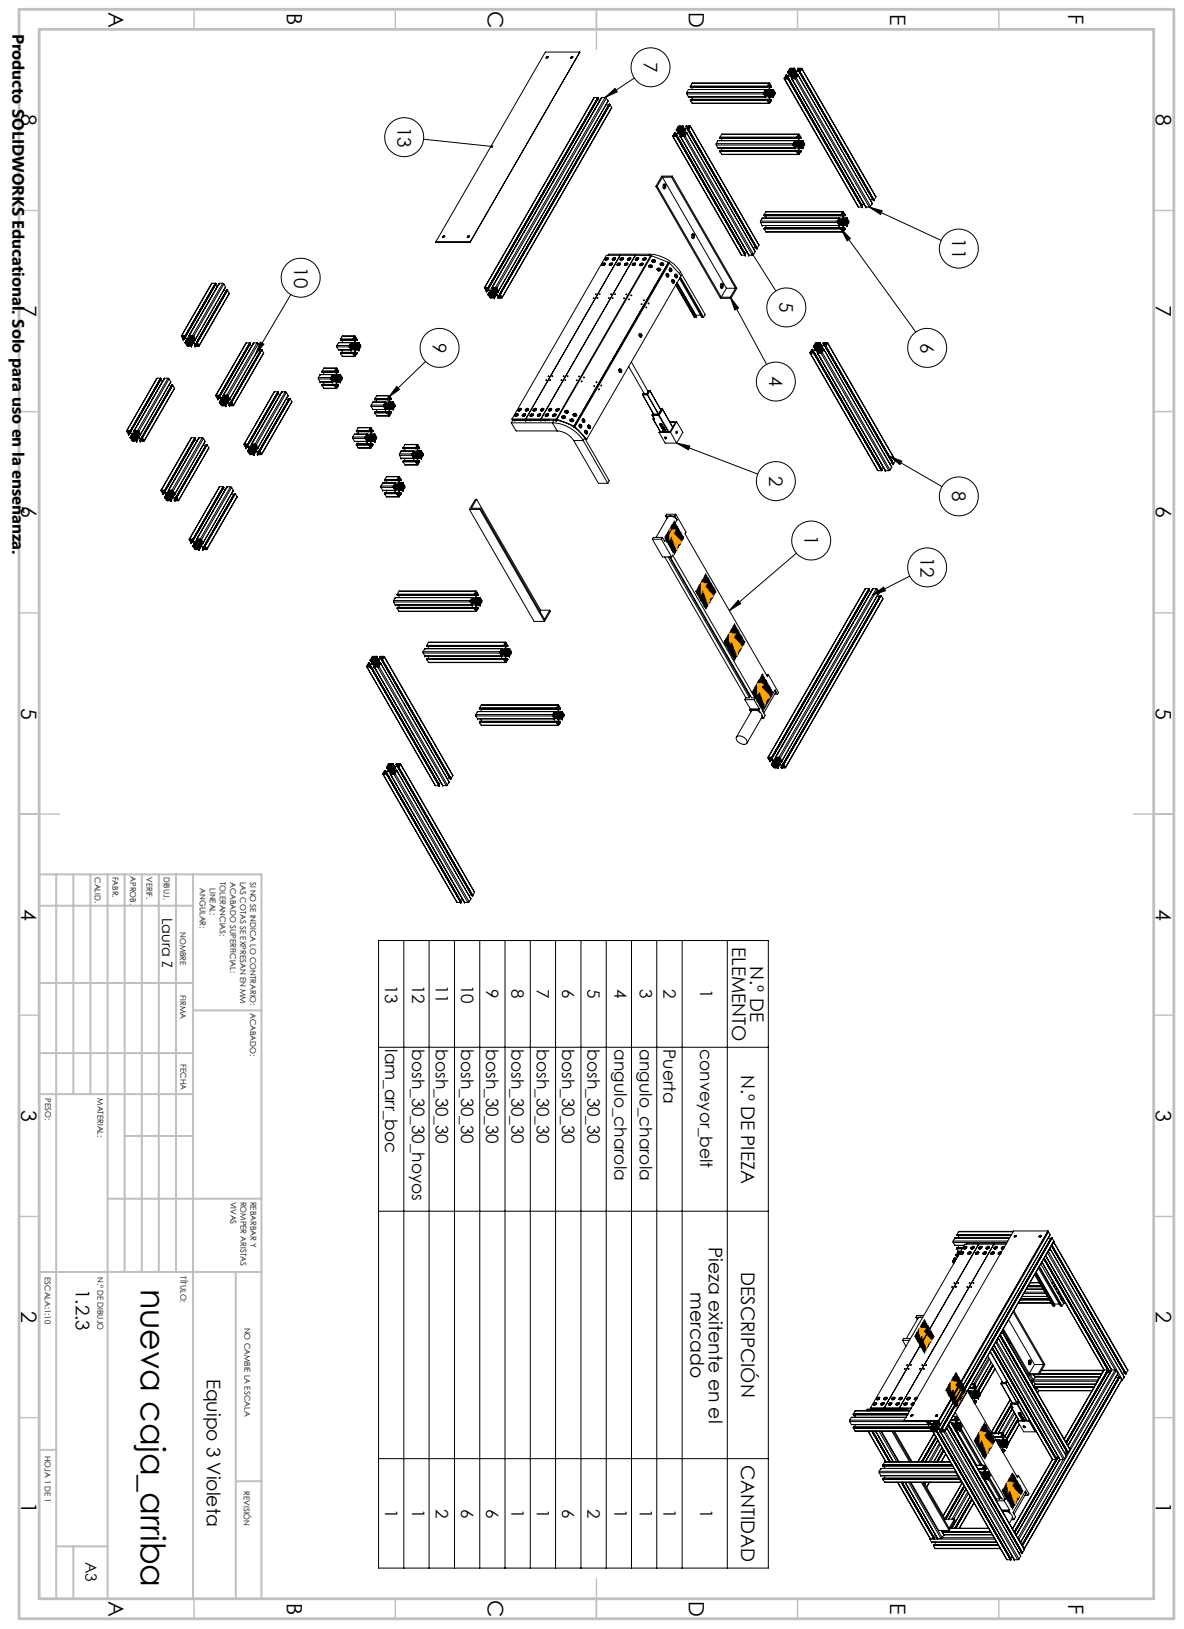
[picture p65: page 35]
Laura Z; mercado 1; 2 Puerta 1; 3 angulo_charola 1; 4 angulo_charola 1; 5 bosh_30_30 2; 6 bosh_30_30 6; 7 bosh_30_30 1; 8 bosh_30_30 1; 9 bosh_30_30 6; 10 bosh_30_30 6; 11 bosh_30_30 2; 12 bosh_30_30_hoyos 1; 13 lam_arr_boc 1; CALID.; FABR.; APROB.; VERIF.; DIBUJ.; ANGULAR:; LINEAL:; TOLERANCIAS:; ACABADO SUPERFICIAL:; VIVAS; ROMPER ARISTAS; REBARBAR Y; MATERIAL:; ESCALA:1:10; N.º DE DIBUJO; TÍTULO:; HOJA 1 DE 1; PESO:; nueva caja_arriba; Equipo 3 Violeta

Producto SOLIDWORKS Educational. Solo para uso en la enseñanza.

LAS COTAS SE EXPRESAN EN MM

SI NO SE INDICA LO CONTRARIO: ACABADO:

NOMBRE FIRMA FECHA

ELEMENTO N.º DE PIEZA DESCRIPCIÓN CANTIDAD

1 conveyor_belt Pieza exitente en el

NO CAMBIE LA ESCALA REVISIÓN

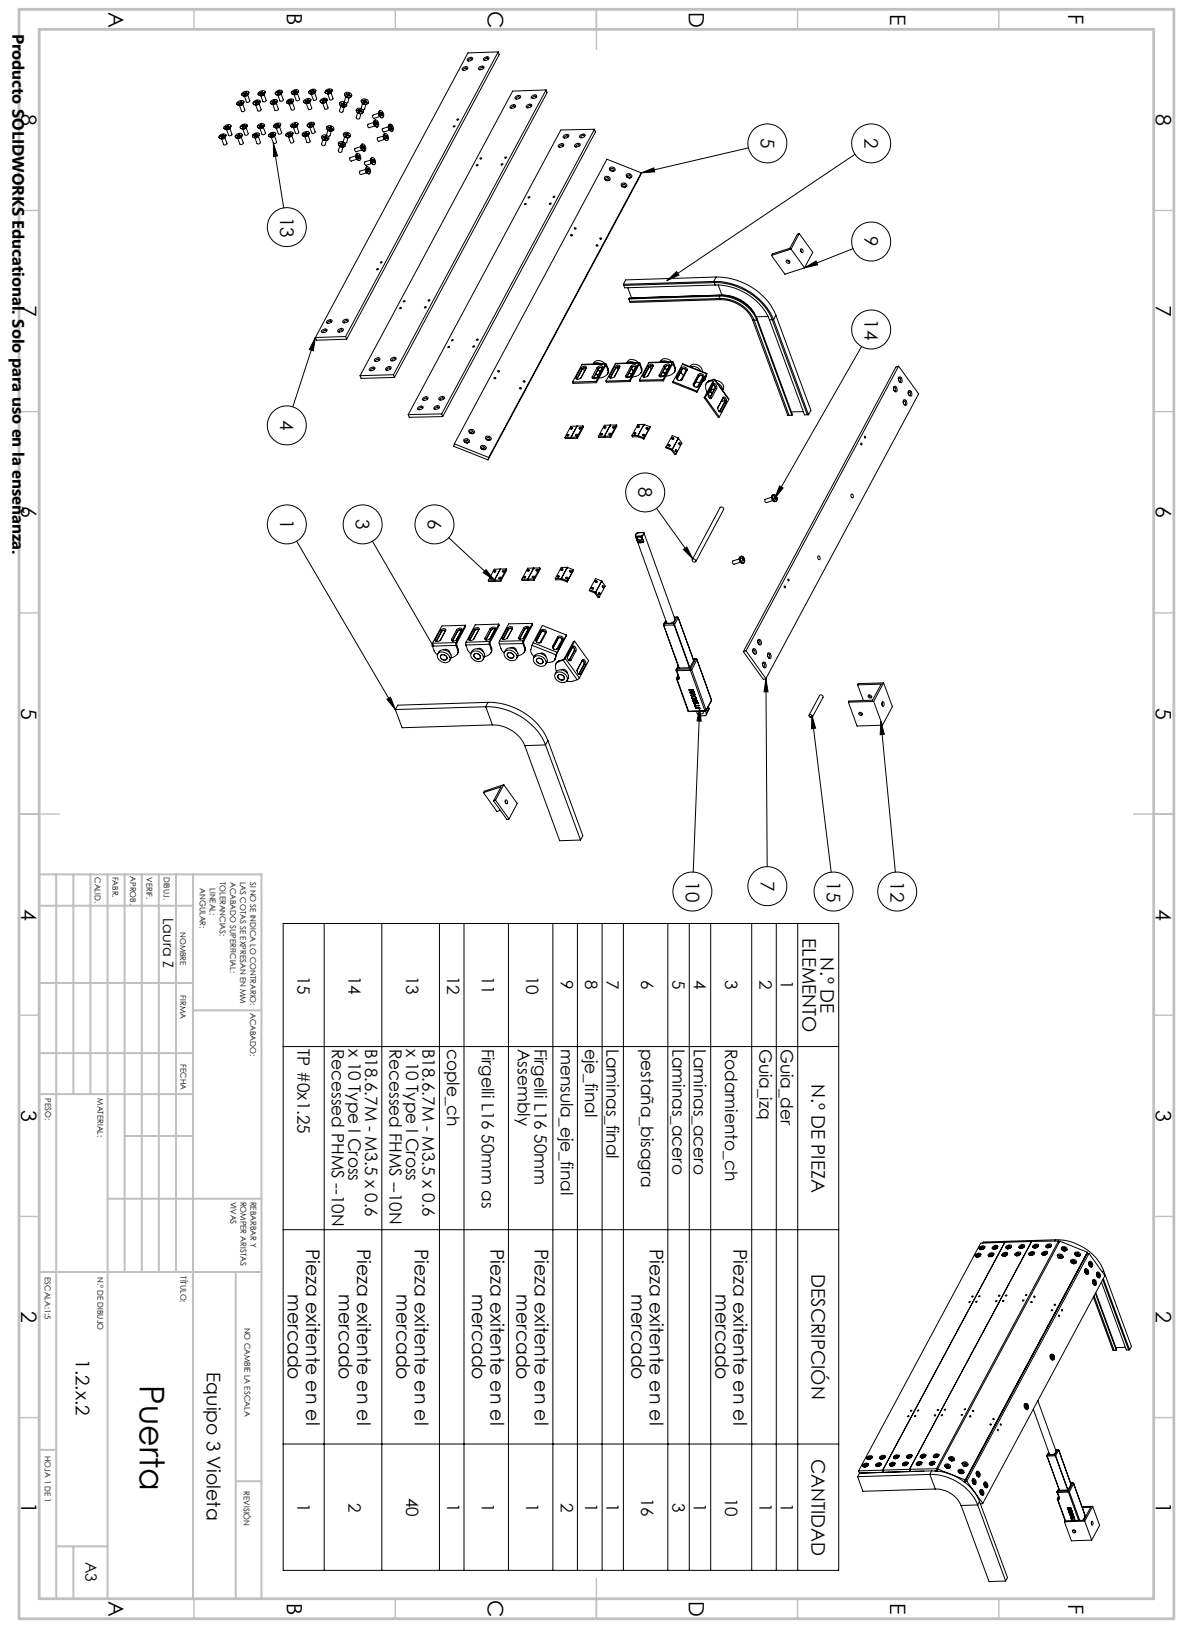
[picture p66: page 36]
Laura Z; 1 Guia_der 1 2 Guia_izq 1; mercado 10; 4 Laminas_acero 1 5 Laminas_acero 3; mercado 16; 7 Laminas_final 1 8 eje_final 1; 9 mensula_eje_final 2; 10 Assembly; mercado 1; 12 cople_ch 1; Recessed FHMS --10N; x 10 Type I Cross; mercado 40; Recessed PHMS --10N; mercado 2; CALID.; FABR.; APROB.; VERIF.; DIBUJ.; ANGULAR:; LINEAL:; TOLERANCIAS:; ACABADO SUPERFICIAL:; VIVAS; ROMPER ARISTAS; REBARBAR Y; MATERIAL:; ESCALA:1:5; N.º DE DIBUJO; TÍTULO:; HOJA 1 DE 1; PESO:; Puerta; Equipo 3 Violeta

Producto SOLIDWORKS Educational. Solo para uso en la enseñanza.

LAS COTAS SE EXPRESAN EN MM

SI NO SE INDICA LO CONTRARIO: ACABADO:

NOMBRE FIRMA FECHA

ELEMENTO N.º DE PIEZA DESCRIPCIÓN CANTIDAD

15 TP #0x1.25 Pieza exitente en el

11 Firgelli L16 50mm as Pieza exitente en el

6 pestaña_bisagra Pieza exitente en el

3 Rodamiento_ch Pieza exitente en el

B18.6.7M - M3.5 x 0.6 Pieza exitente en el

Firgelli L16 50mm Pieza exitente en el

NO CAMBIE LA ESCALA REVISIÓN

18.43
7.00

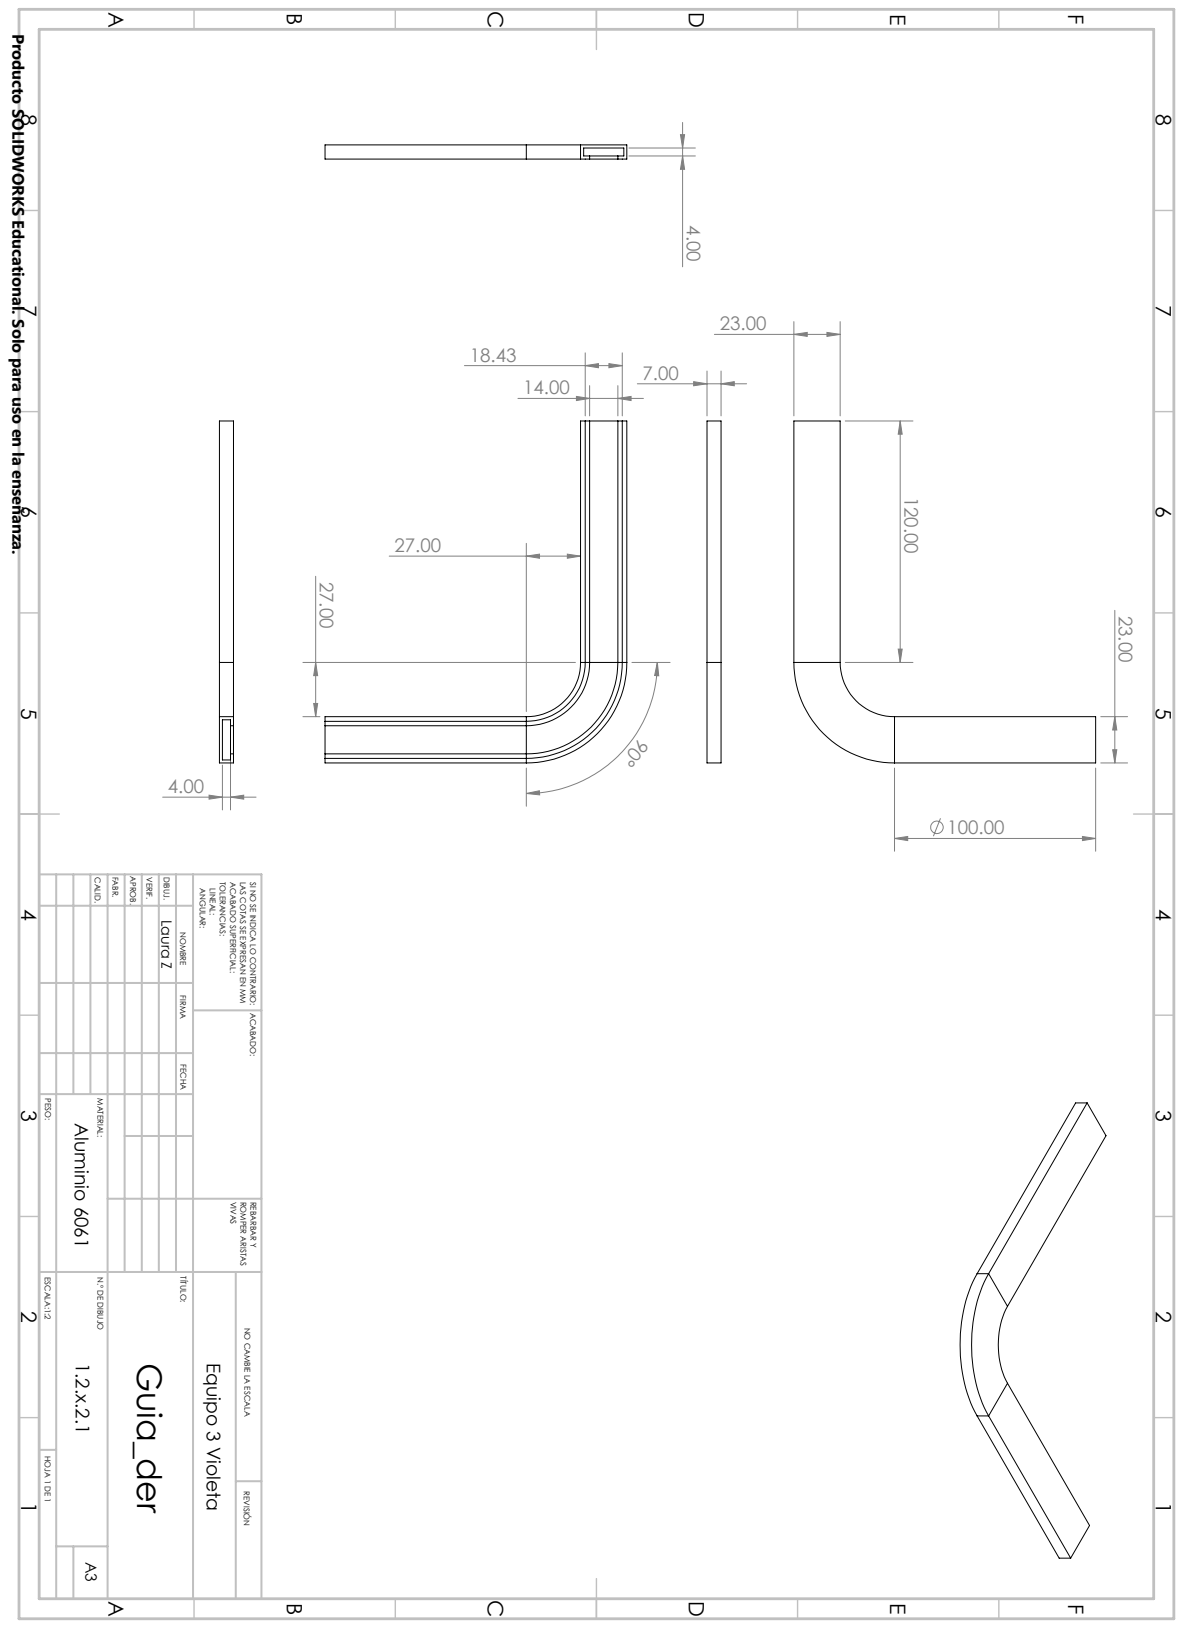
[picture p67: page 37]
Laura Z; Aluminio 6061; CALID.; FABR.; APROB.; VERIF.; DIBUJ.; ANGULAR:; LINEAL:; TOLERANCIAS:; ACABADO SUPERFICIAL:; VIVAS; ROMPER ARISTAS; REBARBAR Y; MATERIAL:; ESCALA:1:2; N.º DE DIBUJO; TÍTULO:; HOJA 1 DE 1; PESO:; Guia_der; Equipo 3 Violeta

Producto SOLIDWORKS Educational. Solo para uso en la enseñanza.

LAS COTAS SE EXPRESAN EN MM

SI NO SE INDICA LO CONTRARIO: ACABADO:

NOMBRE FIRMA FECHA

NO CAMBIE LA ESCALA REVISIÓN

20.00
7.00

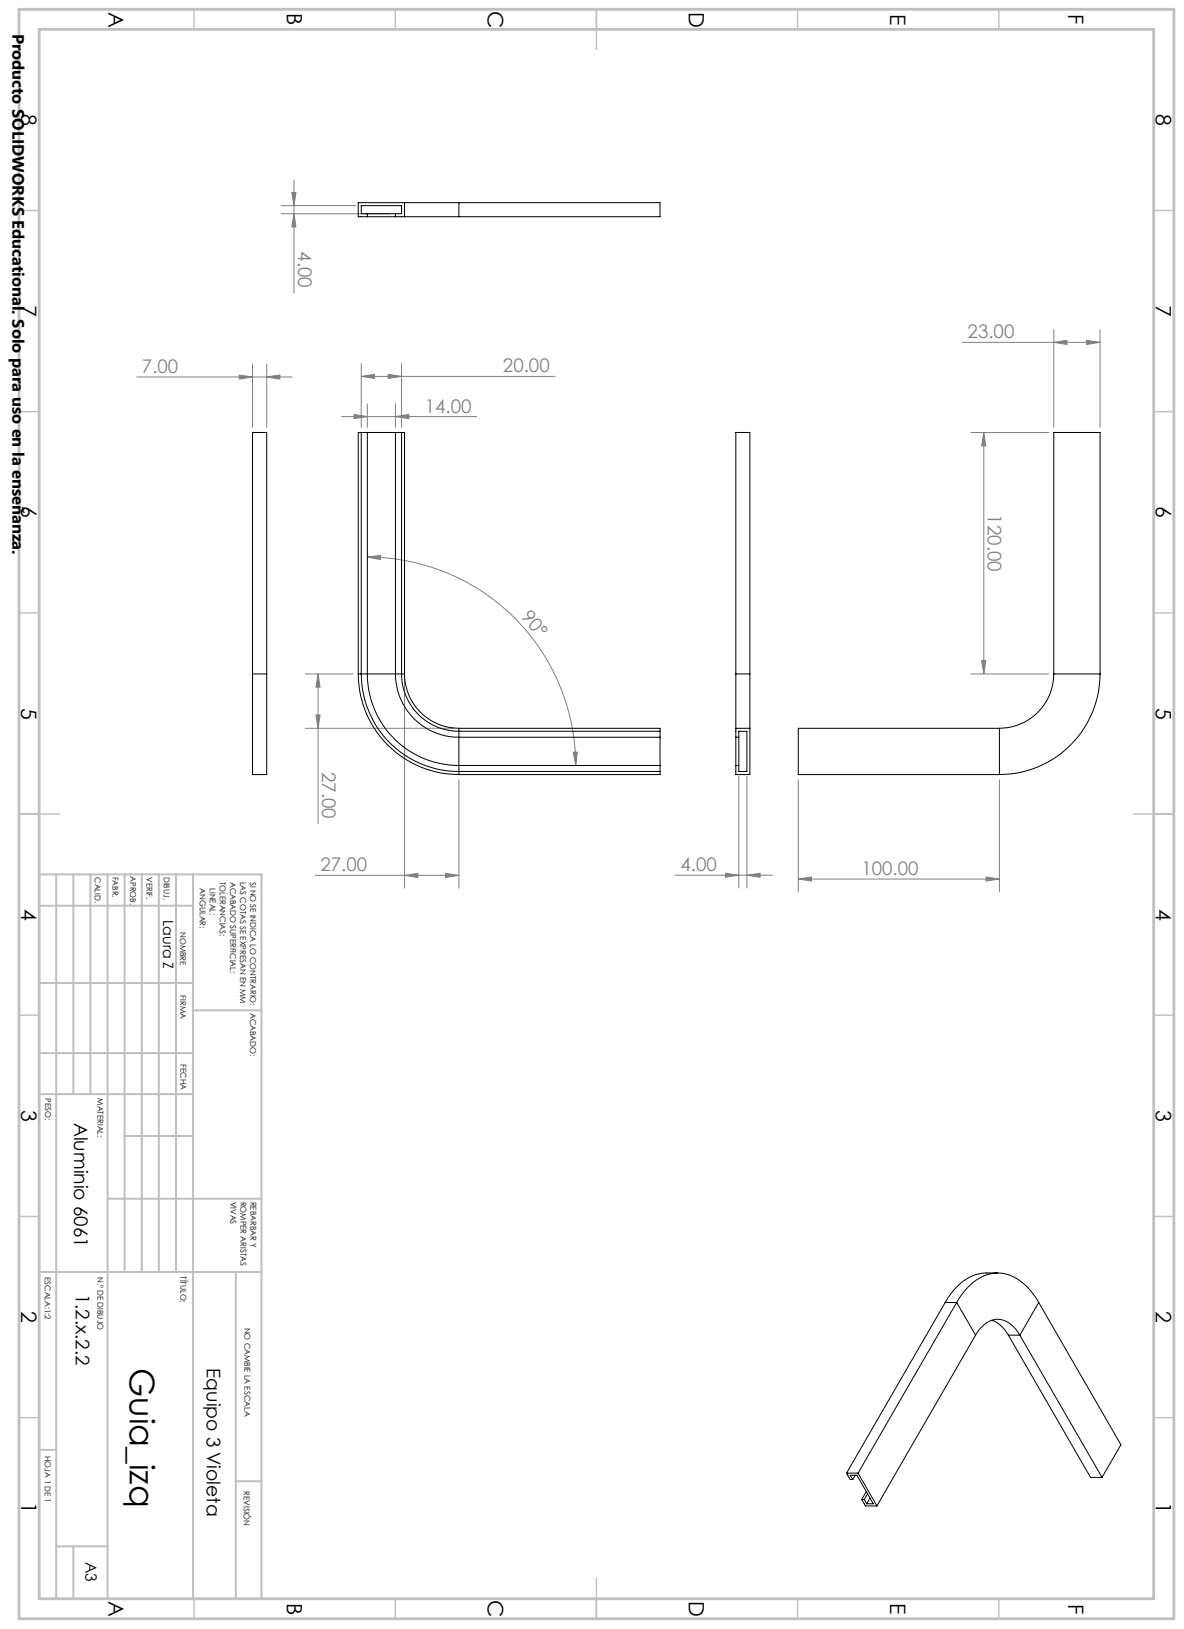
[picture p68: page 38]
Aluminio 6061; Laura Z; CALID.; FABR.; APROB.; VERIF.; DIBUJ.; ANGULAR:; LINEAL:; TOLERANCIAS:; ACABADO SUPERFICIAL:; VIVAS; ROMPER ARISTAS; REBARBAR Y; MATERIAL:; ESCALA:1:2; N.º DE DIBUJO; TÍTULO:; HOJA 1 DE 1; PESO:; Guia_izq; Equipo 3 Violeta

Producto SOLIDWORKS Educational. Solo para uso en la enseñanza.

LAS COTAS SE EXPRESAN EN MM

SI NO SE INDICA LO CONTRARIO: ACABADO:

NOMBRE FIRMA FECHA

NO CAMBIE LA ESCALA REVISIÓN

33.50

4.75

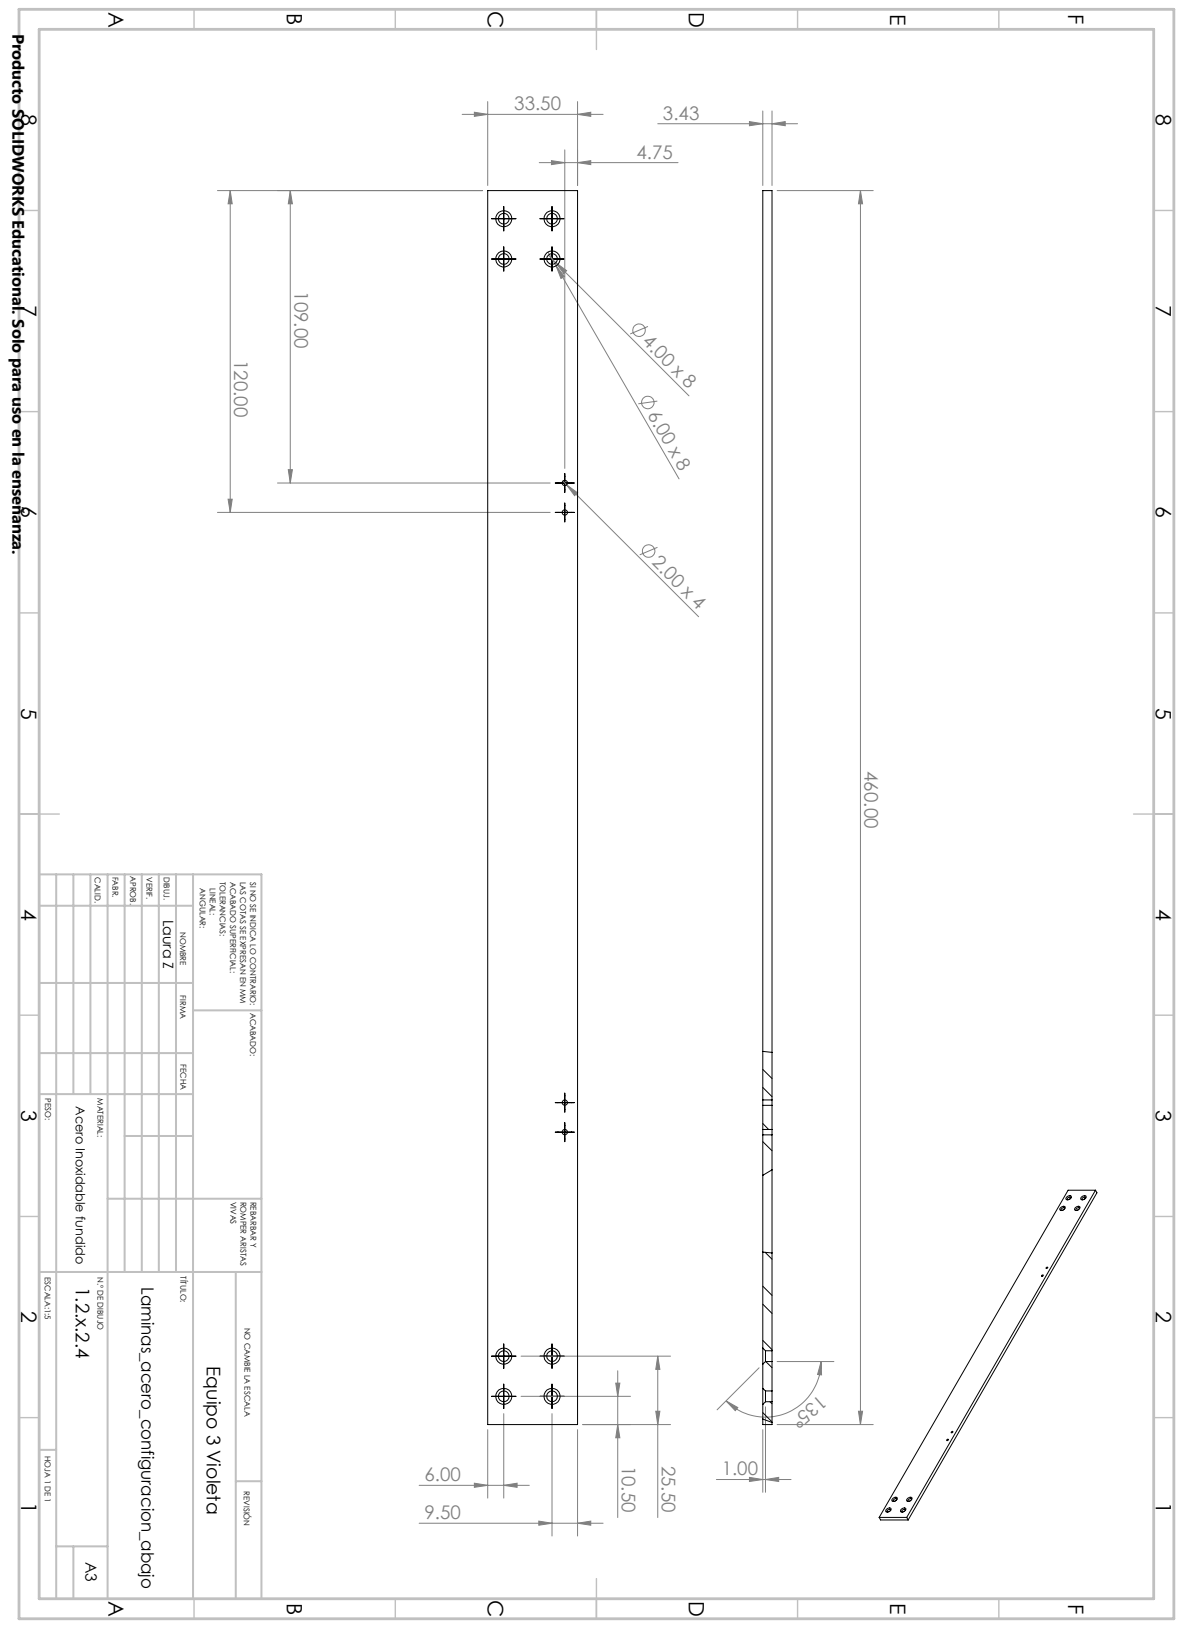
[picture p69: page 39]
Laura Z; CALID.; FABR.; APROB.; VERIF.; DIBUJ.; ANGULAR:; LINEAL:; TOLERANCIAS:; ACABADO SUPERFICIAL:; VIVAS; ROMPER ARISTAS; REBARBAR Y; MATERIAL:; ESCALA:1:5; N.º DE DIBUJO; TÍTULO:; HOJA 1 DE 1; PESO:; Laminas_acero_configuracion_abajo; Equipo 3 Violeta

Producto SOLIDWORKS Educational. Solo para uso en la enseñanza.

LAS COTAS SE EXPRESAN EN MM

SI NO SE INDICA LO CONTRARIO: ACABADO:

NOMBRE FIRMA FECHA

1.2.x.2.4 Acero Inoxidable fundido

NO CAMBIE LA ESCALA REVISIÓN

37.00

9.50 | 9.50

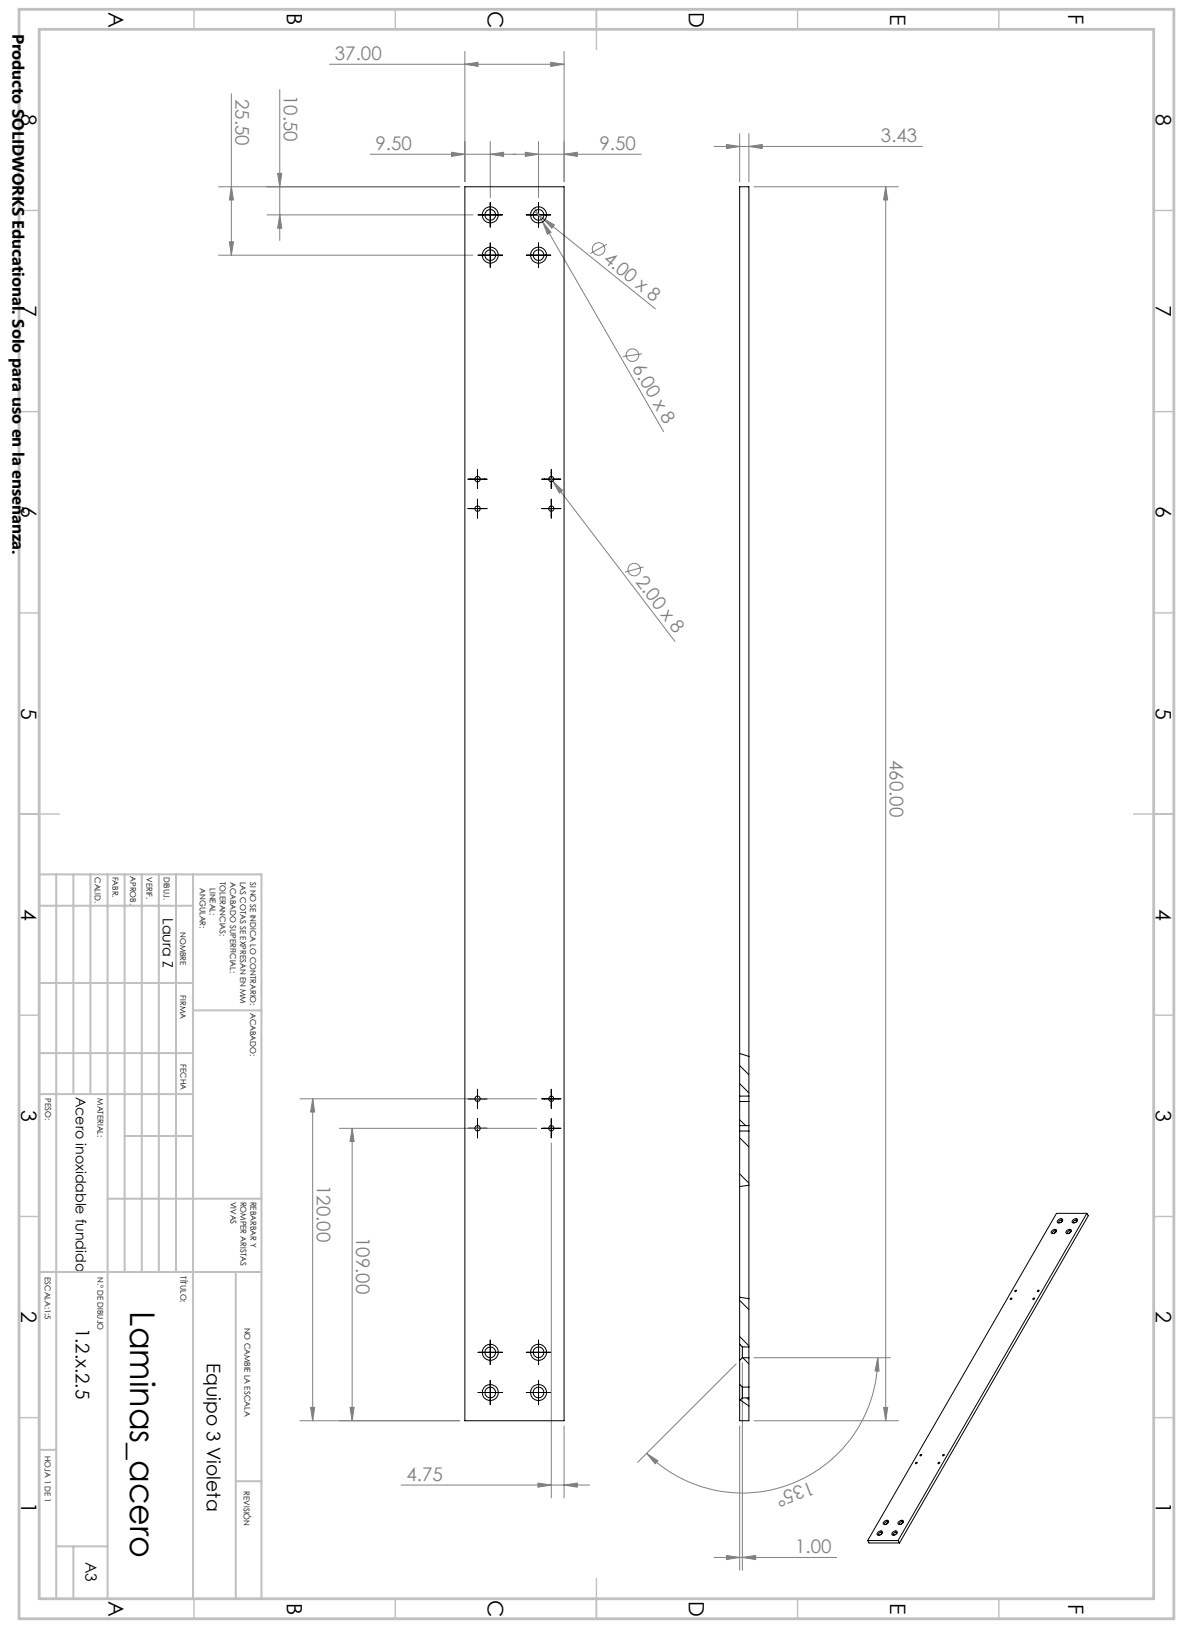
[picture p70: page 40]
Laura Z; CALID.; FABR.; APROB.; VERIF.; DIBUJ.; ANGULAR:; LINEAL:; TOLERANCIAS:; ACABADO SUPERFICIAL:; VIVAS; ROMPER ARISTAS; REBARBAR Y; MATERIAL:; ESCALA:1:5; N.º DE DIBUJO; TÍTULO:; HOJA 1 DE 1; PESO:; Laminas_acero; Equipo 3 Violeta

Producto SOLIDWORKS Educational. Solo para uso en la enseñanza.

LAS COTAS SE EXPRESAN EN MM

SI NO SE INDICA LO CONTRARIO: ACABADO:

NOMBRE FIRMA FECHA

1.2.x.2.5 Acero inoxidable fundido

NO CAMBIE LA ESCALA REVISIÓN

37.00
9.50 | 9.50

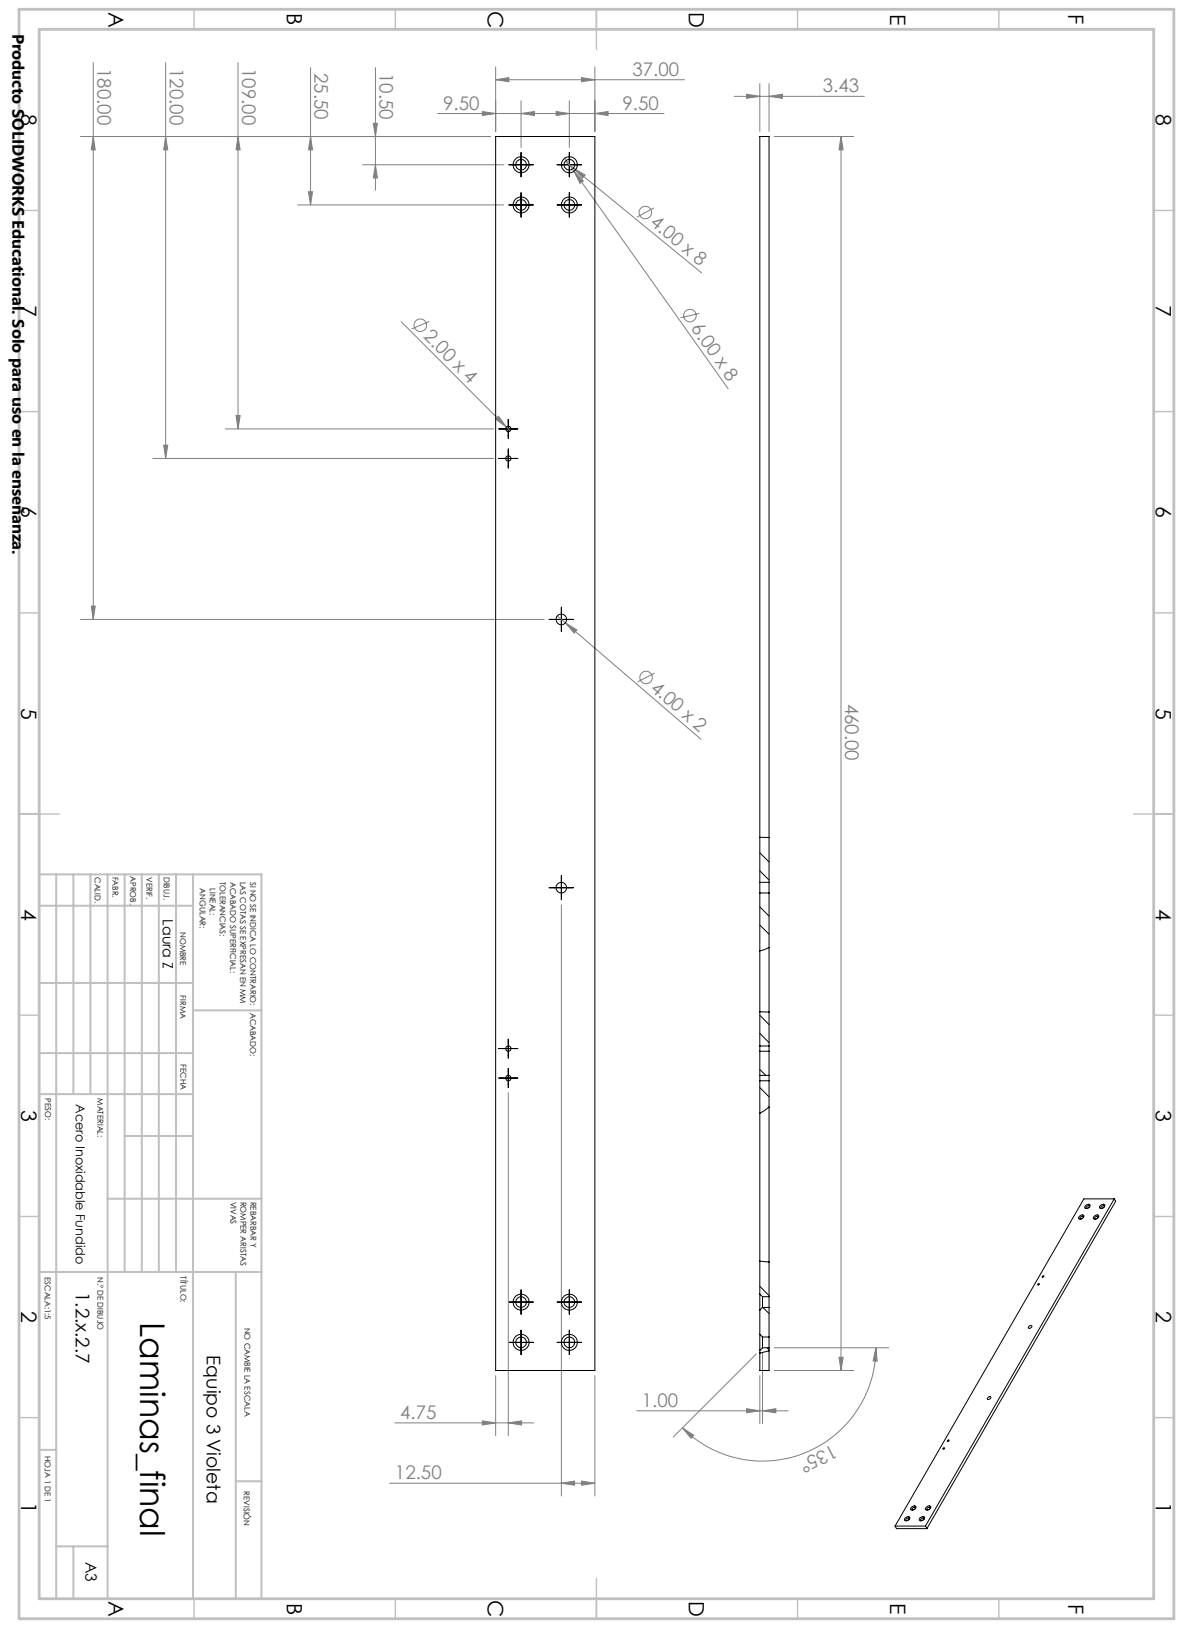
[picture p71: page 41]
Laura Z; CALID.; FABR.; APROB.; VERIF.; DIBUJ.; ANGULAR:; LINEAL:; TOLERANCIAS:; ACABADO SUPERFICIAL:; VIVAS; ROMPER ARISTAS; REBARBAR Y; MATERIAL:; ESCALA:1:5; N.º DE DIBUJO; TÍTULO:; HOJA 1 DE 1; PESO:; Laminas_final; Equipo 3 Violeta

Producto SOLIDWORKS Educational. Solo para uso en la enseñanza.

LAS COTAS SE EXPRESAN EN MM

SI NO SE INDICA LO CONTRARIO: ACABADO:

NOMBRE FIRMA FECHA

1.2.x.2.7 Acero Inoxidable Fundido

NO CAMBIE LA ESCALA REVISIÓN

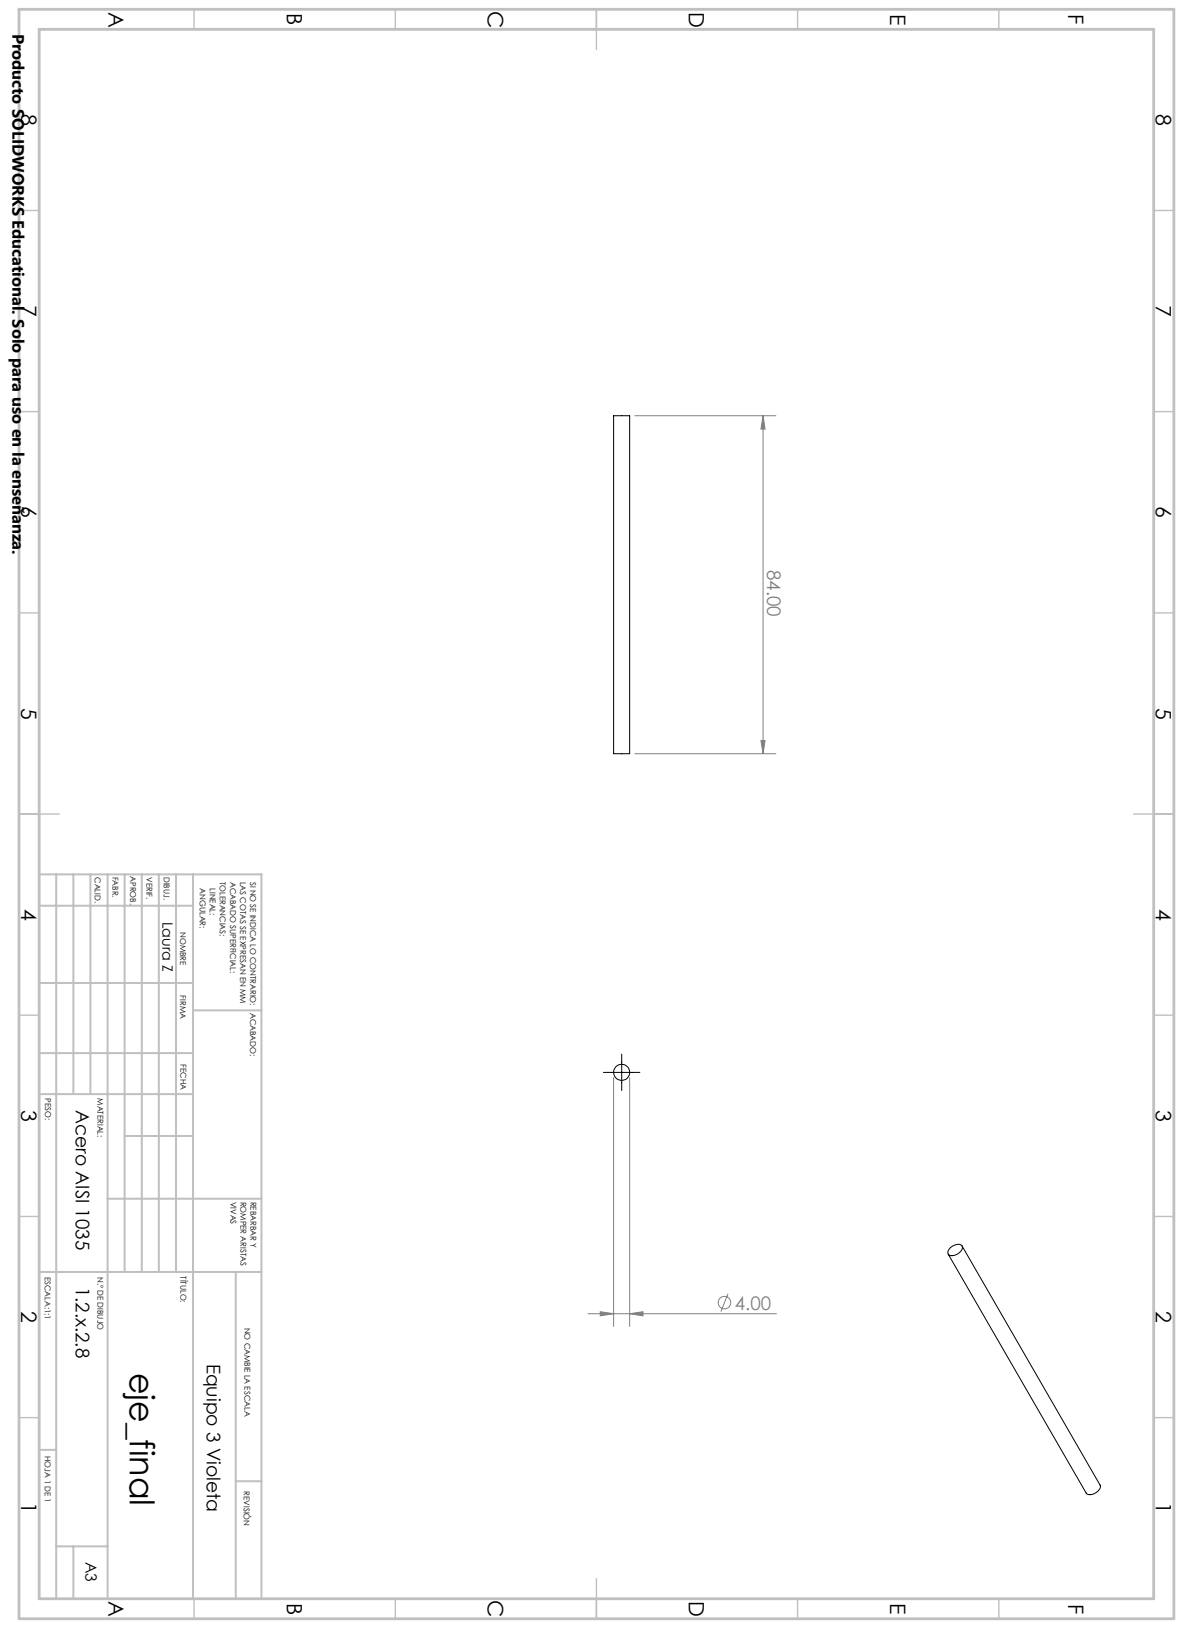
[picture p72: page 42]
Laura Z; CALID.; FABR.; APROB.; VERIF.; DIBUJ.; ANGULAR:; LINEAL:; TOLERANCIAS:; ACABADO SUPERFICIAL:; VIVAS; ROMPER ARISTAS; REBARBAR Y; MATERIAL:; ESCALA:1:1; N.º DE DIBUJO; TÍTULO:; HOJA 1 DE 1; PESO:; eje_final; Equipo 3 Violeta; 1.2.x.2.8 Acero AISI 1035

Producto SOLIDWORKS Educational. Solo para uso en la enseñanza.

LAS COTAS SE EXPRESAN EN MM

SI NO SE INDICA LO CONTRARIO: ACABADO:

NOMBRE FIRMA FECHA

NO CAMBIE LA ESCALA REVISIÓN

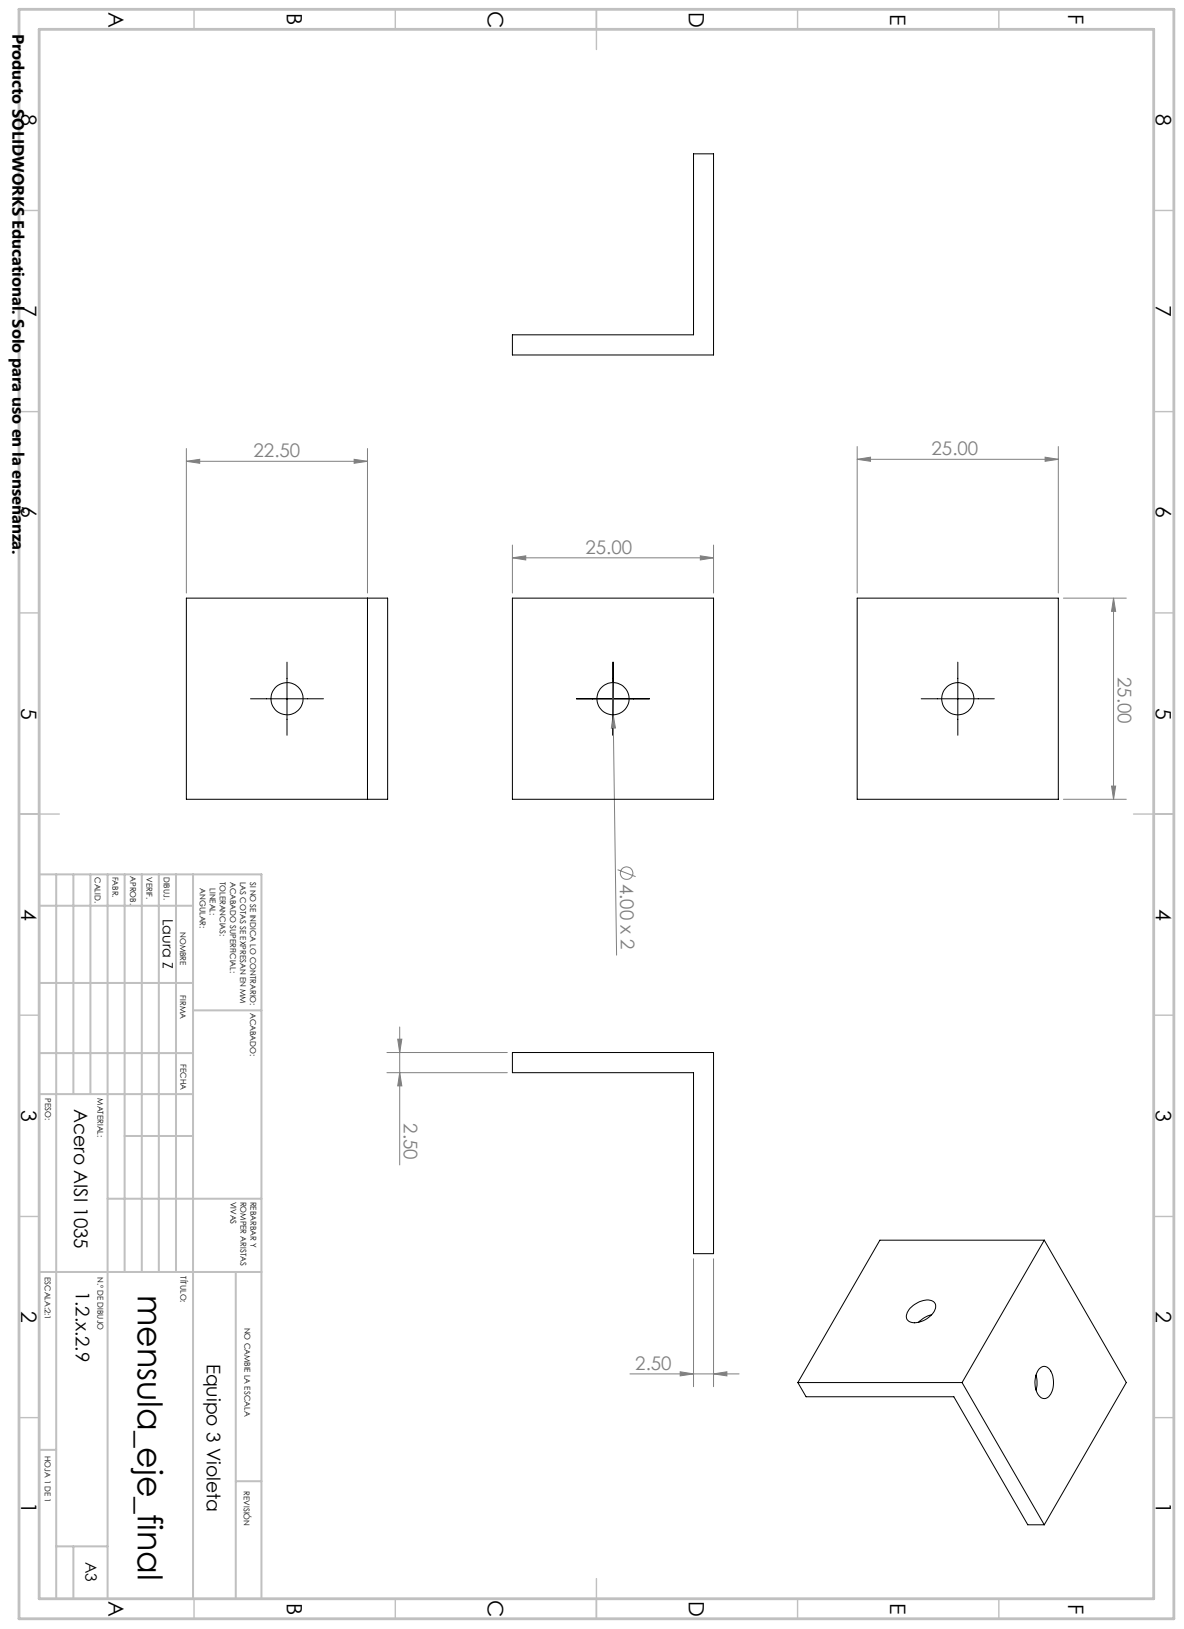
[picture p73: page 43]
Laura Z; Acero AISI 1035; CALID.; FABR.; APROB.; VERIF.; DIBUJ.; ANGULAR:; LINEAL:; TOLERANCIAS:; ACABADO SUPERFICIAL:; VIVAS; ROMPER ARISTAS; REBARBAR Y; MATERIAL:; ESCALA:2:1; N.º DE DIBUJO; TÍTULO:; HOJA 1 DE 1; PESO:; mensula_eje_final; Equipo 3 Violeta

Producto SOLIDWORKS Educational. Solo para uso en la enseñanza.

LAS COTAS SE EXPRESAN EN MM

SI NO SE INDICA LO CONTRARIO: ACABADO:

NOMBRE FIRMA FECHA

NO CAMBIE LA ESCALA REVISIÓN

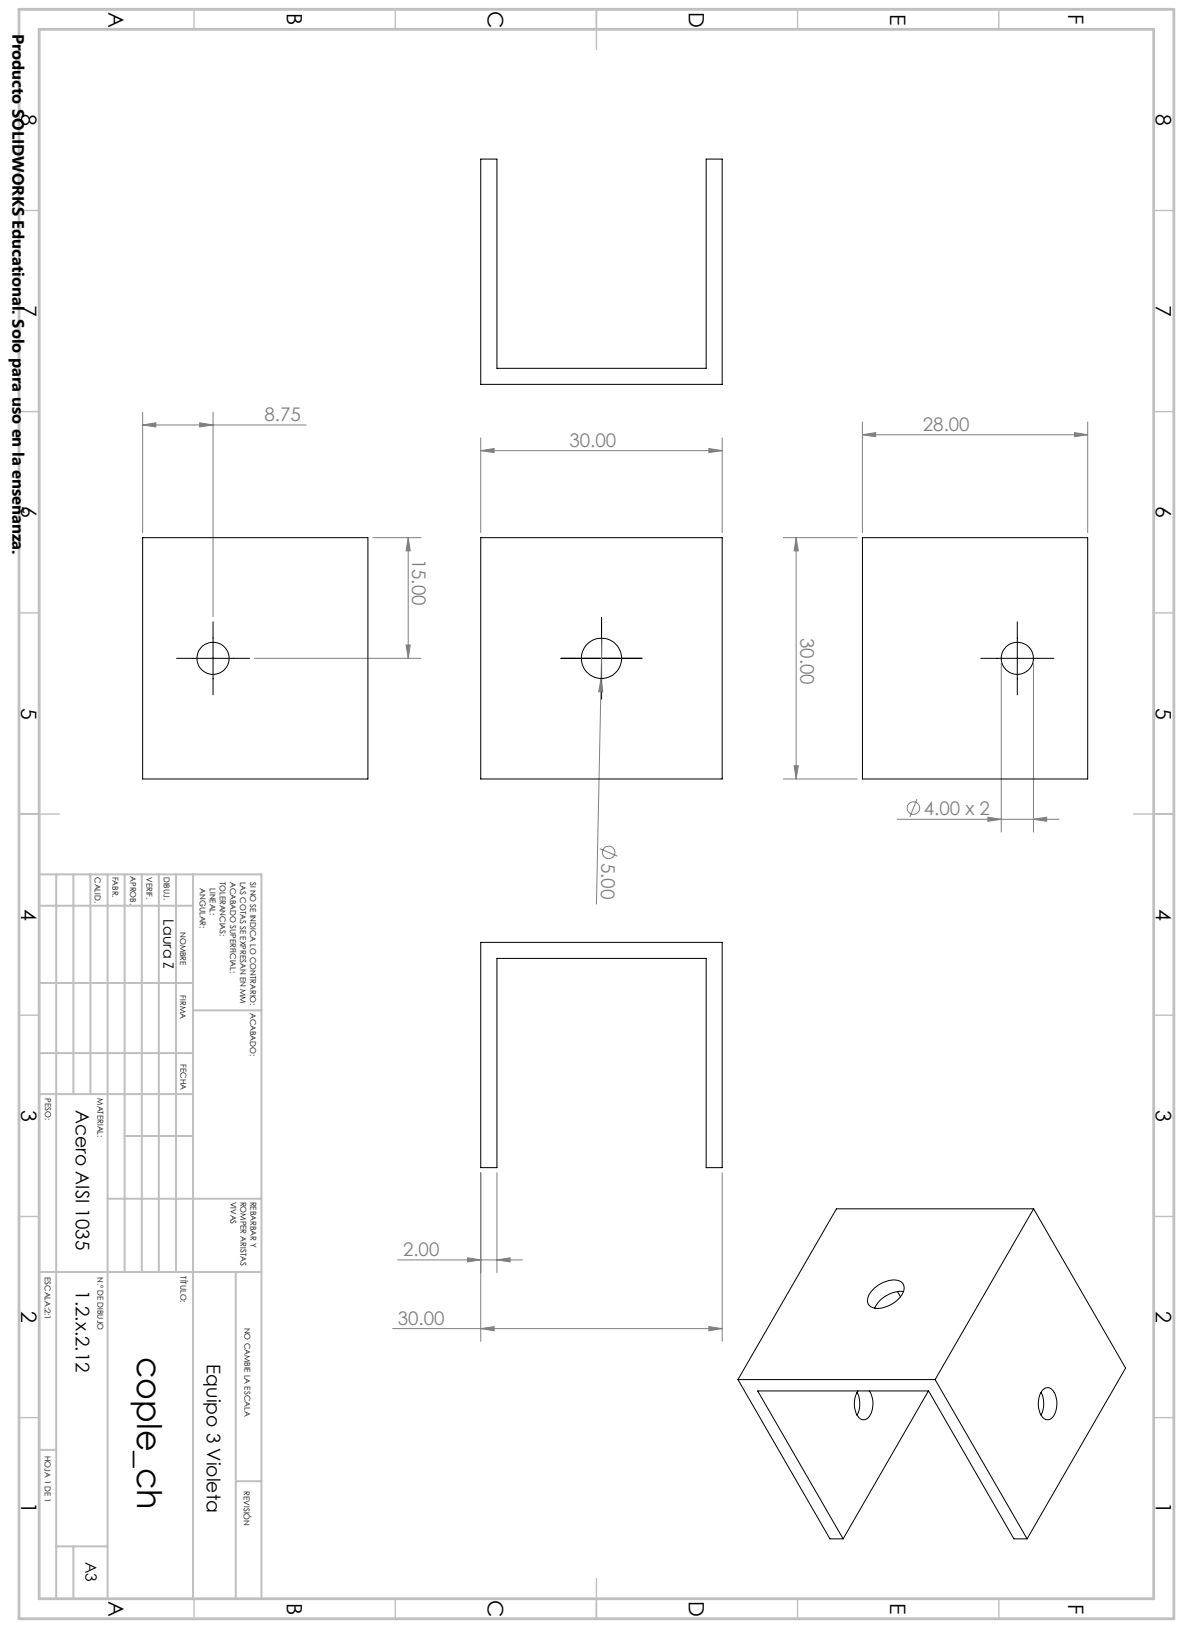
[picture p74: page 44]
Laura Z; CALID.; FABR.; APROB.; VERIF.; DIBUJ.; ANGULAR:; LINEAL:; TOLERANCIAS:; ACABADO SUPERFICIAL:; VIVAS; ROMPER ARISTAS; REBARBAR Y; MATERIAL:; ESCALA:2:1; N.º DE DIBUJO; TÍTULO:; HOJA 1 DE 1; PESO:; cople_ch; Equipo 3 Violeta; 1.2.x.2.12 Acero AISI 1035

Producto SOLIDWORKS Educational. Solo para uso en la enseñanza.

LAS COTAS SE EXPRESAN EN MM

SI NO SE INDICA LO CONTRARIO: ACABADO:

NOMBRE FIRMA FECHA

NO CAMBIE LA ESCALA REVISIÓN

8.00 x 3

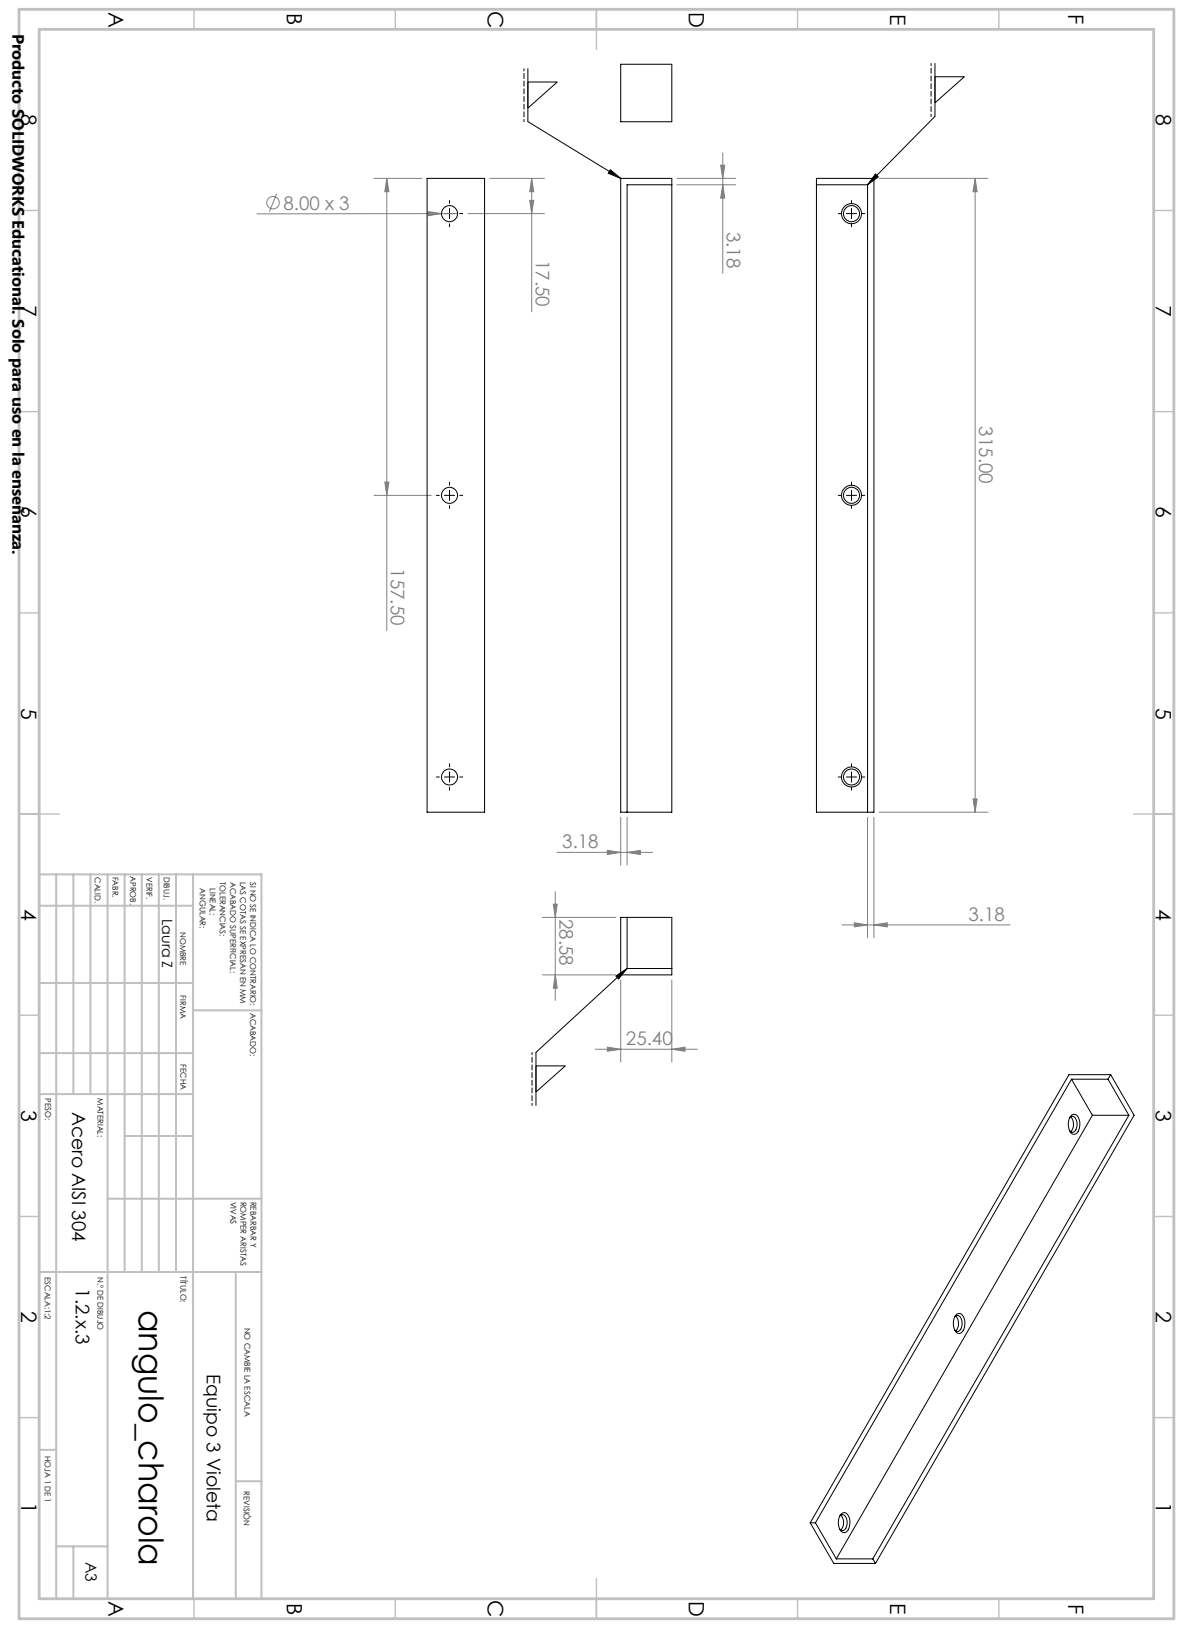
[picture p75: page 45]
Laura Z; Acero AISI 304; CALID.; FABR.; APROB.; VERIF.; DIBUJ.; ANGULAR:; LINEAL:; TOLERANCIAS:; ACABADO SUPERFICIAL:; VIVAS; ROMPER ARISTAS; REBARBAR Y; MATERIAL:; ESCALA:1:2; N.º DE DIBUJO; TÍTULO:; HOJA 1 DE 1; PESO:; angulo_charola; Equipo 3 Violeta

Producto SOLIDWORKS Educational. Solo para uso en la enseñanza.

LAS COTAS SE EXPRESAN EN MM

SI NO SE INDICA LO CONTRARIO: ACABADO:

NOMBRE FIRMA FECHA

NO CAMBIE LA ESCALA REVISIÓN

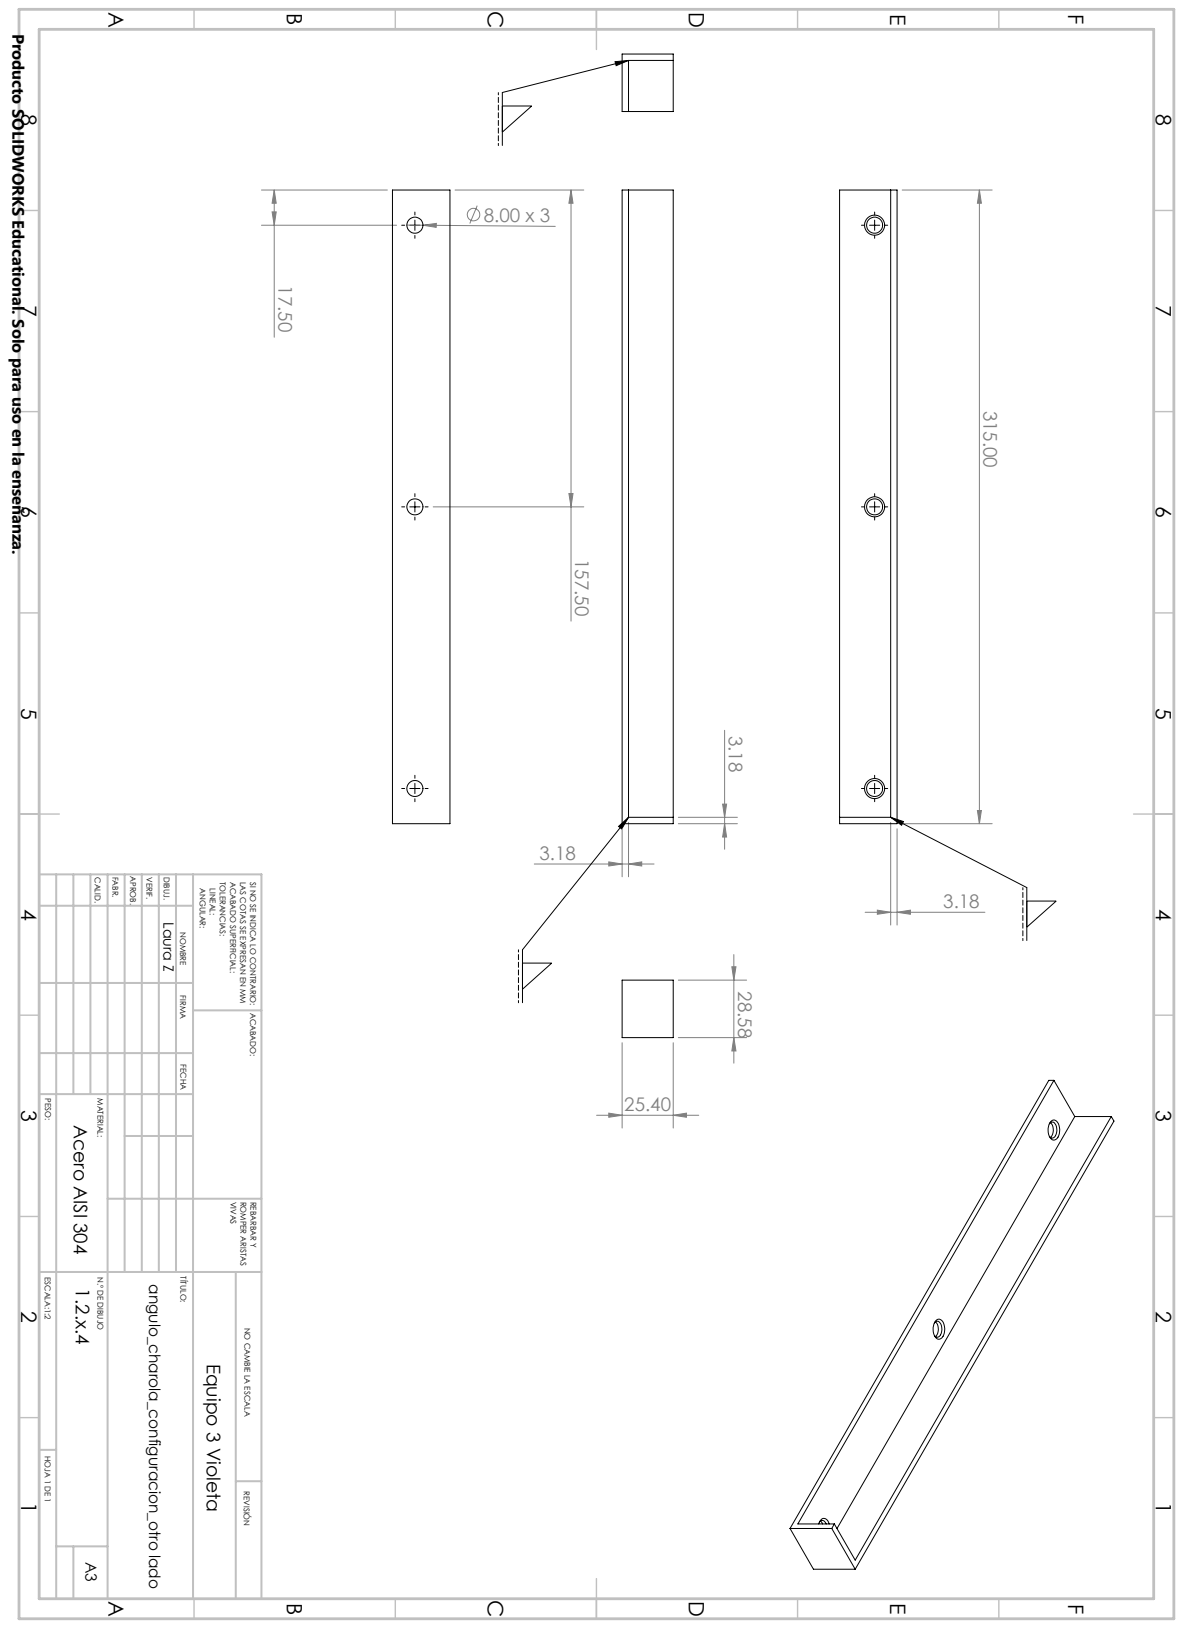
[picture p76: page 46]
Laura Z; Acero AISI 304; CALID.; FABR.; APROB.; VERIF.; DIBUJ.; ANGULAR:; LINEAL:; TOLERANCIAS:; ACABADO SUPERFICIAL:; VIVAS; ROMPER ARISTAS; REBARBAR Y; MATERIAL:; ESCALA:1:2; N.º DE DIBUJO; TÍTULO:; HOJA 1 DE 1; PESO:; angulo_charola_configuracion_otro lado; Equipo 3 Violeta

Producto SOLIDWORKS Educational. Solo para uso en la enseñanza.

LAS COTAS SE EXPRESAN EN MM

SI NO SE INDICA LO CONTRARIO: ACABADO:

NOMBRE FIRMA FECHA

NO CAMBIE LA ESCALA REVISIÓN

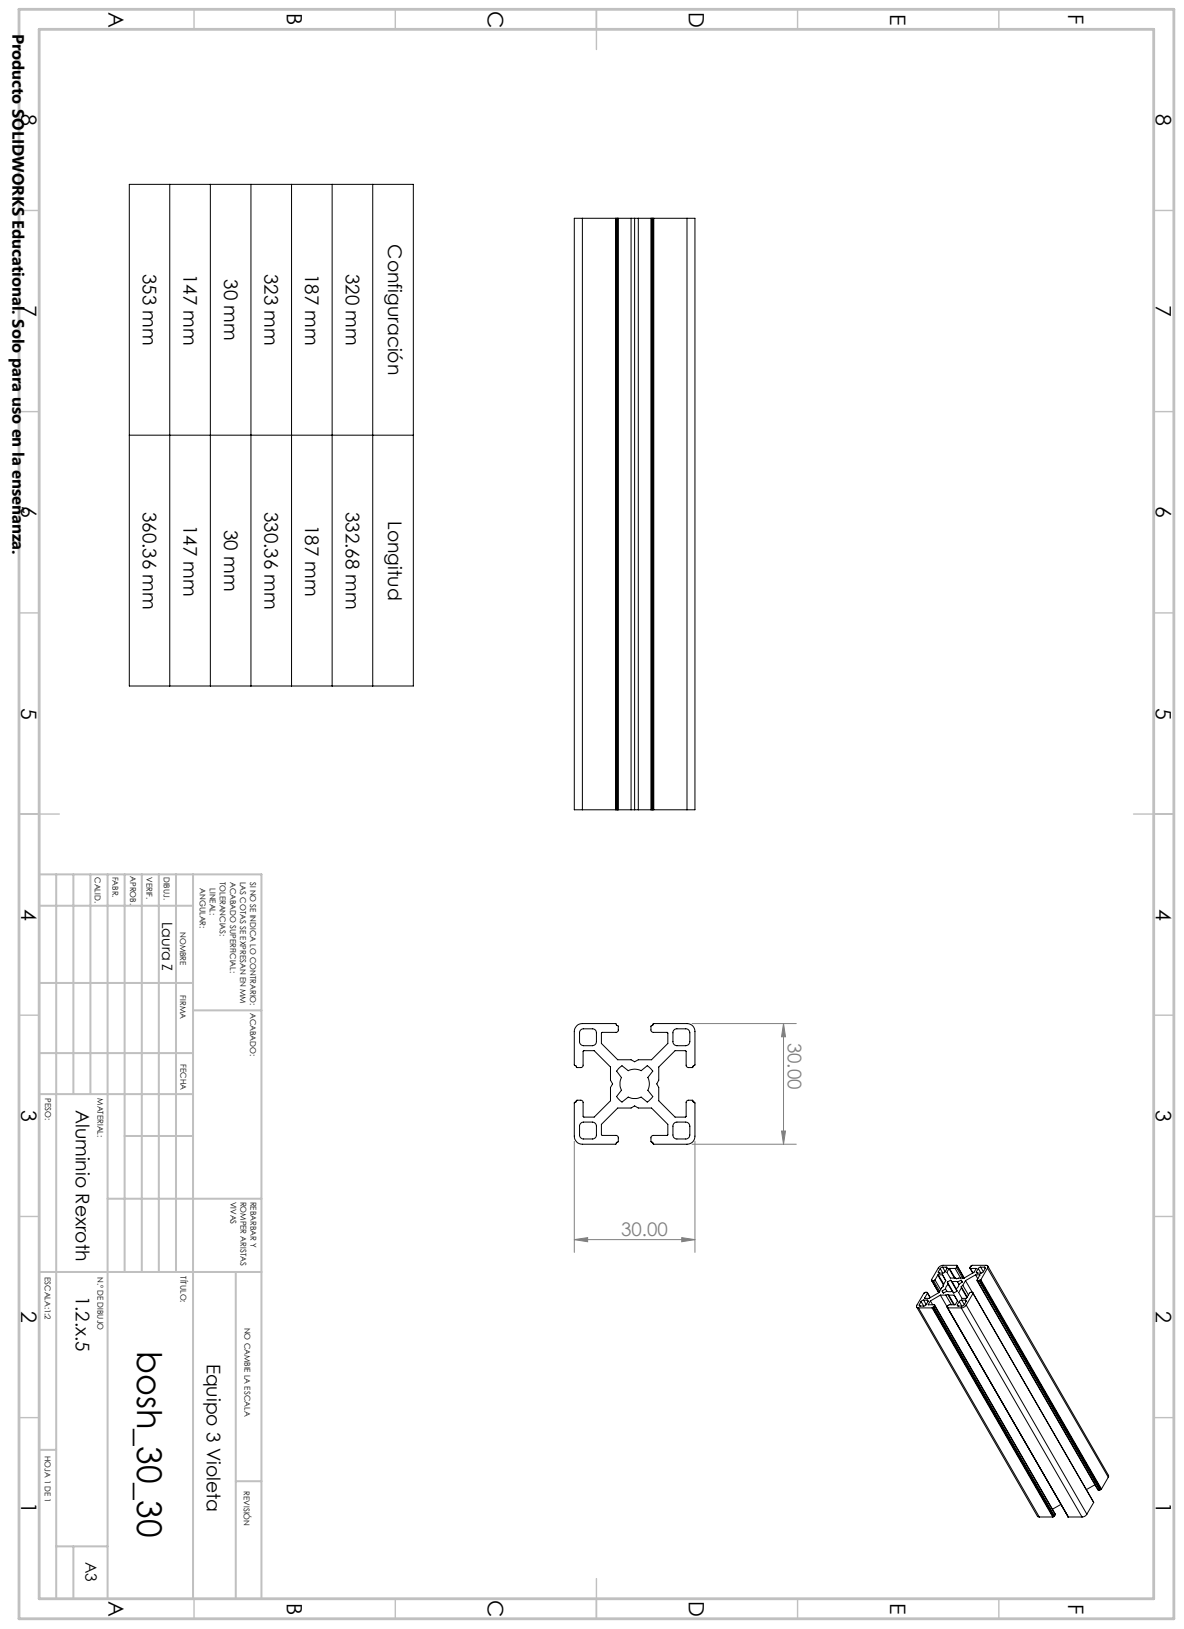
[picture p77: page 47]
Laura Z; Configuración Longitud; CALID.; FABR.; APROB.; VERIF.; DIBUJ.; ANGULAR:; LINEAL:; TOLERANCIAS:; ACABADO SUPERFICIAL:; VIVAS; ROMPER ARISTAS; REBARBAR Y; MATERIAL:; ESCALA:1:2; N.º DE DIBUJO; TÍTULO:; HOJA 1 DE 1; PESO:; bosh_30_30; Equipo 3 Violeta; 1.2.x.5 Aluminio Rexroth

Producto SOLIDWORKS Educational. Solo para uso en la enseñanza.

LAS COTAS SE EXPRESAN EN MM

SI NO SE INDICA LO CONTRARIO: ACABADO:

NOMBRE FIRMA FECHA

NO CAMBIE LA ESCALA REVISIÓN

R2.50 x 2

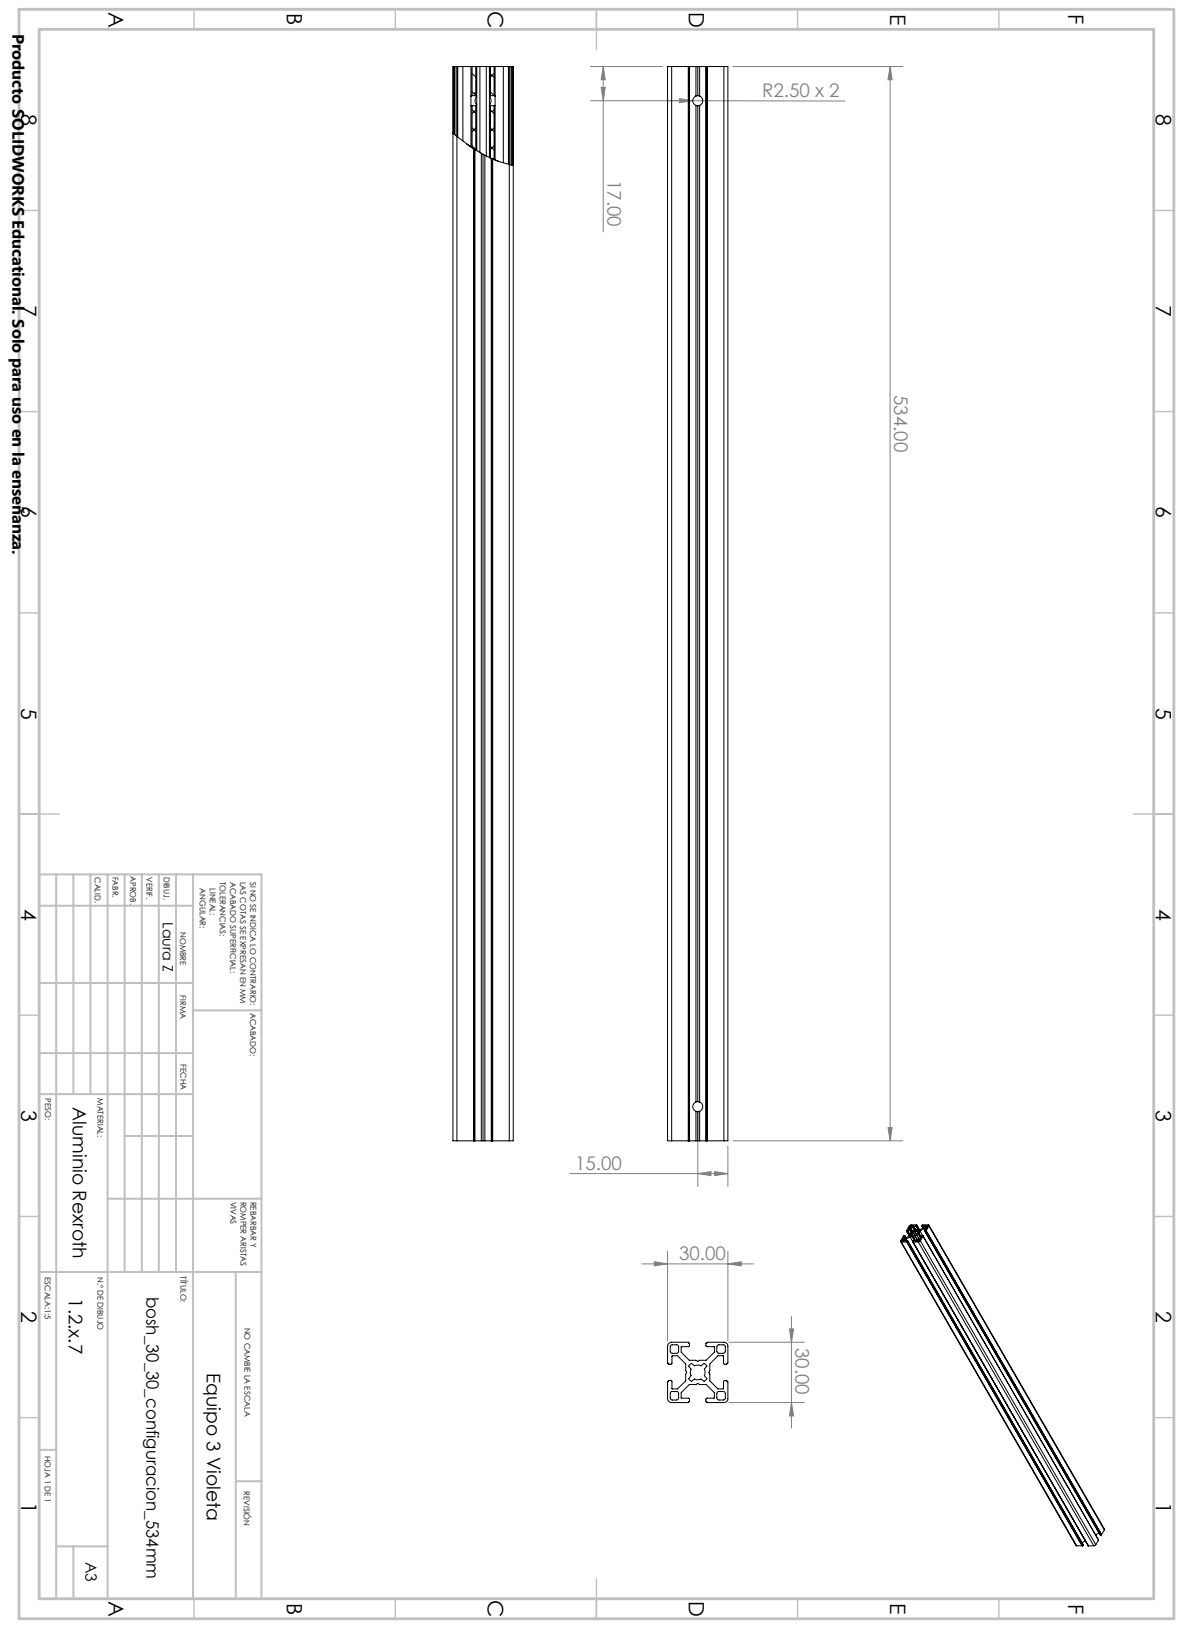
[picture p78: page 48]
Laura Z; Aluminio Rexroth; CALID.; FABR.; APROB.; VERIF.; DIBUJ.; ANGULAR:; LINEAL:; TOLERANCIAS:; ACABADO SUPERFICIAL:; VIVAS; ROMPER ARISTAS; REBARBAR Y; MATERIAL:; ESCALA:1:5; N.º DE DIBUJO; TÍTULO:; HOJA 1 DE 1; PESO:; bosh_30_30_configuracion_534mm; Equipo 3 Violeta

Producto SOLIDWORKS Educational. Solo para uso en la enseñanza.

LAS COTAS SE EXPRESAN EN MM

SI NO SE INDICA LO CONTRARIO: ACABADO:

NOMBRE FIRMA FECHA

NO CAMBIE LA ESCALA REVISIÓN

R2.50

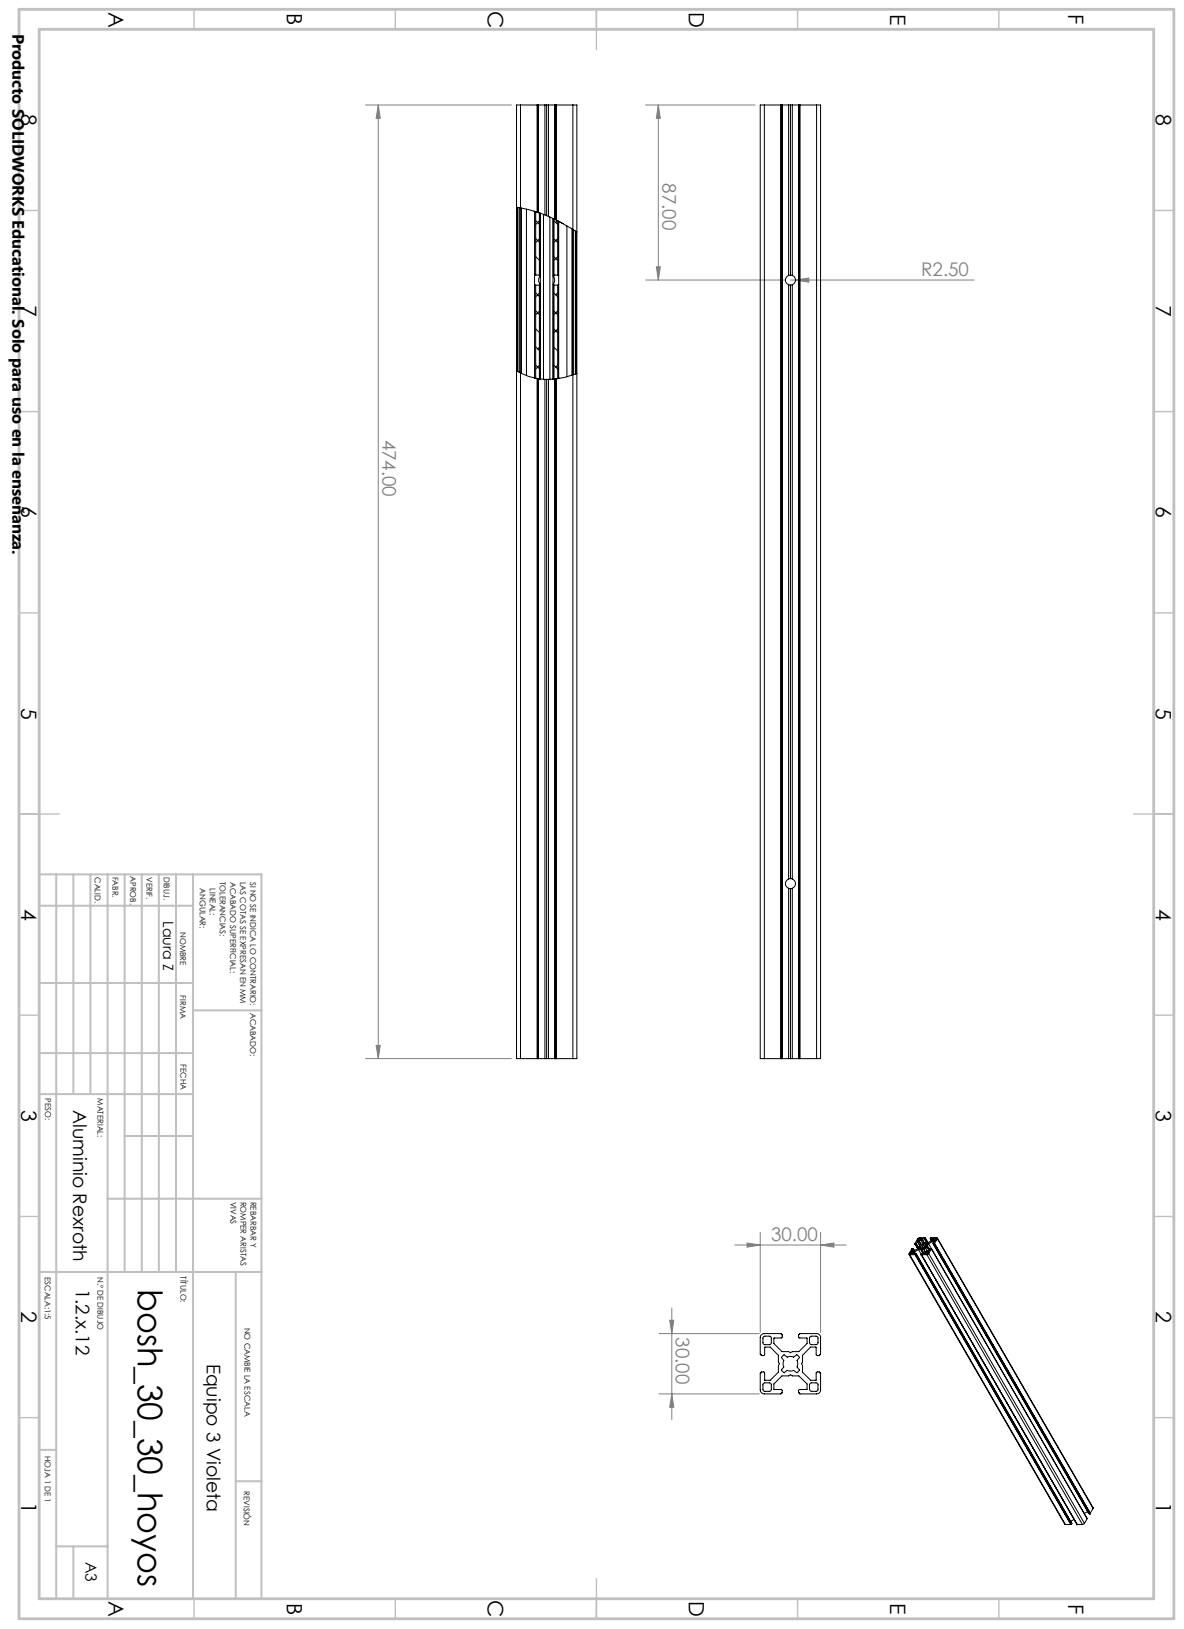
[picture p79: page 49]
Laura Z; Aluminio Rexroth; CALID.; FABR.; APROB.; VERIF.; DIBUJ.; ANGULAR:; LINEAL:; TOLERANCIAS:; ACABADO SUPERFICIAL:; VIVAS; ROMPER ARISTAS; REBARBAR Y; MATERIAL:; ESCALA:1:5; N.º DE DIBUJO; TÍTULO:; HOJA 1 DE 1; PESO:; bosh_30_30_hoyos; Equipo 3 Violeta

Producto SOLIDWORKS Educational. Solo para uso en la enseñanza.

LAS COTAS SE EXPRESAN EN MM

SI NO SE INDICA LO CONTRARIO: ACABADO:

NOMBRE FIRMA FECHA

NO CAMBIE LA ESCALA REVISIÓN

0.33
117.01

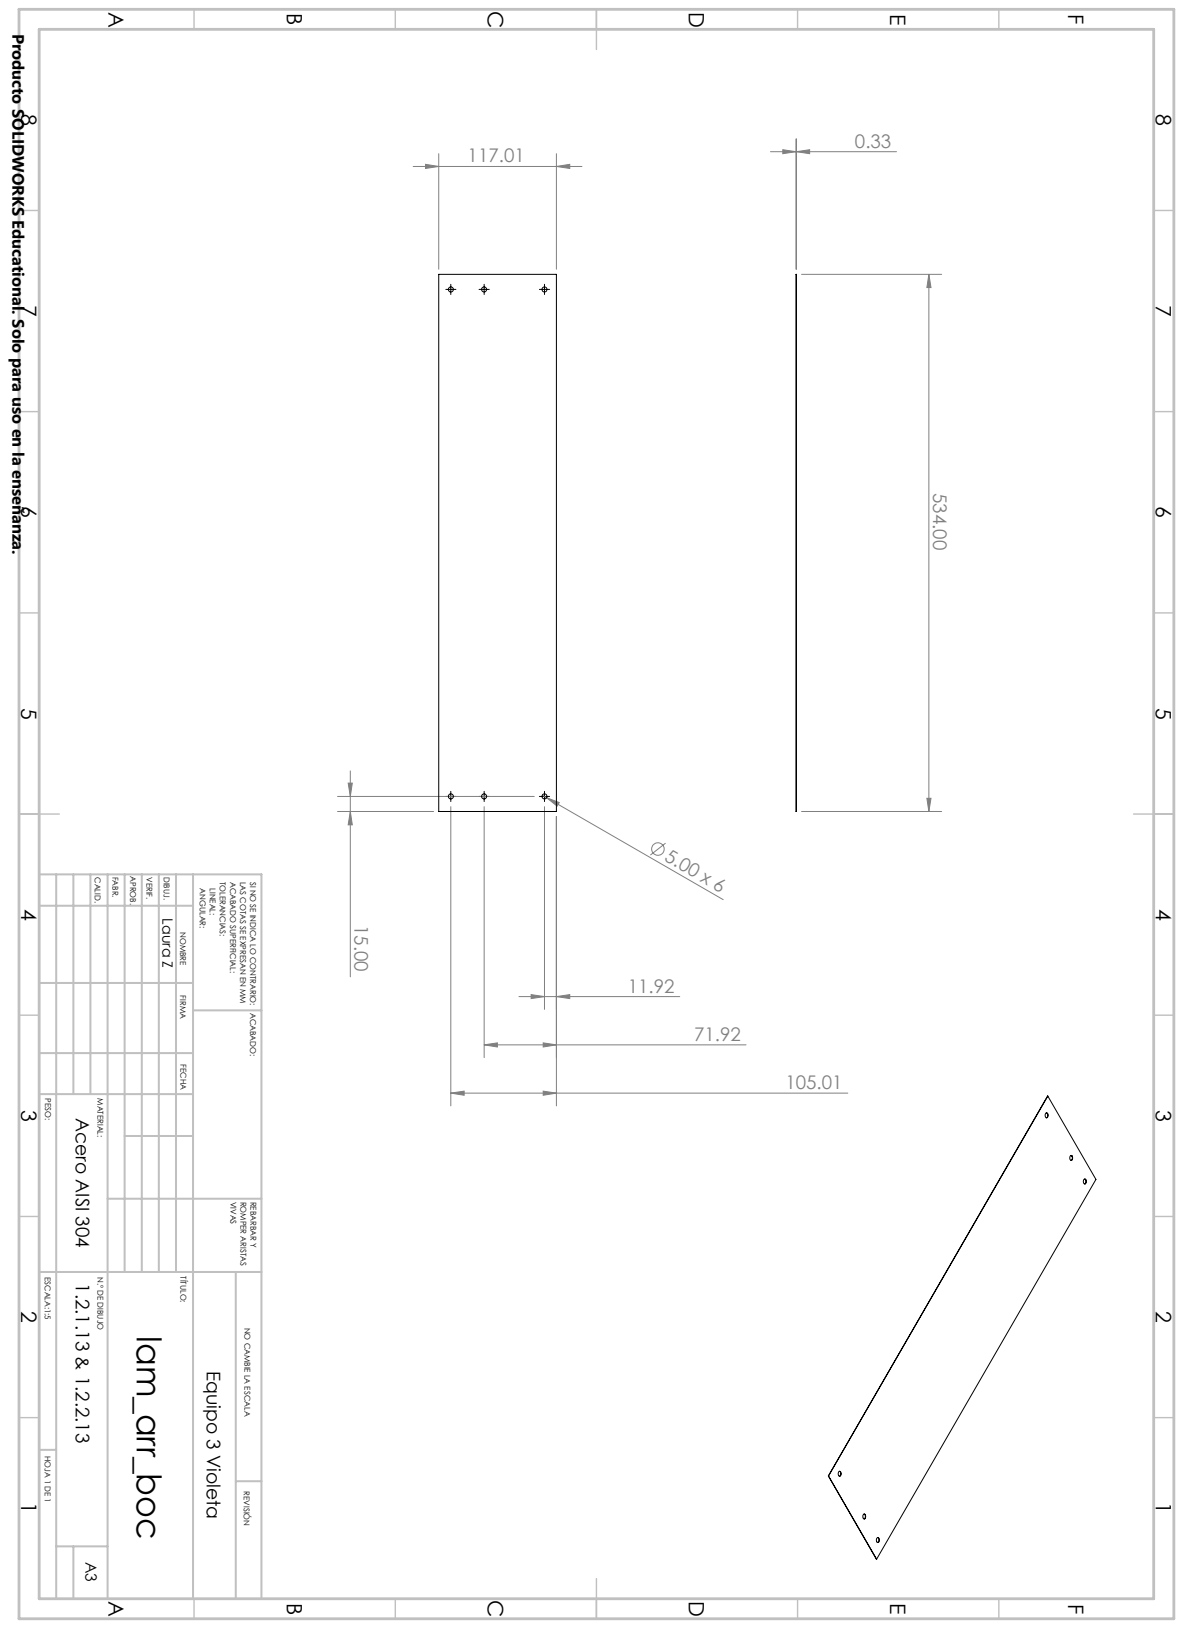
[picture p80: page 50]
Laura Z; Acero AISI 304; CALID.; FABR.; APROB.; VERIF.; DIBUJ.; ANGULAR:; LINEAL:; TOLERANCIAS:; ACABADO SUPERFICIAL:; VIVAS; ROMPER ARISTAS; REBARBAR Y; MATERIAL:; ESCALA:1:5; N.º DE DIBUJO; TÍTULO:; HOJA 1 DE 1; PESO:; lam_arr_boc; Equipo 3 Violeta

Producto SOLIDWORKS Educational. Solo para uso en la enseñanza.

LAS COTAS SE EXPRESAN EN MM

SI NO SE INDICA LO CONTRARIO: ACABADO:

NOMBRE FIRMA FECHA

NO CAMBIE LA ESCALA REVISIÓN

0.33

16.59

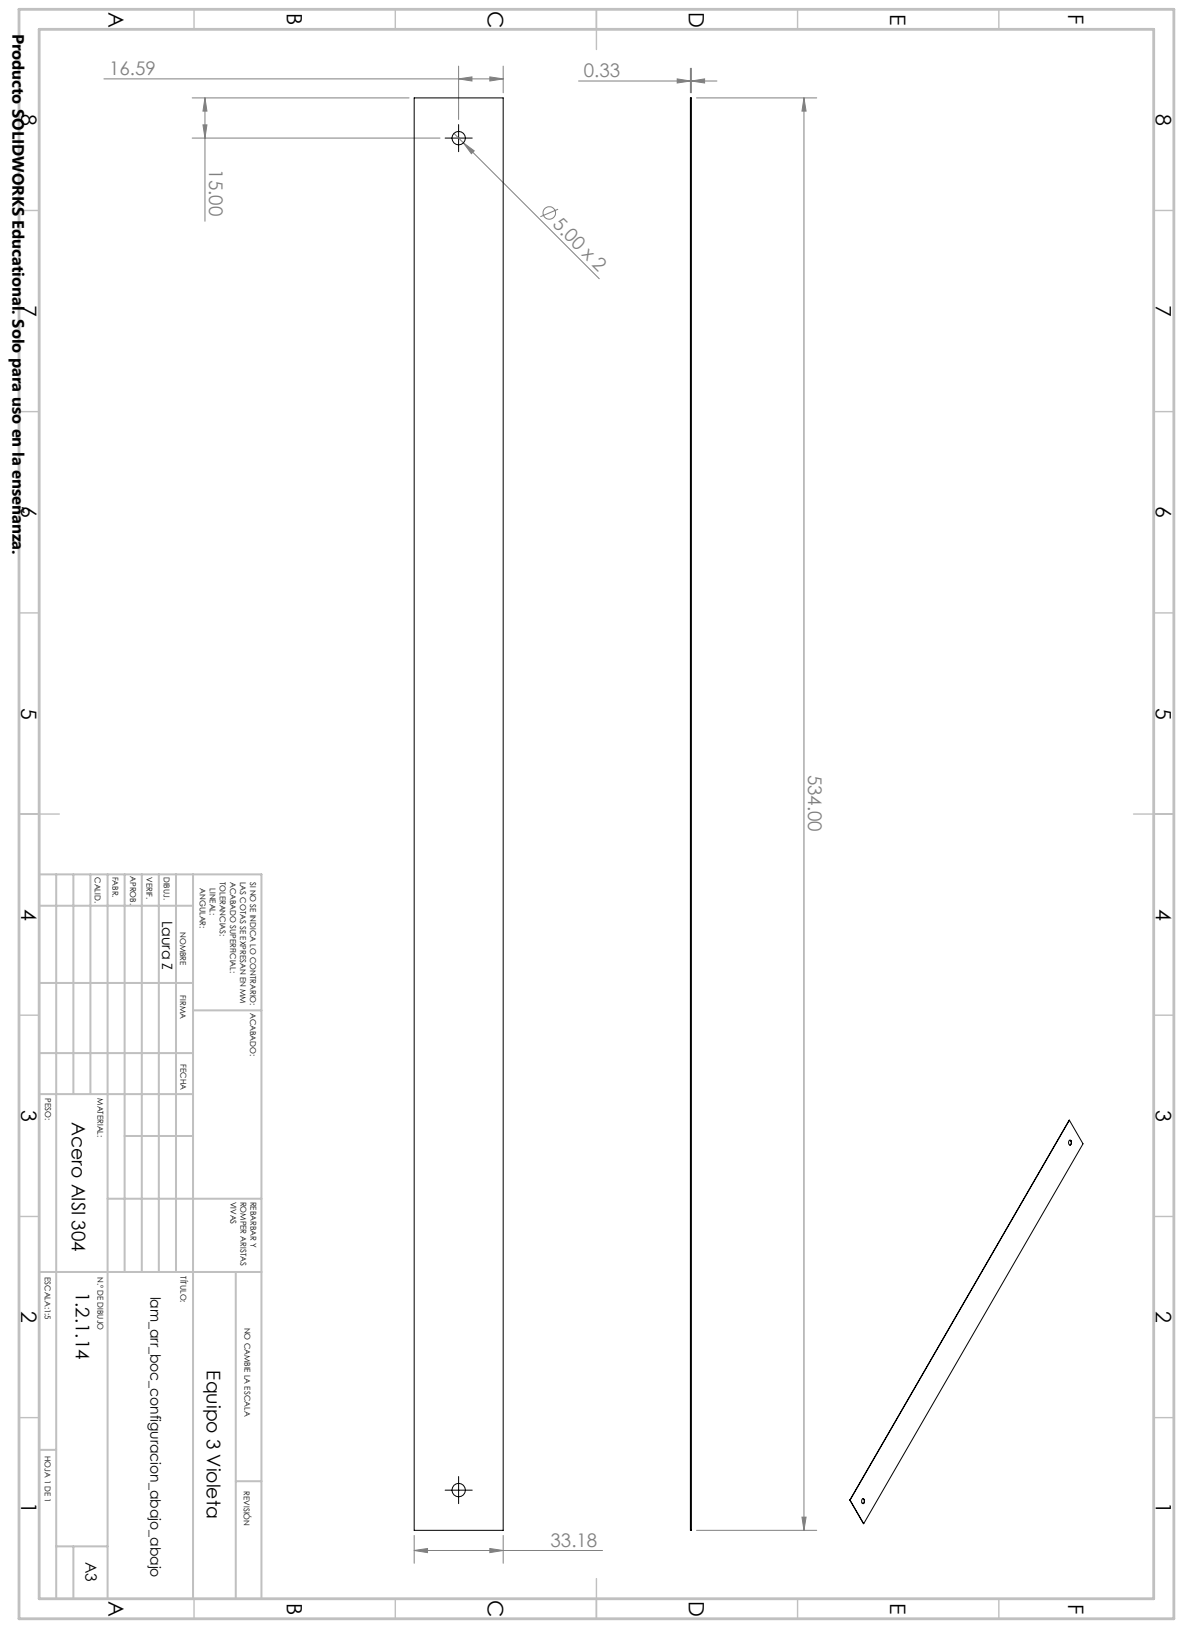
[picture p81: page 51]
Laura Z; Acero AISI 304; CALID.; FABR.; APROB.; VERIF.; DIBUJ.; ANGULAR:; LINEAL:; TOLERANCIAS:; ACABADO SUPERFICIAL:; VIVAS; ROMPER ARISTAS; REBARBAR Y; MATERIAL:; ESCALA:1:5; N.º DE DIBUJO; TÍTULO:; HOJA 1 DE 1; PESO:; lam_arr_boc_configuracion_abajo_abajo; Equipo 3 Violeta

Producto SOLIDWORKS Educational. Solo para uso en la enseñanza.

LAS COTAS SE EXPRESAN EN MM

SI NO SE INDICA LO CONTRARIO: ACABADO:

NOMBRE FIRMA FECHA

NO CAMBIE LA ESCALA REVISIÓN

0.33

83.83

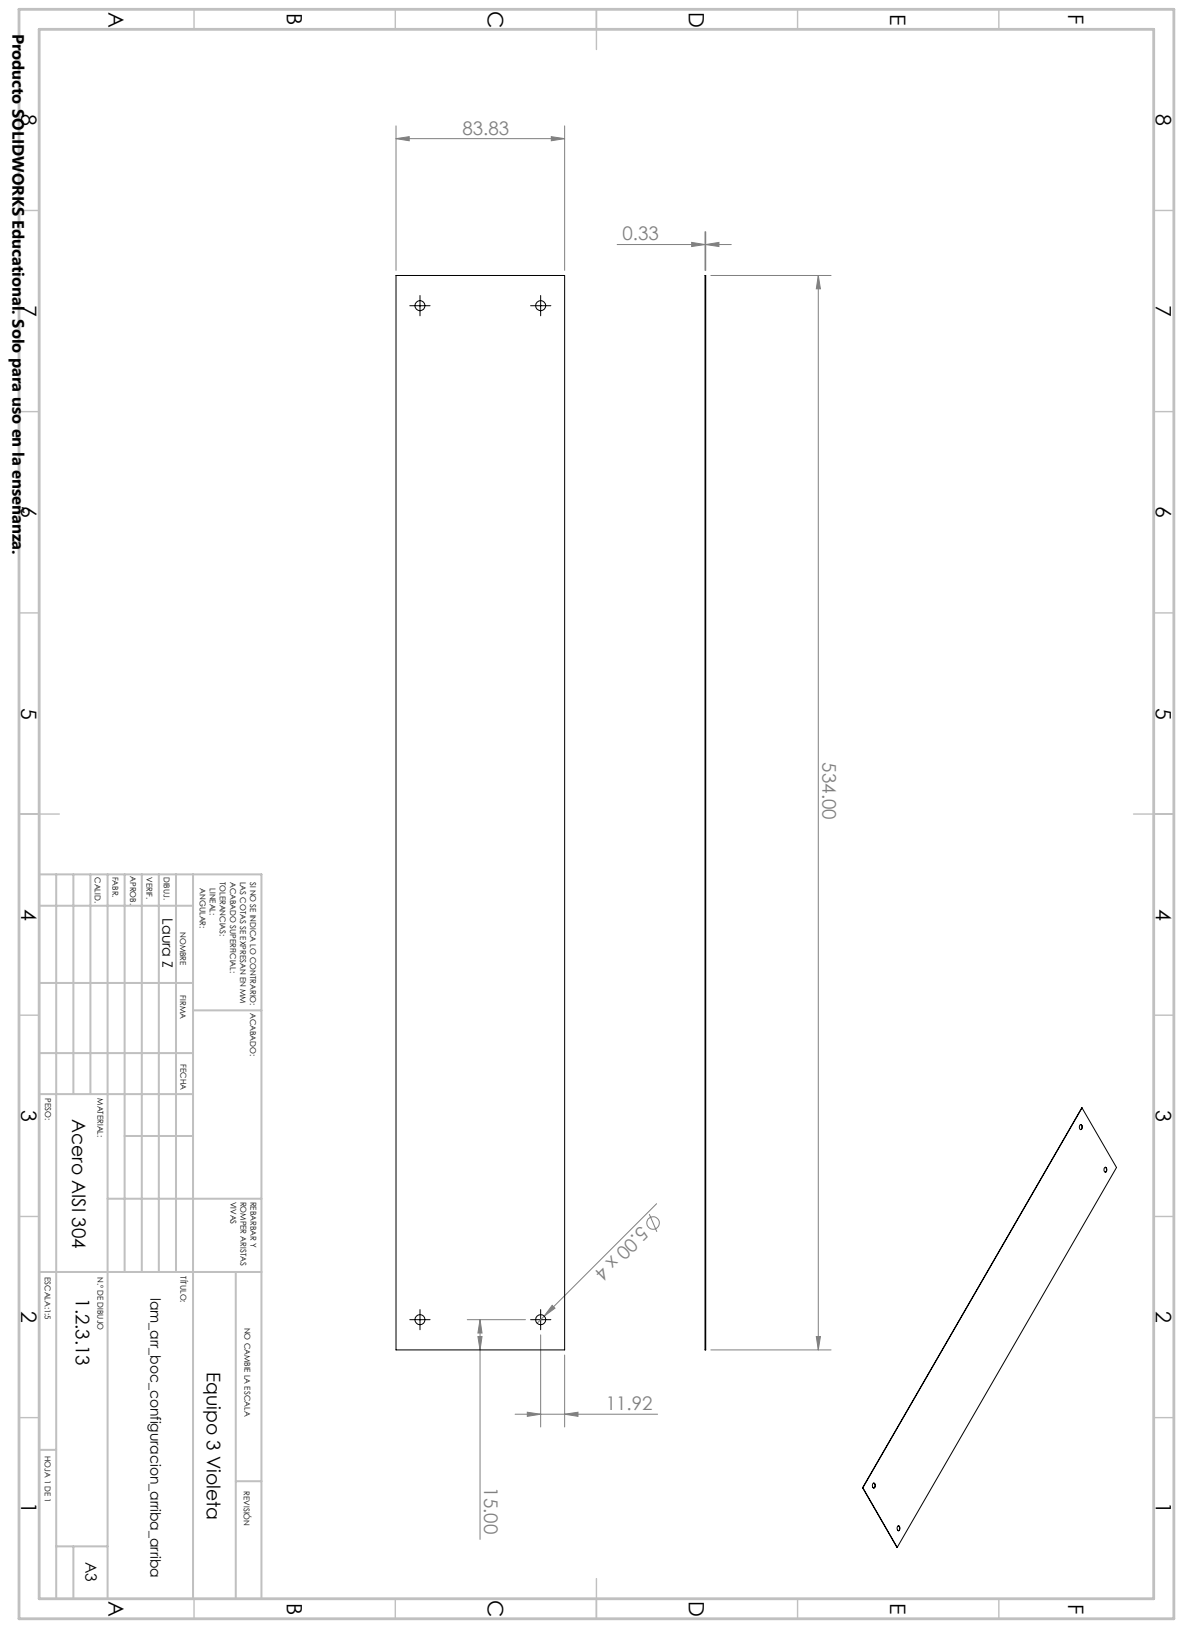
[picture p82: page 52]
Laura Z; Acero AISI 304; CALID.; FABR.; APROB.; VERIF.; DIBUJ.; ANGULAR:; LINEAL:; TOLERANCIAS:; ACABADO SUPERFICIAL:; VIVAS; ROMPER ARISTAS; REBARBAR Y; MATERIAL:; ESCALA:1:5; N.º DE DIBUJO; TÍTULO:; HOJA 1 DE 1; PESO:; lam_arr_boc_configuracion_arriba_arriba; Equipo 3 Violeta

Producto SOLIDWORKS Educational. Solo para uso en la enseñanza.

LAS COTAS SE EXPRESAN EN MM

SI NO SE INDICA LO CONTRARIO: ACABADO:

NOMBRE FIRMA FECHA

NO CAMBIE LA ESCALA REVISIÓN

647.83

232.00

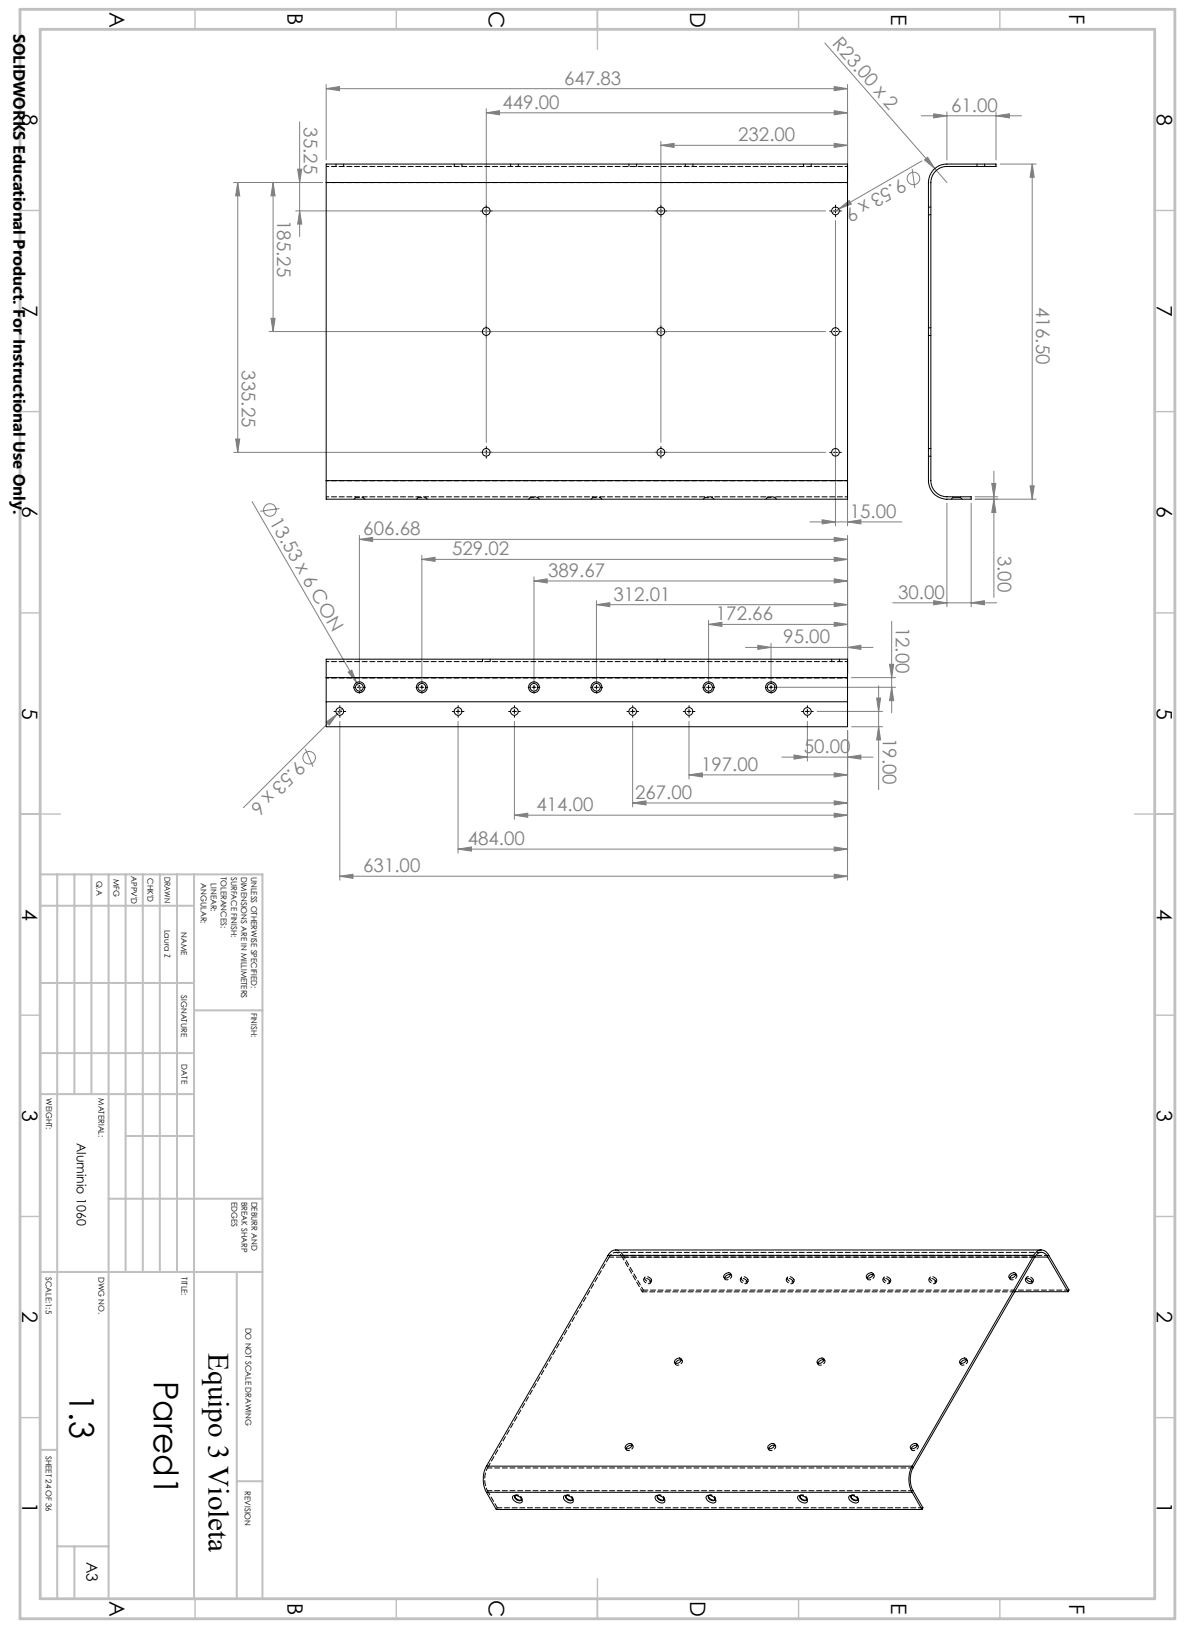
[picture p83: page 53]
13.53 x 6 CON; MFG; APPV'D; CHK'D; DRAWN; ANGULAR:; LINEAR:; TOLERANCES:; SURFACE FINISH:; EDGES BREAK SHARP; DEBURR AND; MATERIAL:; SCALE:1:5; DWG NO.; TITLE:; SHEET 24 OF 36; A3 Aluminio 1060; WEIGHT:; Laura Z; Equipo 3 Violeta; Pared1

SOLIDWORKS Educational Product. For Instructional Use Only.

DIMENSIONS ARE IN MILLIMETERS

UNLESS OTHERWISE SPECIFIED: FINISH:

NAME SIGNATURE DATE

DO NOT SCALE DRAWING REVISION

198.83

415.83

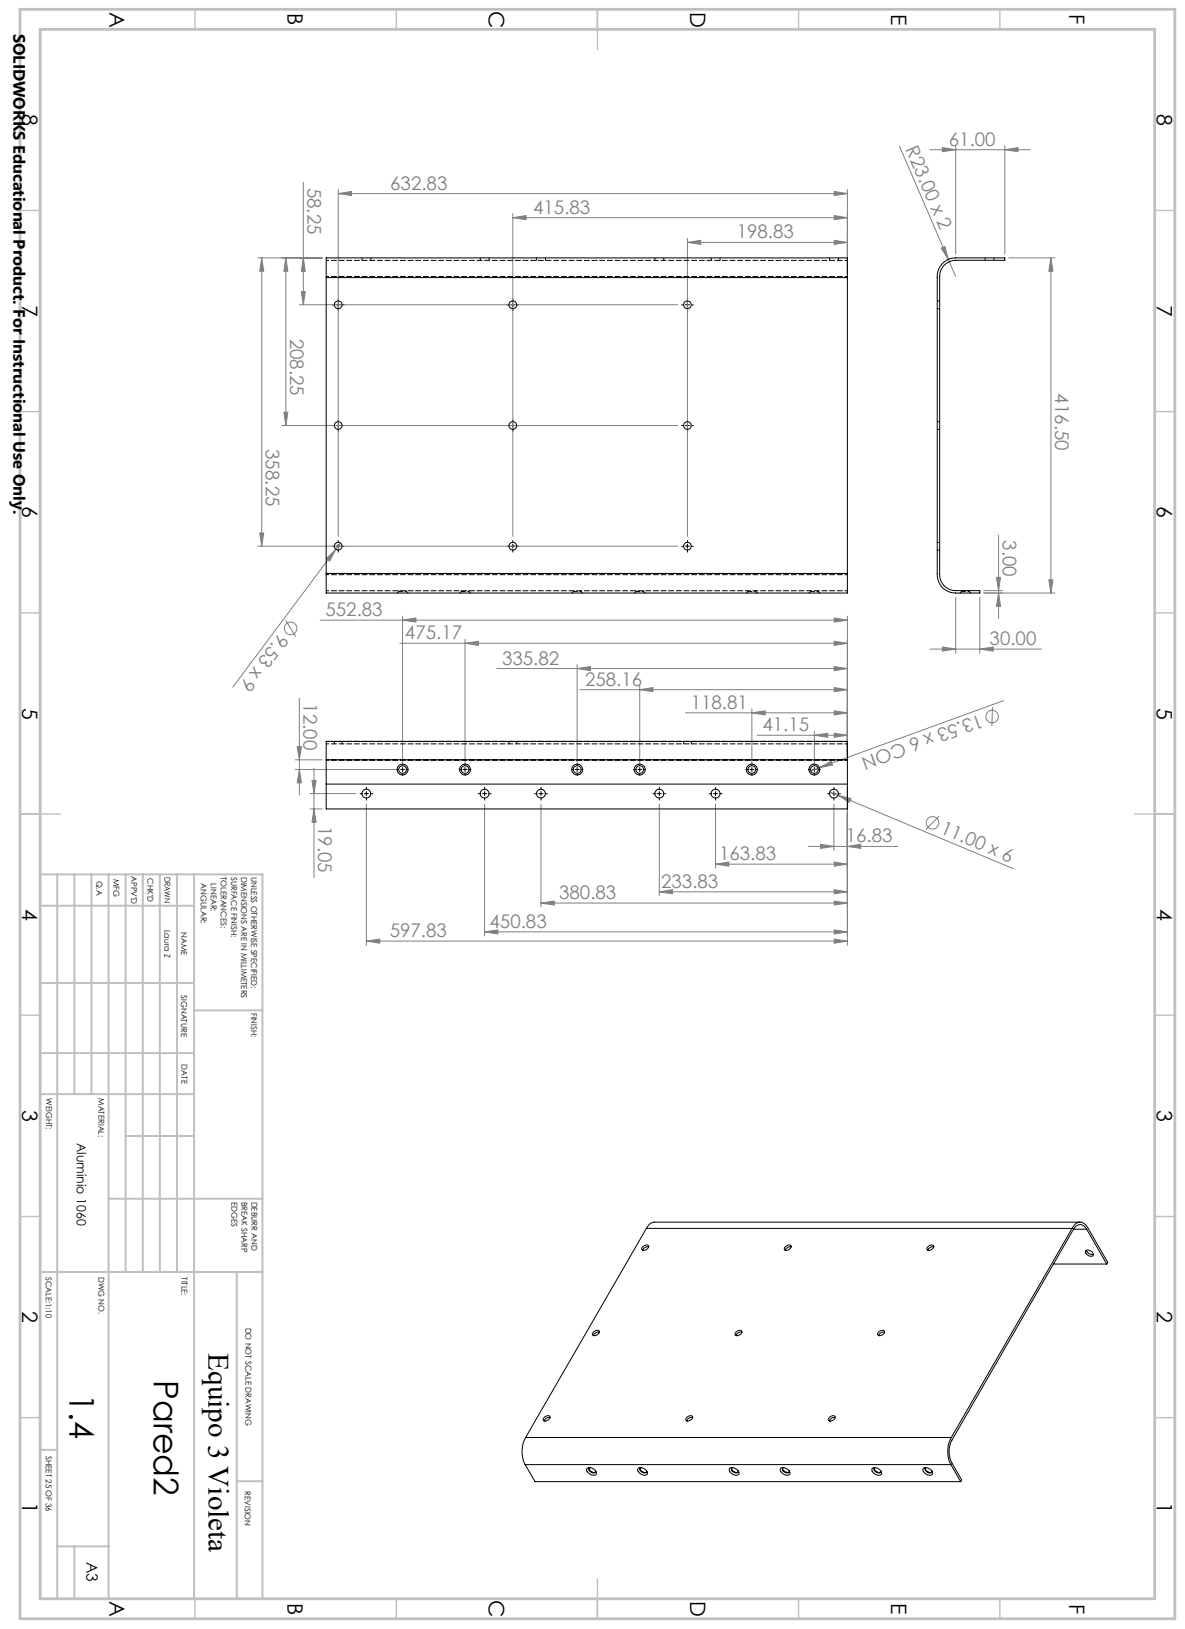
[picture p84: page 54]
MFG; APPV'D; CHK'D; DRAWN; ANGULAR:; LINEAR:; TOLERANCES:; SURFACE FINISH:; EDGES BREAK SHARP; DEBURR AND; MATERIAL:; SCALE:1:10; DWG NO.; TITLE:; SHEET 25 OF 36; A3 Aluminio 1060; WEIGHT:; Laura Z; Equipo 3 Violeta; Pared2

SOLIDWORKS Educational Product. For Instructional Use Only.

DIMENSIONS ARE IN MILLIMETERS

UNLESS OTHERWISE SPECIFIED: FINISH:

NAME SIGNATURE DATE

DO NOT SCALE DRAWING REVISION

20.00

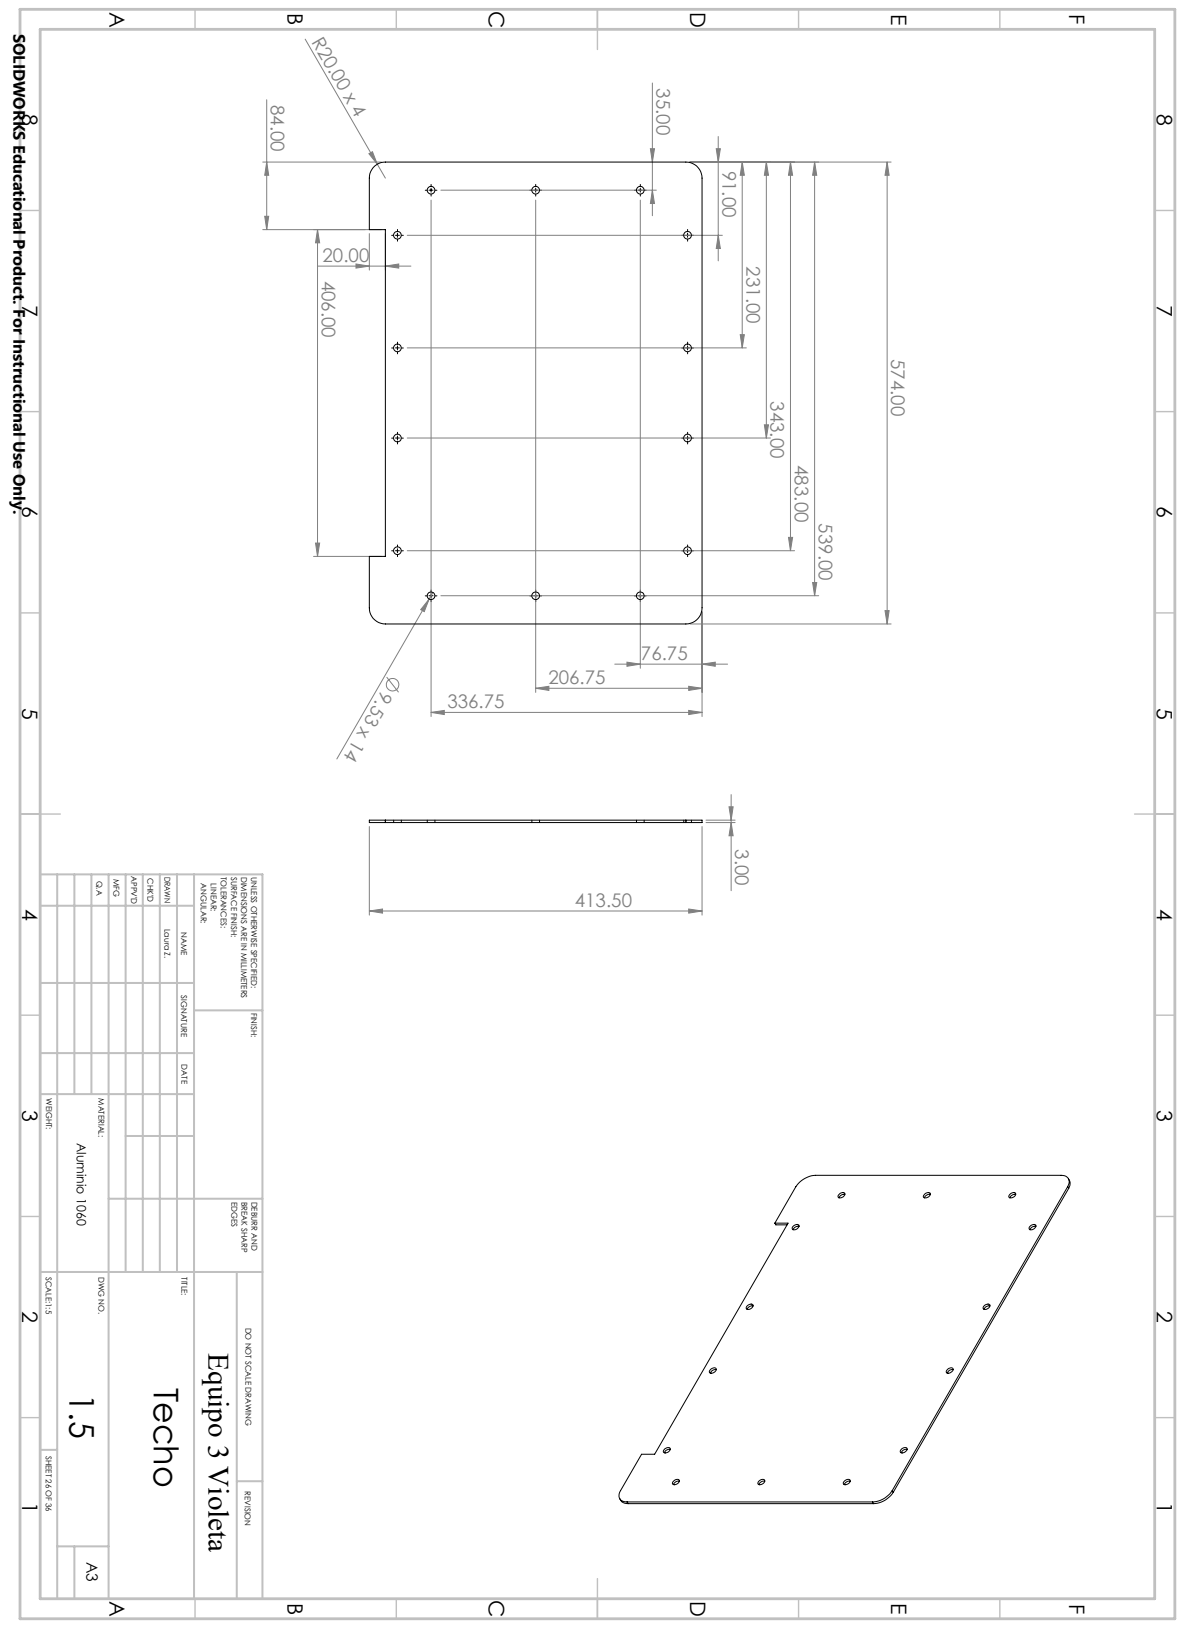
[picture p85: page 55]
MFG; APPV'D; CHK'D; DRAWN; ANGULAR:; LINEAR:; TOLERANCES:; SURFACE FINISH:; EDGES BREAK SHARP; DEBURR AND; MATERIAL:; SCALE:1:5; DWG NO.; TITLE:; SHEET 26 OF 36; A3 Aluminio 1060; WEIGHT:; Laura Z.; Equipo 3 Violeta; Techo

SOLIDWORKS Educational Product. For Instructional Use Only.

DIMENSIONS ARE IN MILLIMETERS

UNLESS OTHERWISE SPECIFIED: FINISH:

NAME SIGNATURE DATE

DO NOT SCALE DRAWING REVISION

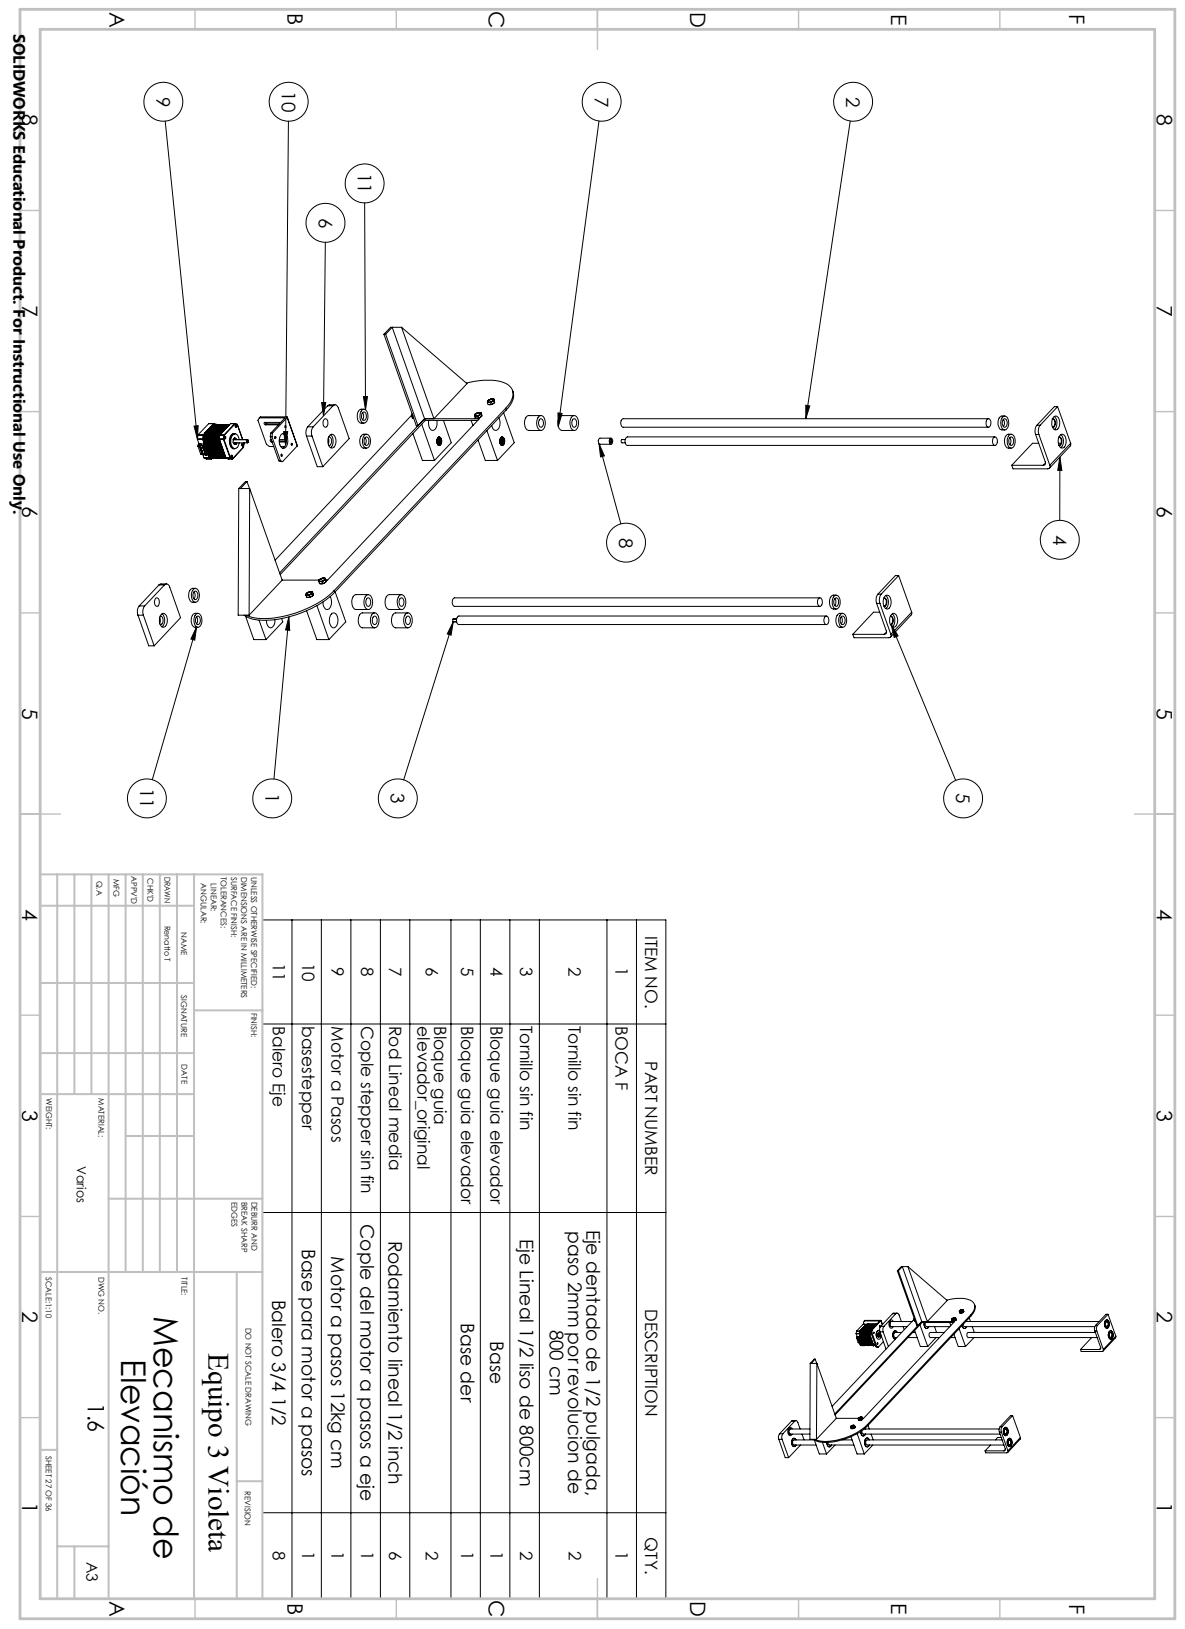
[picture p86: page 56]
1 BOCA F 1; 6 elevador_original; Bloque guia 2; MFG; APPV'D; CHK'D; DRAWN; ANGULAR:; LINEAR:; TOLERANCES:; SURFACE FINISH:; EDGES BREAK SHARP; DEBURR AND; MATERIAL:; SCALE:1:10; DWG NO.; TITLE:; SHEET 27 OF 36; A3 Varios; WEIGHT:; Renatto T; Equipo 3 Violeta; Mecanismo de Elevación

SOLIDWORKS Educational Product. For Instructional Use Only.

DIMENSIONS ARE IN MILLIMETERS

UNLESS OTHERWISE SPECIFIED: FINISH:

NAME SIGNATURE DATE

ITEM NO. PART NUMBER DESCRIPTION QTY.

11 Balero Eje Balero 3/4 1/2 8

10 basestepper Base para motor a pasos 1

9 Motor a Pasos Motor a pasos 12kg cm 1

8 Cople stepper sin fin Cople del motor a pasos a eje 1

7 Rod Lineal media Rodamiento lineal 1/2 inch 6

5 Bloque guia elevador Base der 1

4 Bloque guia elevador Base 1

3 Tornillo sin fin Eje Lineal 1/2 liso de 800cm 2

2 Tornillo sin fin paso 2mm por revolucion de

Eje dentado de 1/2 pulgada,

DO NOT SCALE DRAWING REVISION

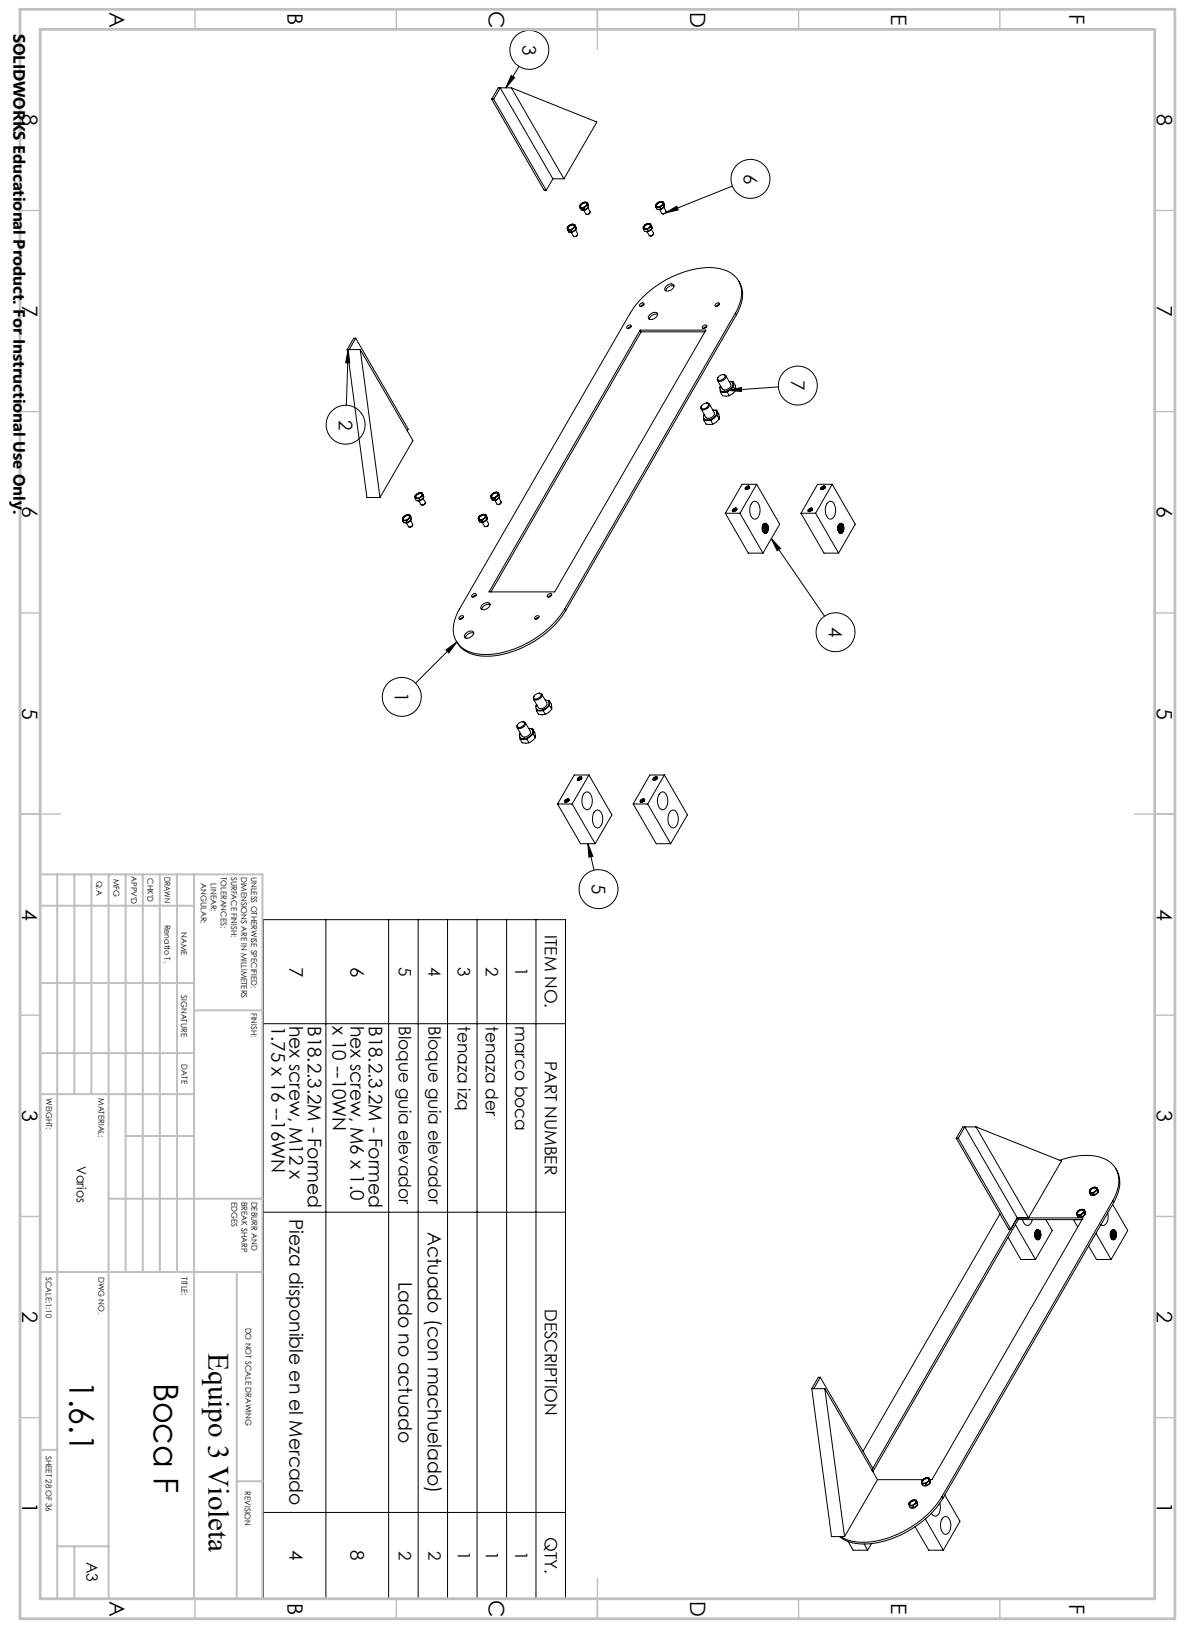
[picture p87: page 57]
1 marco boca 1; 2 tenaza der 1; 3 tenaza izq 1; x 10 --10WN hex screw, M6 x 1.0; B18.2.3.2M - Formed; hex screw, M12 x B18.2.3.2M - Formed; MFG; APPV'D; CHK'D; DRAWN; ANGULAR:; LINEAR:; TOLERANCES:; SURFACE FINISH:; EDGES BREAK SHARP; DEBURR AND; MATERIAL:; SCALE:1:10; DWG NO.; TITLE:; SHEET 28 OF 36; A3 Varios; WEIGHT:; Renatto T.; Equipo 3 Violeta; Boca F

SOLIDWORKS Educational Product. For Instructional Use Only.

DIMENSIONS ARE IN MILLIMETERS

UNLESS OTHERWISE SPECIFIED: FINISH:

NAME SIGNATURE DATE

ITEM NO. PART NUMBER DESCRIPTION QTY.

5 Bloque guia elevador Lado no actuado 2

4 Bloque guia elevador Actuado (con machuelado) 2

Pieza disponible en el Mercado 4

DO NOT SCALE DRAWING REVISION

100.00
115.00

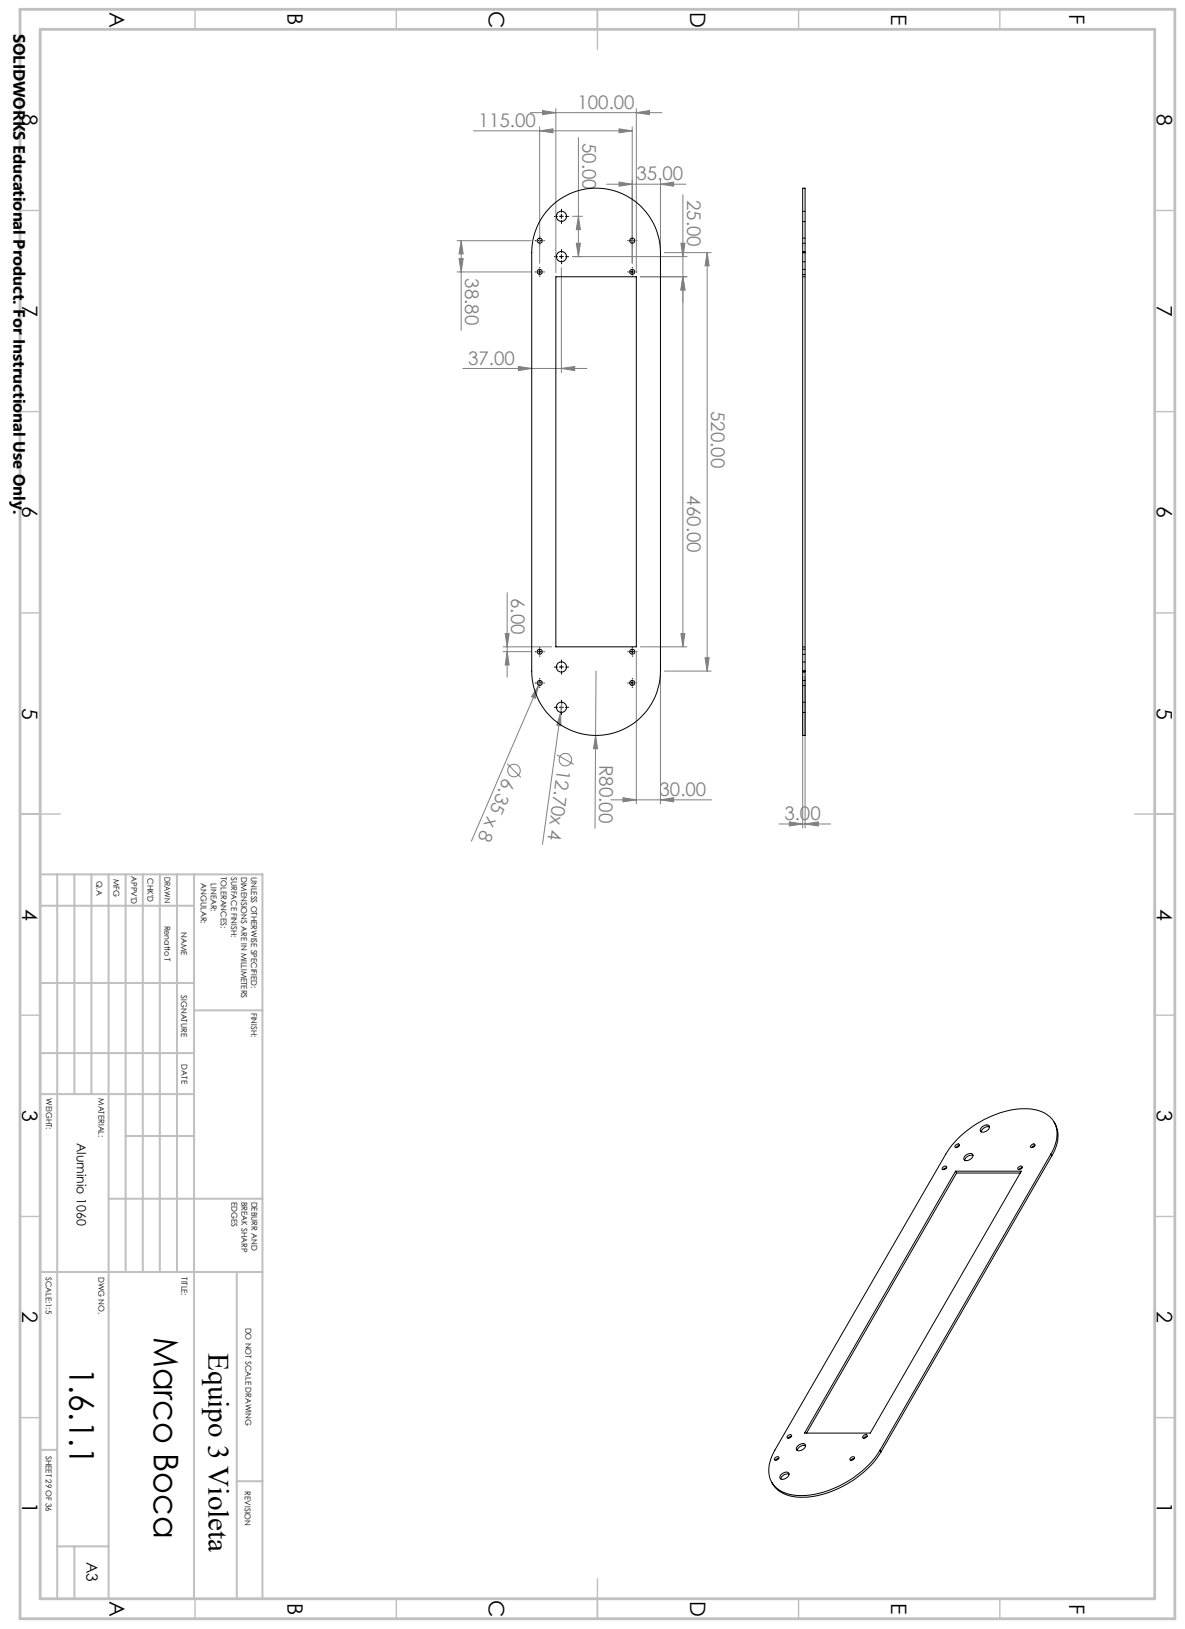
[picture p88: page 58]
MFG; APPV'D; CHK'D; DRAWN; ANGULAR:; LINEAR:; TOLERANCES:; SURFACE FINISH:; EDGES BREAK SHARP; DEBURR AND; MATERIAL:; SCALE:1:5; DWG NO.; TITLE:; SHEET 29 OF 36; A3 Aluminio 1060; WEIGHT:; Renatto T; Equipo 3 Violeta; Marco Boca

SOLIDWORKS Educational Product. For Instructional Use Only.

DIMENSIONS ARE IN MILLIMETERS

UNLESS OTHERWISE SPECIFIED: FINISH:

NAME SIGNATURE DATE

DO NOT SCALE DRAWING REVISION

10.00

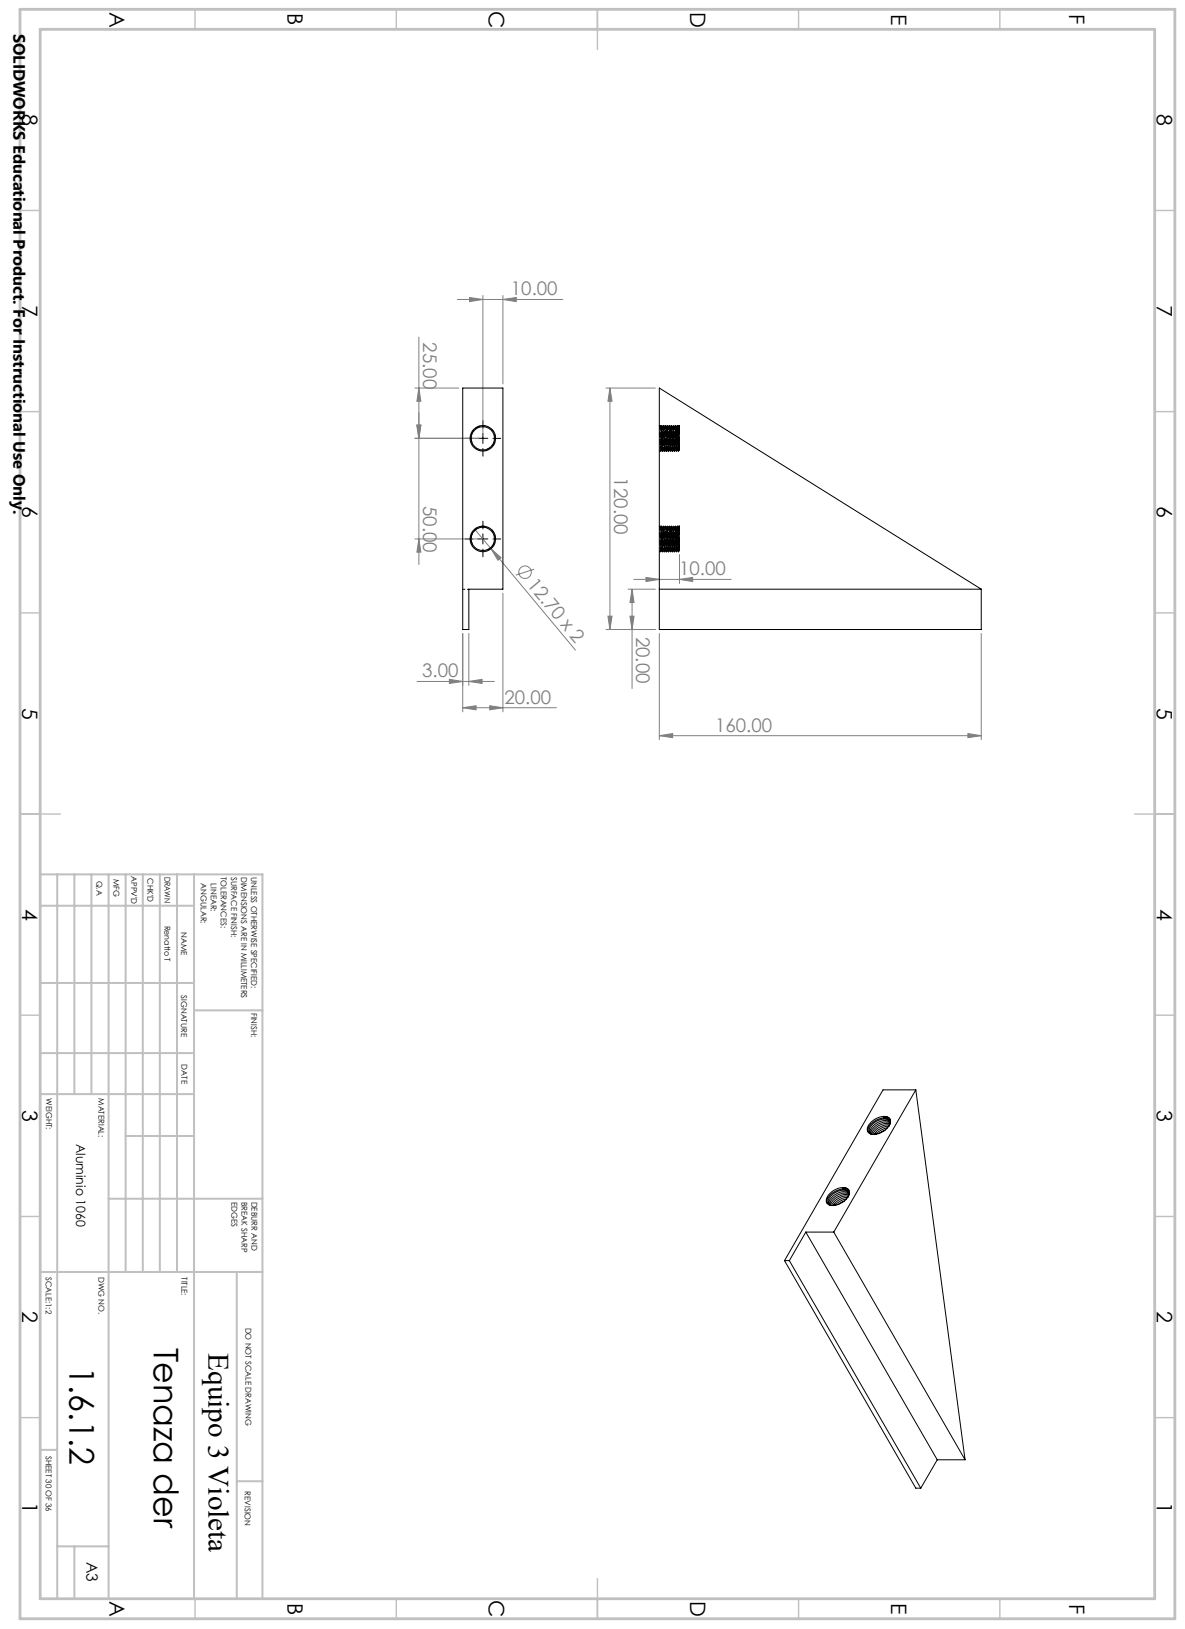
[picture p89: page 59]
MFG; APPV'D; CHK'D; DRAWN; ANGULAR:; LINEAR:; TOLERANCES:; SURFACE FINISH:; EDGES BREAK SHARP; DEBURR AND; MATERIAL:; SCALE:1:2; DWG NO.; TITLE:; SHEET 30 OF 36; Aluminio 1060; WEIGHT:; Renatto T; Equipo 3 Violeta; Tenaza der

SOLIDWORKS Educational Product. For Instructional Use Only.

DIMENSIONS ARE IN MILLIMETERS

UNLESS OTHERWISE SPECIFIED: FINISH:

NAME SIGNATURE DATE

DO NOT SCALE DRAWING REVISION

3.00

160.00

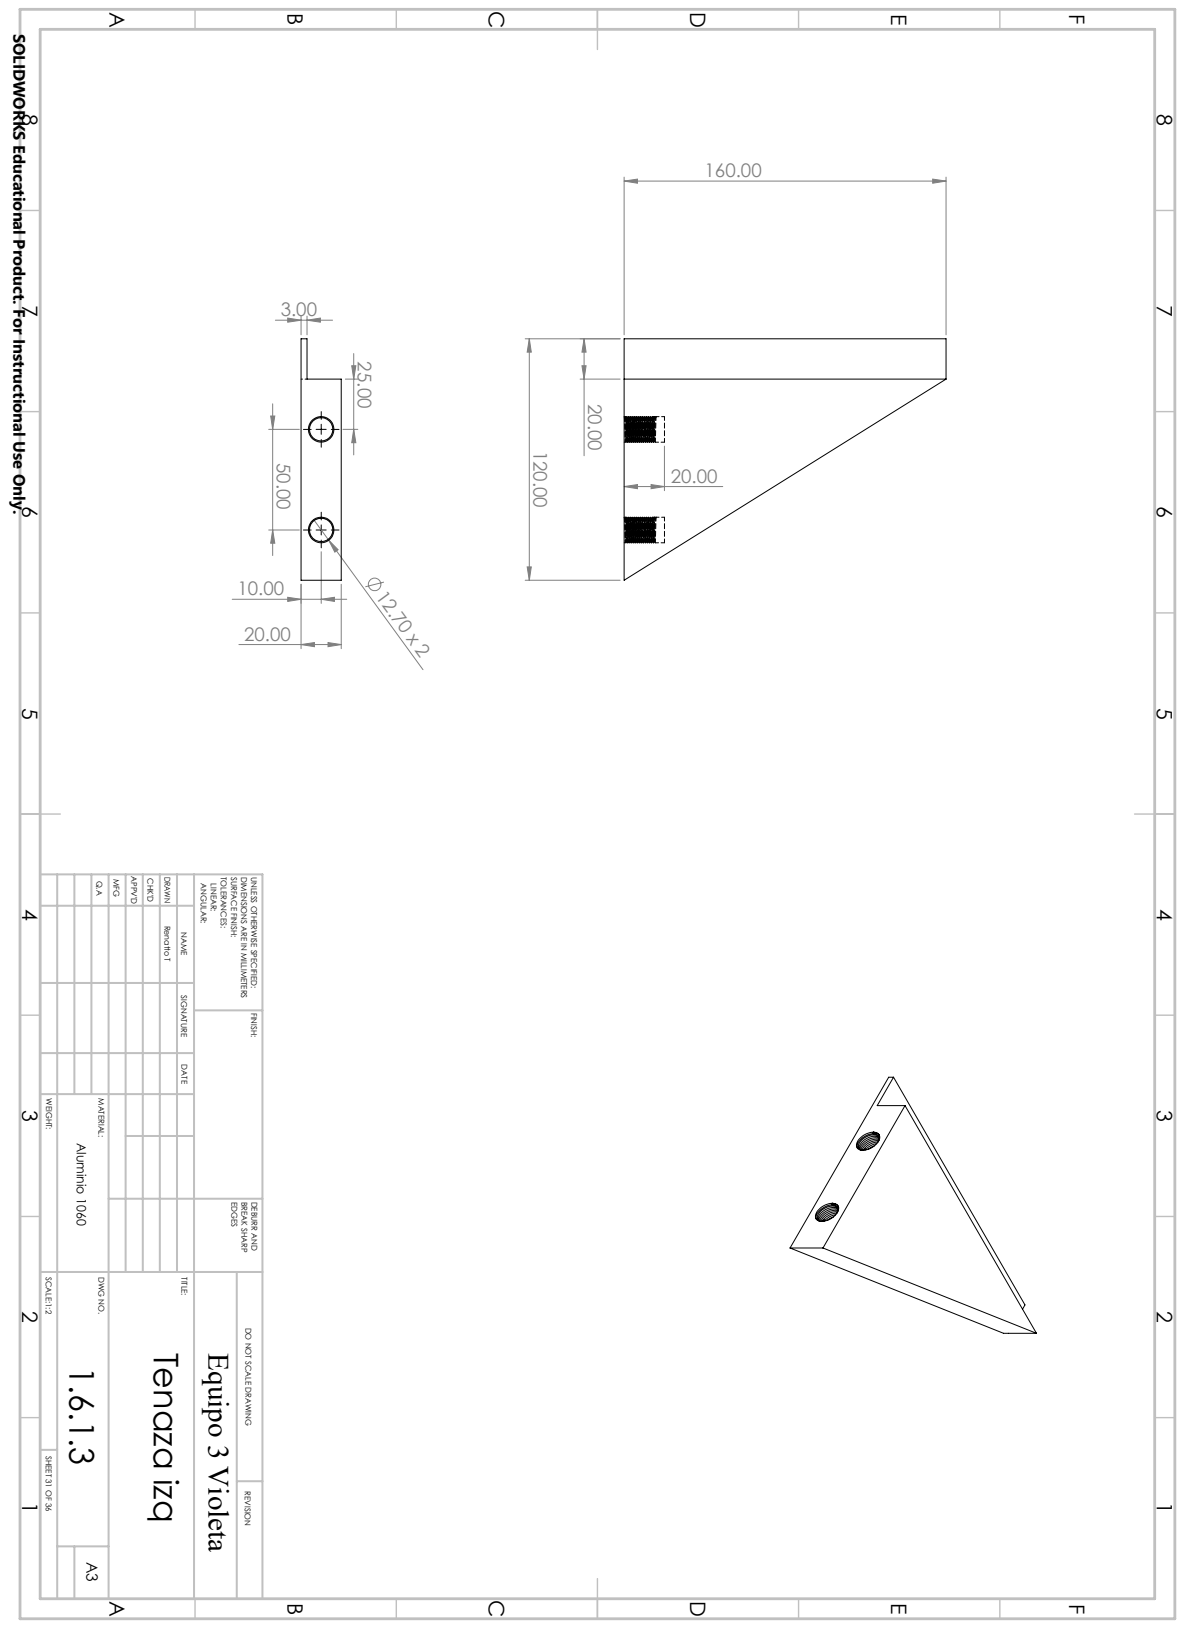
[picture p90: page 60]
MFG; APPV'D; CHK'D; DRAWN; ANGULAR:; LINEAR:; TOLERANCES:; SURFACE FINISH:; EDGES BREAK SHARP; DEBURR AND; MATERIAL:; SCALE:1:2; DWG NO.; TITLE:; SHEET 31 OF 36; A3 Aluminio 1060; WEIGHT:; Renatto T; Equipo 3 Violeta; Tenaza izq

SOLIDWORKS Educational Product. For Instructional Use Only.

DIMENSIONS ARE IN MILLIMETERS

UNLESS OTHERWISE SPECIFIED: FINISH:

NAME SIGNATURE DATE

DO NOT SCALE DRAWING REVISION

22.23
20.00

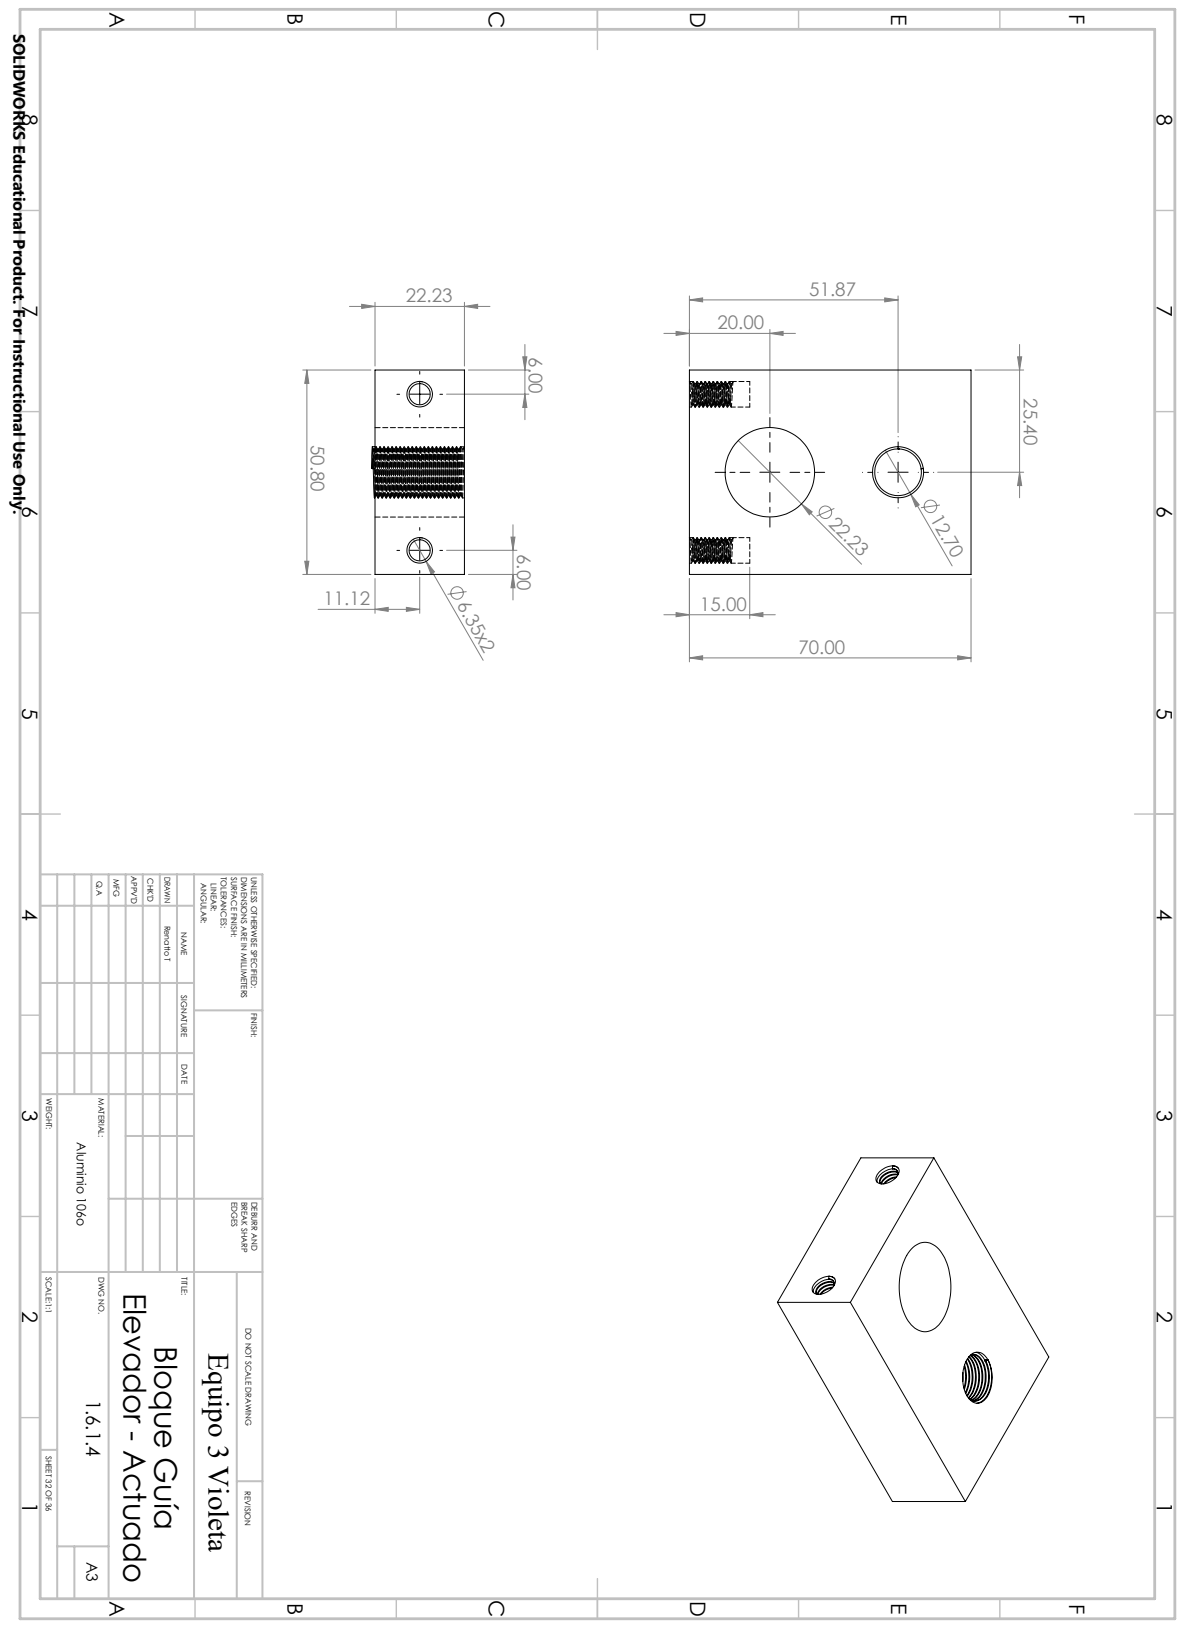
[picture p91: page 61]
MFG; APPV'D; CHK'D; DRAWN; ANGULAR:; LINEAR:; TOLERANCES:; SURFACE FINISH:; EDGES BREAK SHARP; DEBURR AND; MATERIAL:; SCALE:1:1; DWG NO.; TITLE:; SHEET 32 OF 36; A3 Aluminio 106o; WEIGHT:; Renatto T; Equipo 3 Violeta; Bloque Guía; Elevador - Actuado

SOLIDWORKS Educational Product. For Instructional Use Only.

DIMENSIONS ARE IN MILLIMETERS

UNLESS OTHERWISE SPECIFIED: FINISH:

NAME SIGNATURE DATE

DO NOT SCALE DRAWING REVISION

11.12
15.00

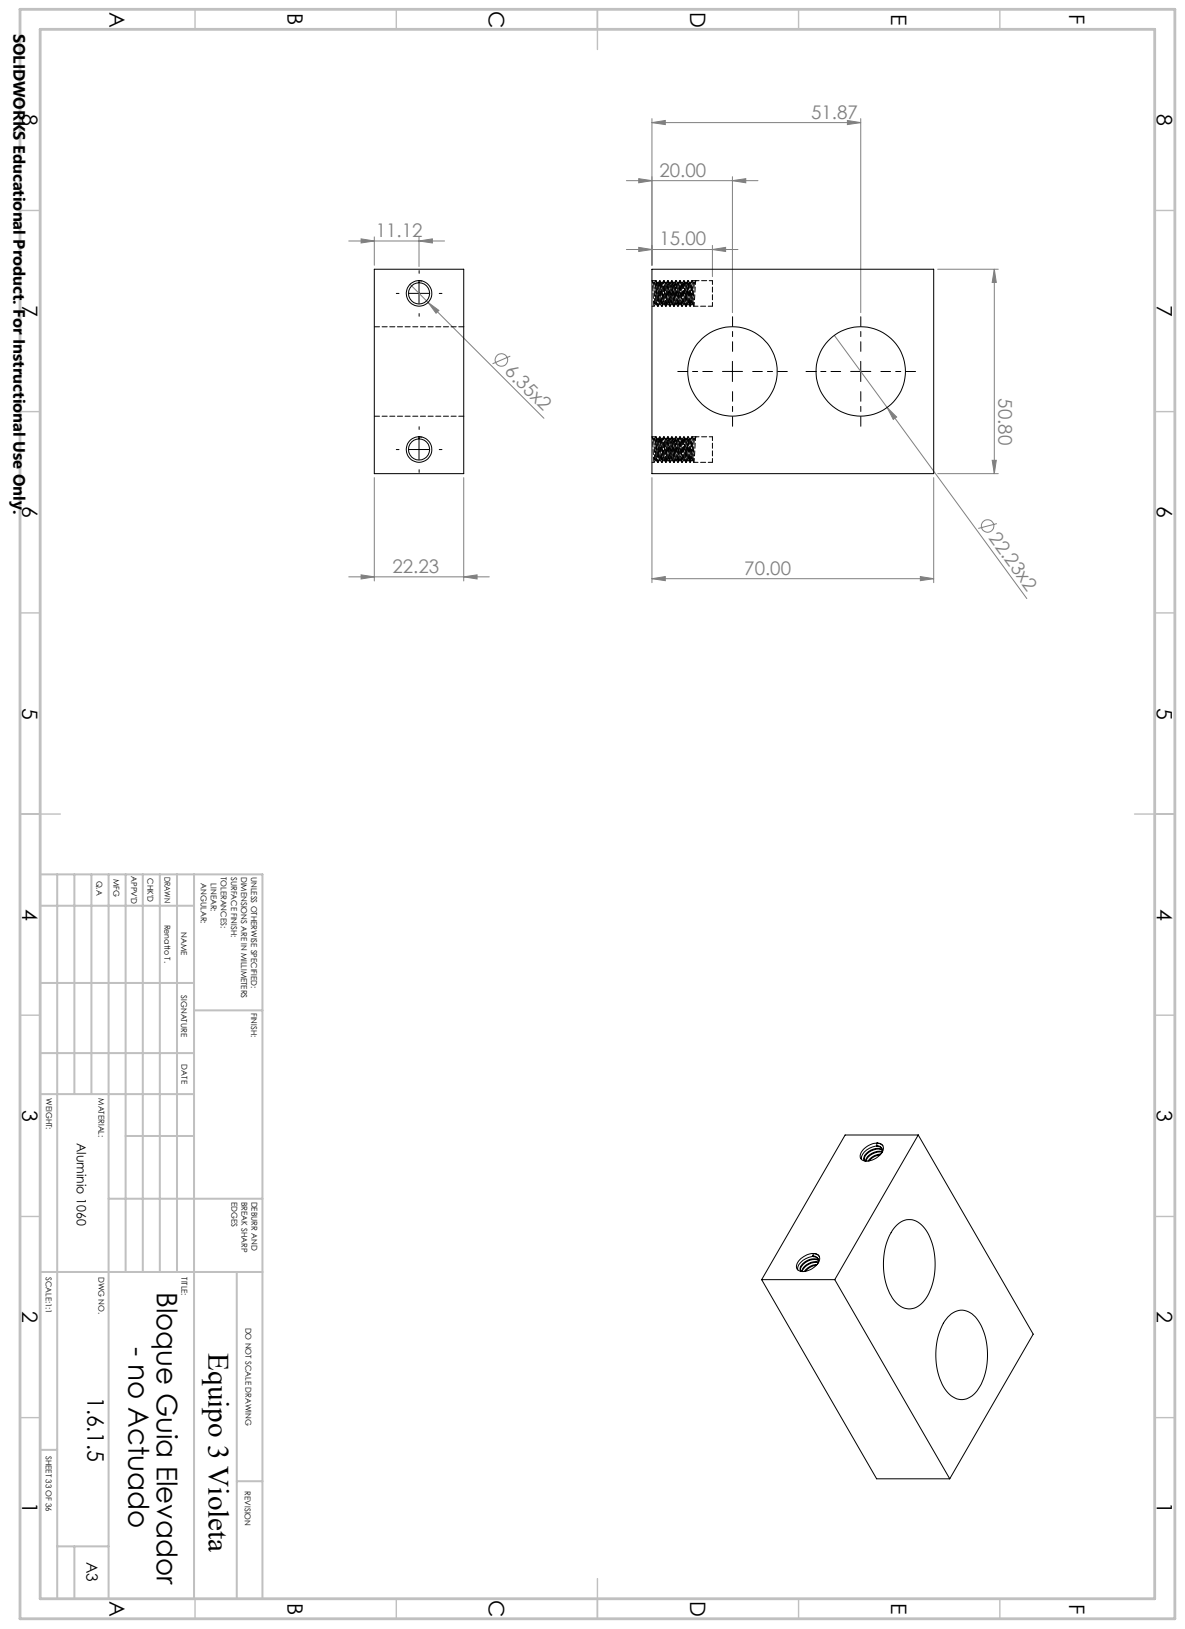
[picture p92: page 62]
MFG; APPV'D; CHK'D; DRAWN; ANGULAR:; LINEAR:; TOLERANCES:; SURFACE FINISH:; EDGES BREAK SHARP; DEBURR AND; MATERIAL:; SCALE:1:1; DWG NO.; TITLE:; SHEET 33 OF 36; A3 Aluminio 1060; WEIGHT:; Renatto T.; Equipo 3 Violeta; - no Actuado

SOLIDWORKS Educational Product. For Instructional Use Only.

DIMENSIONS ARE IN MILLIMETERS

UNLESS OTHERWISE SPECIFIED: FINISH:

NAME SIGNATURE DATE

Bloque Guia Elevador

DO NOT SCALE DRAWING REVISION

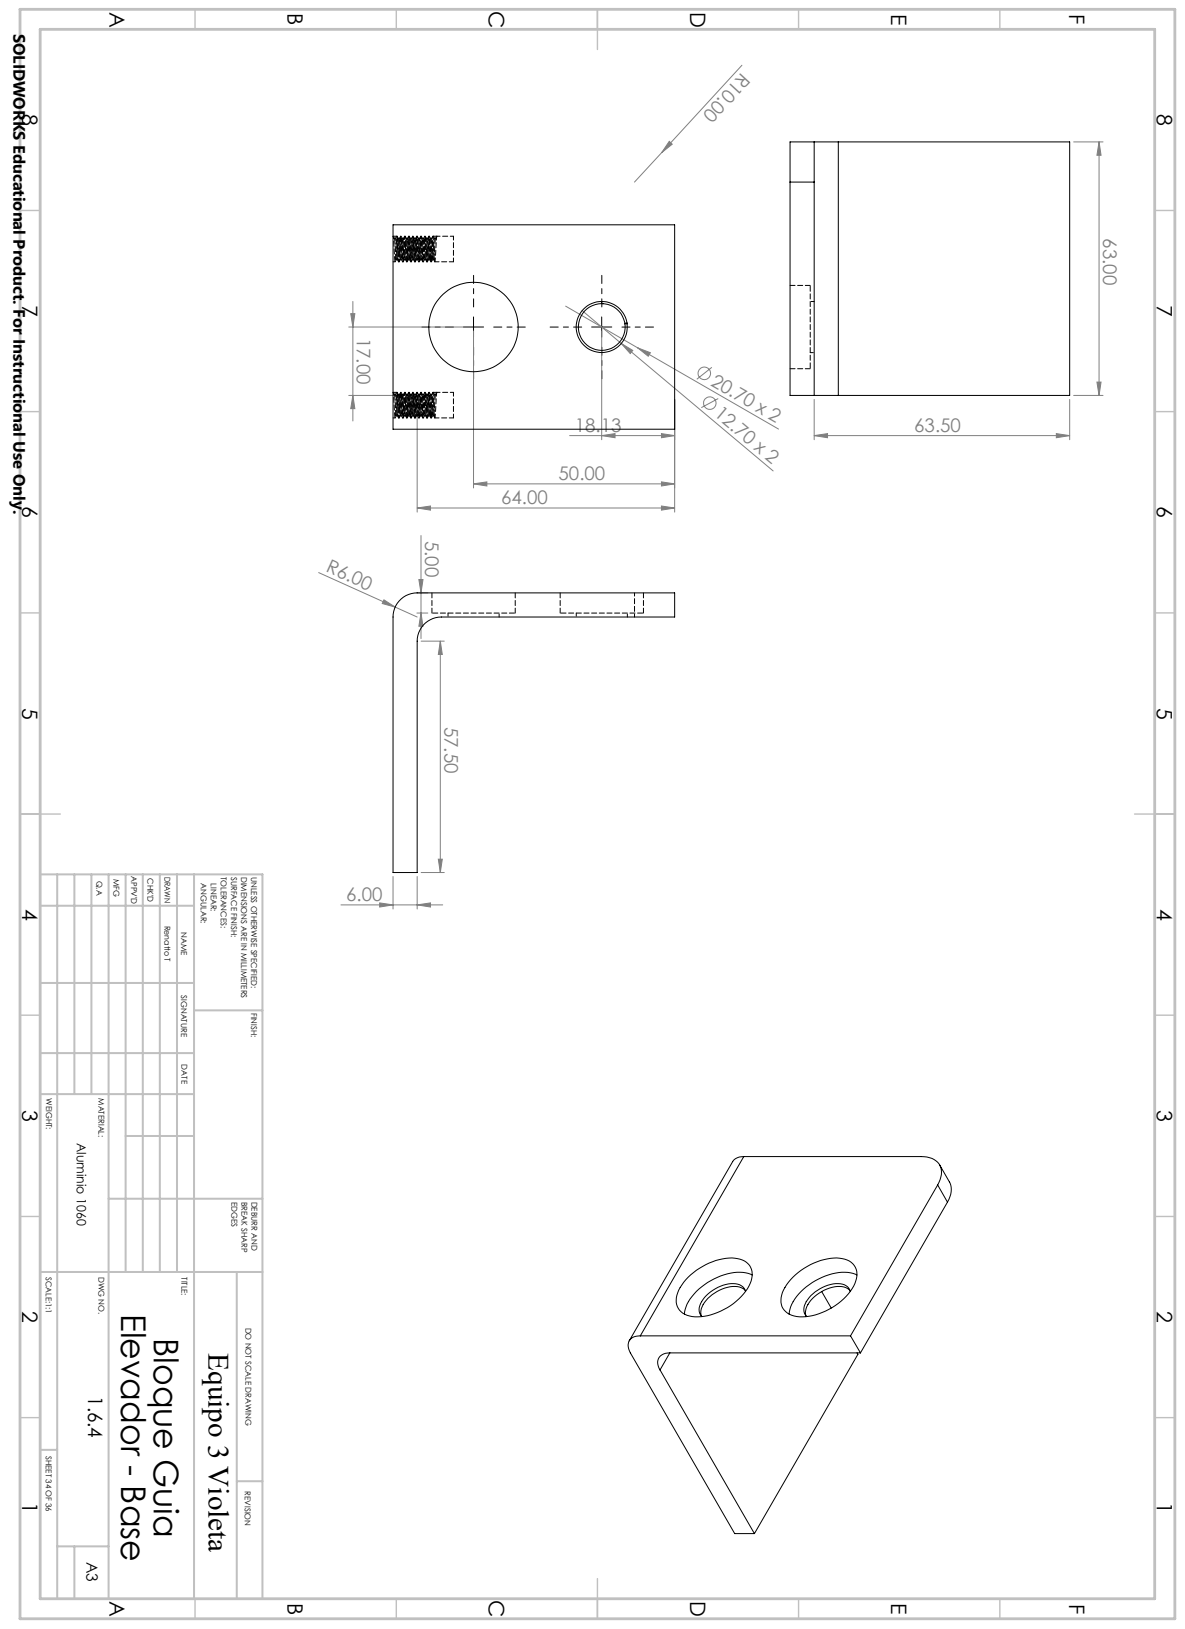
[picture p93: page 63]
MFG; APPV'D; CHK'D; DRAWN; ANGULAR:; LINEAR:; TOLERANCES:; SURFACE FINISH:; EDGES BREAK SHARP; DEBURR AND; MATERIAL:; SCALE:1:1; DWG NO.; TITLE:; SHEET 34 OF 36; A3 Aluminio 1060; WEIGHT:; Renatto T; Equipo 3 Violeta; Bloque Guia; Elevador - Base

SOLIDWORKS Educational Product. For Instructional Use Only.

DIMENSIONS ARE IN MILLIMETERS

UNLESS OTHERWISE SPECIFIED: FINISH:

NAME SIGNATURE DATE

DO NOT SCALE DRAWING REVISION

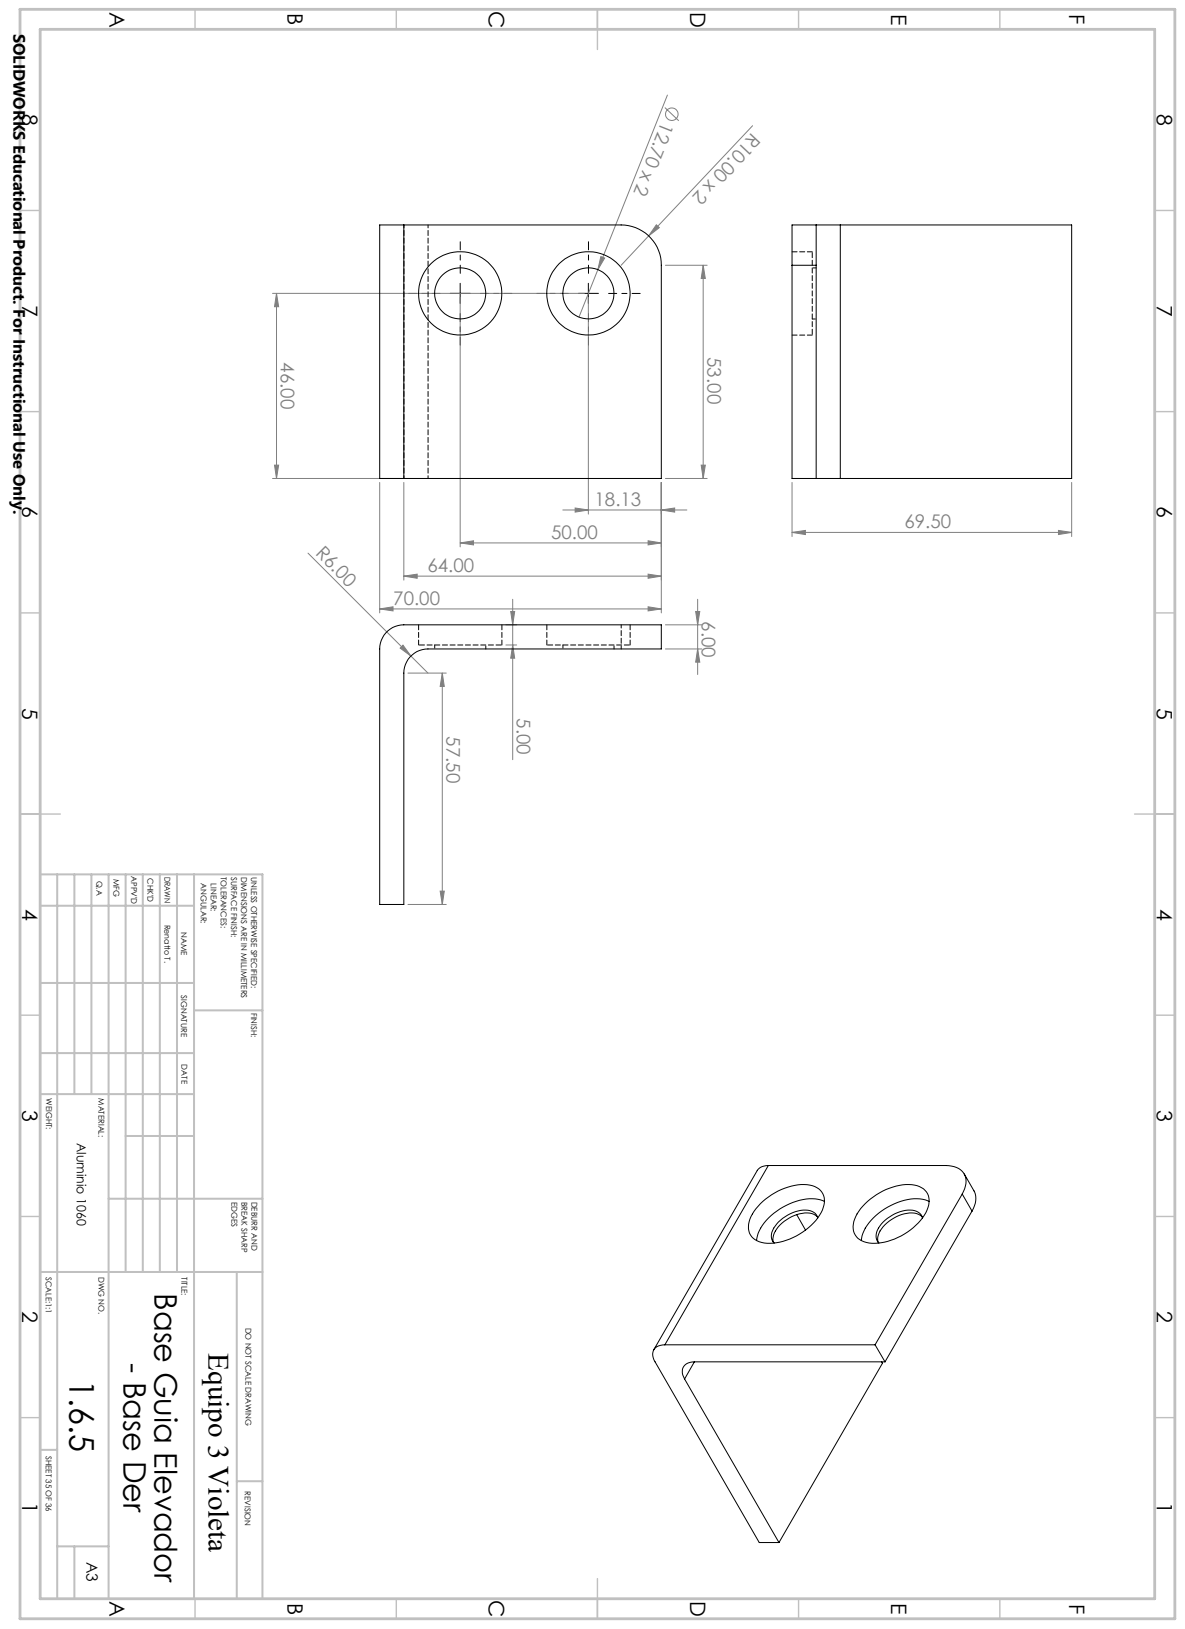
[picture p94: page 64]
MFG; APPV'D; CHK'D; DRAWN; ANGULAR:; LINEAR:; TOLERANCES:; SURFACE FINISH:; EDGES BREAK SHARP; DEBURR AND; MATERIAL:; SCALE:1:1; DWG NO.; TITLE:; SHEET 35 OF 36; A3 Aluminio 1060; WEIGHT:; Renatto T.; Equipo 3 Violeta; - Base Der

SOLIDWORKS Educational Product. For Instructional Use Only.

DIMENSIONS ARE IN MILLIMETERS

UNLESS OTHERWISE SPECIFIED: FINISH:

NAME SIGNATURE DATE

Base Guia Elevador

DO NOT SCALE DRAWING REVISION

63.50
51.87

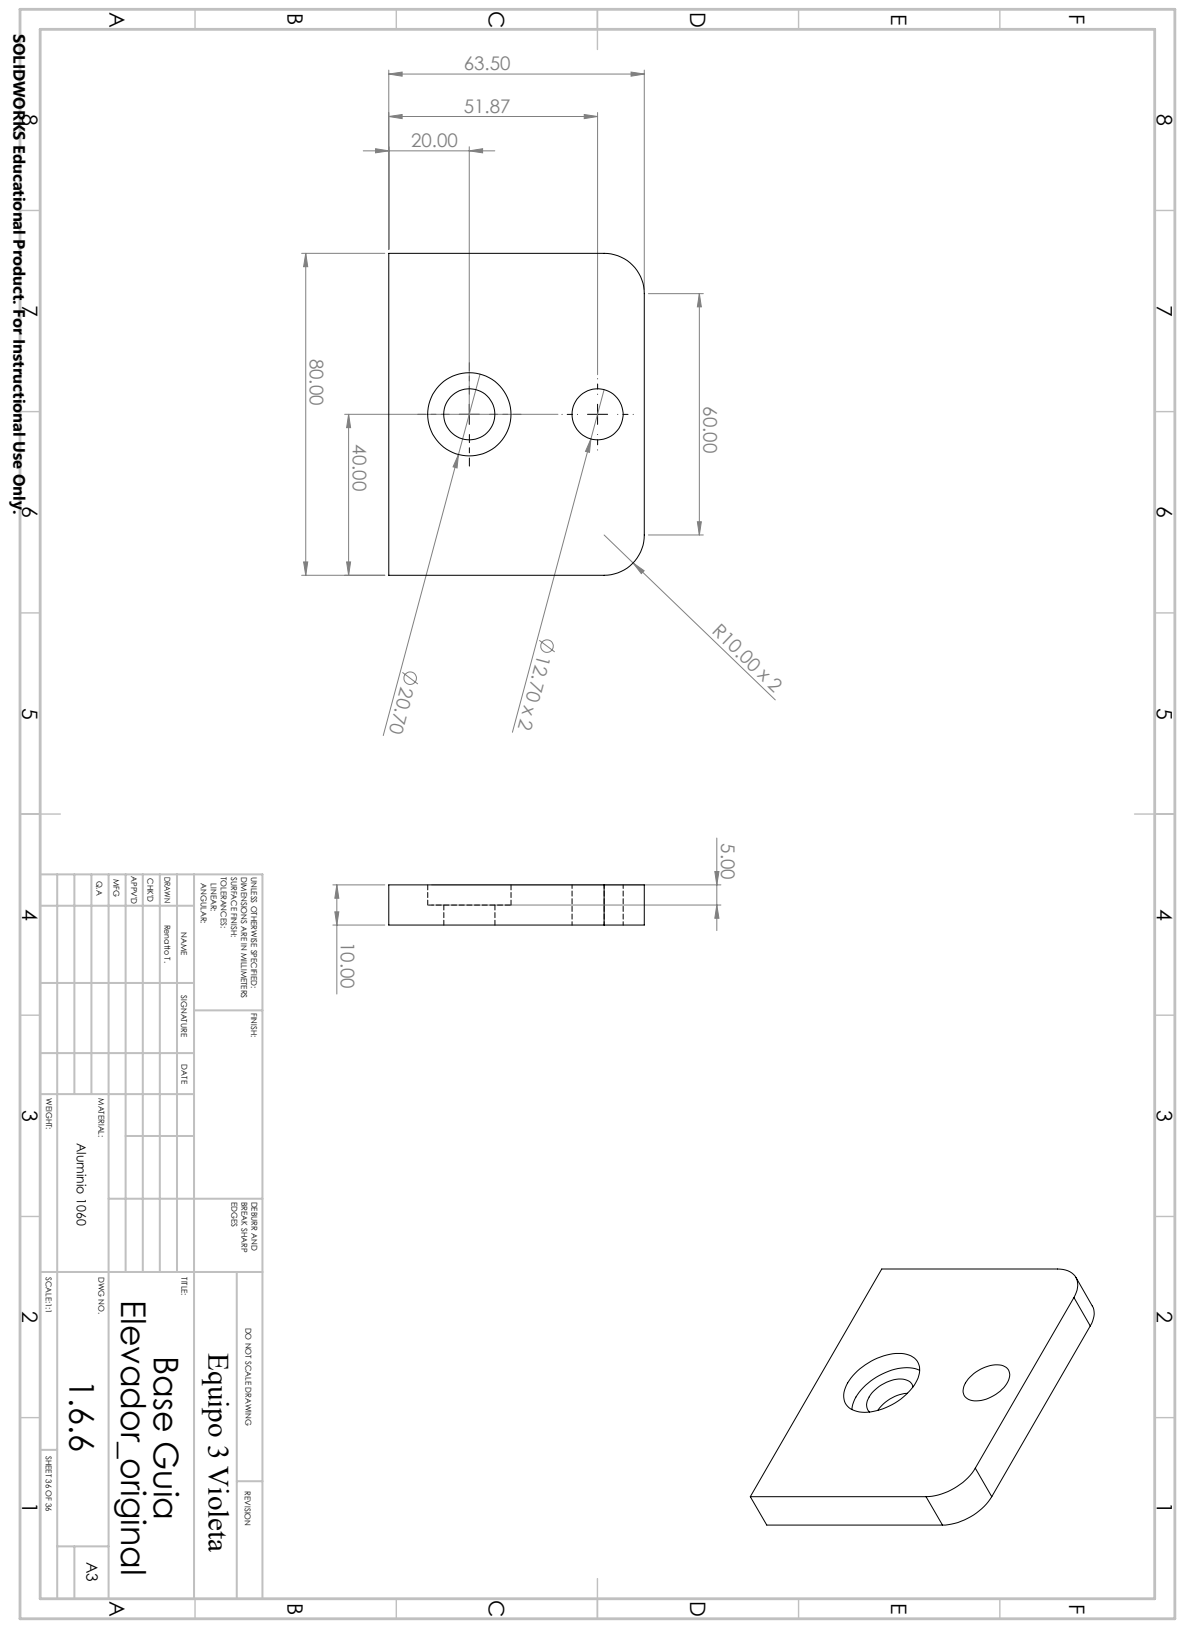
[picture p95: page 65]
MFG; APPV'D; CHK'D; DRAWN; ANGULAR:; LINEAR:; TOLERANCES:; SURFACE FINISH:; EDGES BREAK SHARP; DEBURR AND; MATERIAL:; SCALE:1:1; DWG NO.; TITLE:; SHEET 36 OF 36; A3 Aluminio 1060; WEIGHT:; Renatto T.; Equipo 3 Violeta; Base Guia; Elevador_original

SOLIDWORKS Educational Product. For Instructional Use Only.

DIMENSIONS ARE IN MILLIMETERS

UNLESS OTHERWISE SPECIFIED: FINISH:

NAME SIGNATURE DATE

DO NOT SCALE DRAWING REVISION
