riaj0224/DriverlessRoboticNurse_MrWas/Doc/informative_flyer.pdf

## Durante el 2020 el mundo se congeló; los negocios cerraron, las calles se vaciaron y los

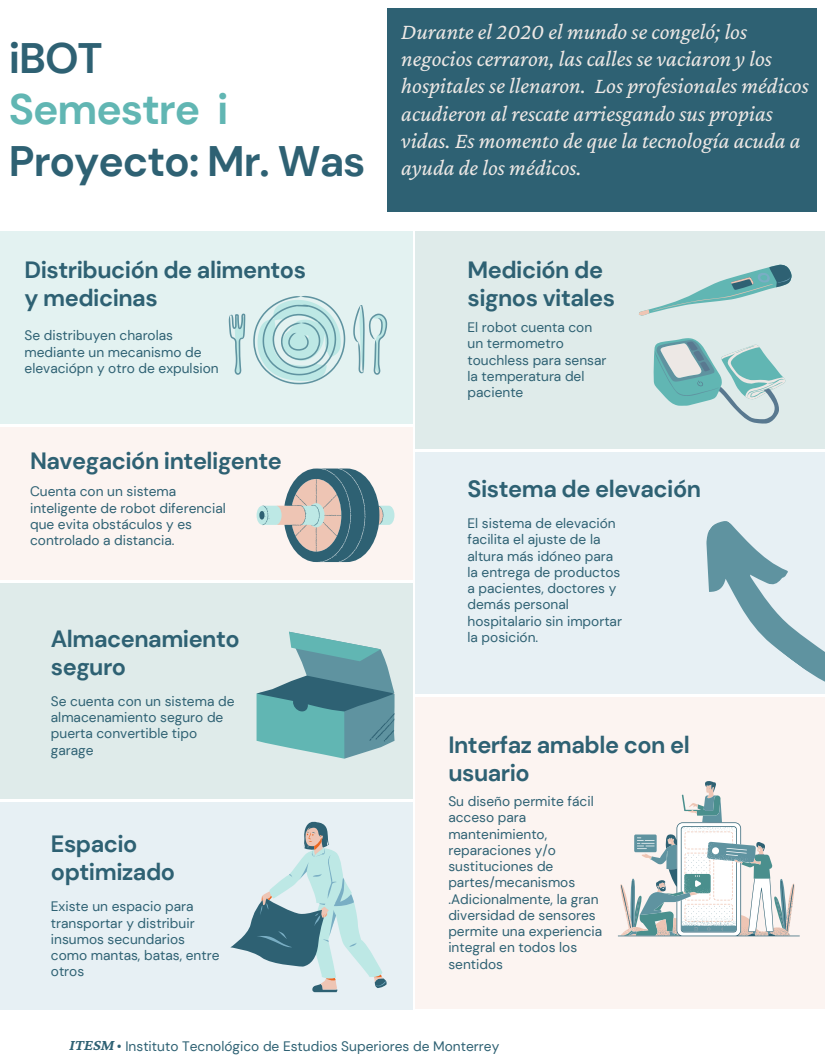
[picture p96: page 1]
Navegación inteligente; Medición de signos vitales; Almacenamiento seguro; garage; Interfaz amable con el; usuario; Espacio optimizado

iBOT
Semestre i
Proyecto: Mr. Was

hospitales se llenaron. Los profesionales médicos
acudieron al rescate arriesgando sus propias
vidas. Es momento de que la tecnología acuda a
ayuda de los médicos.

Distribución de alimentos
y medicinas

El robot cuenta con
un termometro
touchless para sensar
la temperatura del
paciente

Se distribuyen charolas
mediante un mecanismo de
elevaciópn y otro de expulsion

Sistema de elevación

Cuenta con un sistema
inteligente de robot diferencial
que evita obstáculos y es
controlado a distancia.

El sistema de elevación
facilita el ajuste de la
altura más idóneo para
la entrega de productos
a pacientes, doctores y
demás personal
hospitalario sin importar
la posición.

Se cuenta con un sistema de
almacenamiento seguro de
puerta convertible tipo

Su diseño permite fácil
acceso para
mantenimiento,
reparaciones y/o
sustituciones de
partes/mecanismos
.Adicionalmente, la gran
diversidad de sensores
permite una experiencia
integral en todos los
sentidos

Existe un espacio para
transportar y distribuir
insumos secundarios
como mantas, batas, entre
otros

ITESM • Instituto Tecnológico de Estudios Superiores de Monterrey

## SISTEMA DE INTERACCIÓN

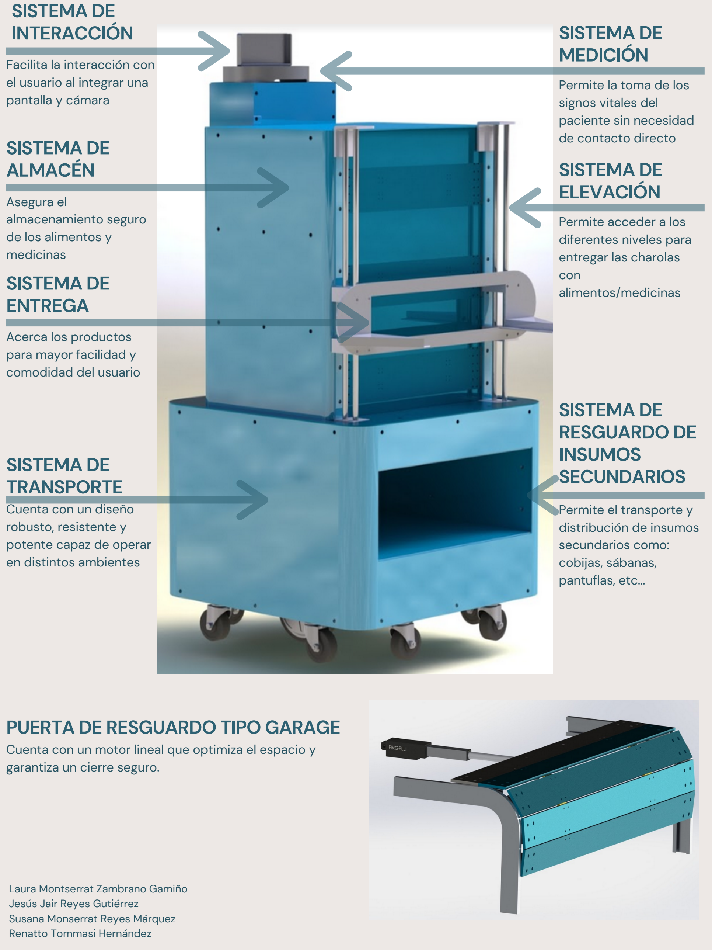
[picture p97: page 2]

Facilita la interacción con el usuario al integrar una pantalla y cámara

## SISTEMA DE MEDICIÓN

Permite la toma de los
signos vitales del
paciente sin necesidad
de contacto directo

## SISTEMA DE ELEVACIÓN

Permite acceder a los
diferentes niveles para
entregar las charolas
con
alimentos/medicinas

## SISTEMA DE ENTREGA

Acerca los productos
para mayor facilidad y
comodidad del usuario

## SISTEMA DE RESGUARDO DE INSUMOS SECUNDARIOS

Permite el transporte y
distribución de insumos
secundarios como:
cobijas, sábanas,
pantuflas, etc...

## SISTEMA DE ALMACÉN

Asegura el
almacenamiento seguro
de los alimentos y
medicinas

## SISTEMA DE TRANSPORTE

Cuenta con un diseño
robusto, resistente y
potente capaz de operar
en distintos ambientes

## PUERTA DE RESGUARDO TIPO GARAGE

Cuenta con un motor lineal que optimiza el espacio y garantiza un cierre seguro.

Laura Montserrat Zambrano Gamiño Jesús Jair Reyes Gutiérrez
Susana Monserrat Reyes Márquez Renatto Tommasi Hernández
