riaj0224/DriverlessRoboticNurse_MrWas/Prototipo3.2/Sources/system_IRQ.h

/*
 * system_IRQ.h
 *
 *  Created on: Oct 21, 2020
 *      Author: jair2
 */

#ifndef SYSTEM_IRQ_H_
#define SYSTEM_IRQ_H_

void FTM0_IRQHandler(void);
void PIT_IRQHandler(void);
void UART1_IRQHandler(void);


#endif /* SYSTEM_IRQ_H_ */
