riaj0224/DriverlessRoboticNurse_MrWas/Ejemplos/PIT/US_sensor.h

/*
 * US_sensor.h
 *
 *  Created on: Oct 2, 2020
 *      Author: nxf33313
 */

#ifndef US_SENSOR_H_
#define US_SENSOR_H_

void US_sensor_output_init (void);
void US_sensor_generate_pulse (void);

#endif /* US_SENSOR_H_ */
